charleslemaire0/TeenAstroHardware/MotorKit/NemaCovers/Nema23/ModelA/README.txt

Nema 23 & Nema 24 Motor Cover by IdefixRC on Thingiverse: https://www.thingiverse.com/thing:2481149
