charleslemaire0/TeenAstroHardware/Focuser/DrawingAluCase.png

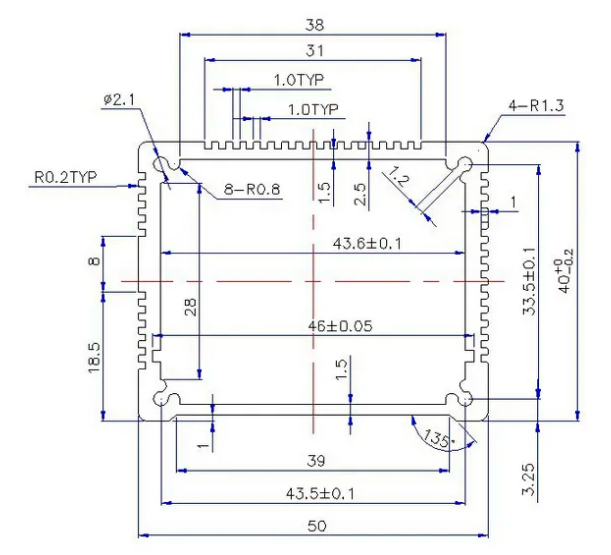
Focuser/DrawingAluCase.png
