charleslemaire0/TeenAstroHardware/Focuser/FocuserFrontPanel3D.png

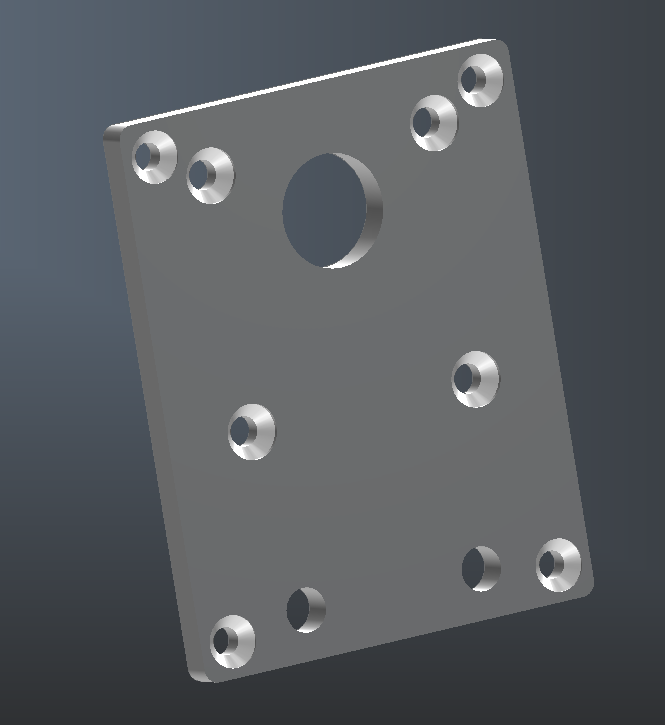
Focuser/FocuserFrontPanel3D.png
