charleslemaire0/TeenAstroHardware/Focuser/ZWO-Electronic-Automatic-Focuser-EAF-Standard-5V-.jpg

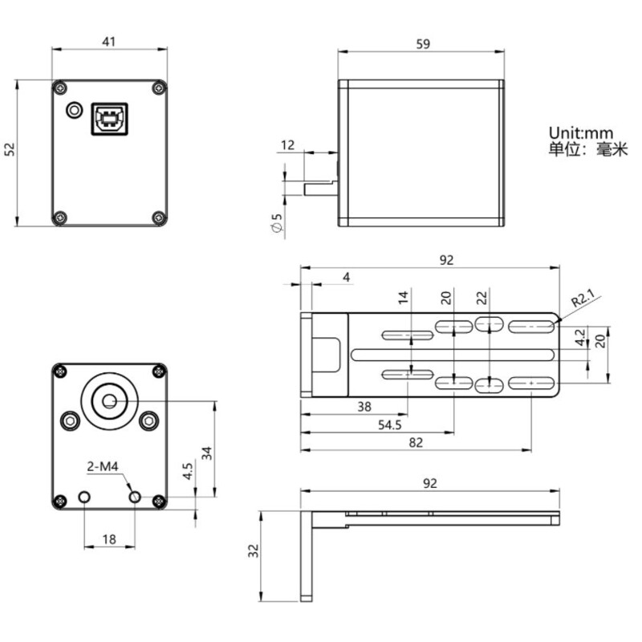
Focuser/ZWO-Electronic-Automatic-Focuser-EAF-Standard-5V-.jpg
