charleslemaire0/TeenAstroHardware/MainUnit/EQ6_Kit/V25/EQ6 - V2024_01/Doc/2_eclate.JPG

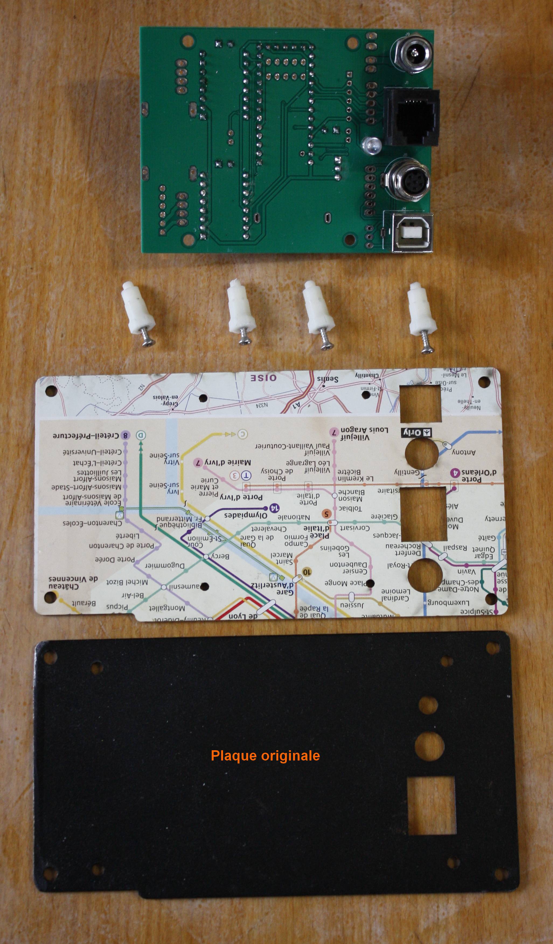
MainUnit/EQ6_Kit/V25/EQ6 - V2024_01/Doc/2_eclate.JPG
