charleslemaire0/TeenAstroHardware/MainUnit/EQ6_Kit/V25/EQ6 - V2024_01/Doc/Ci EQ6 dessus-dessous.jpg

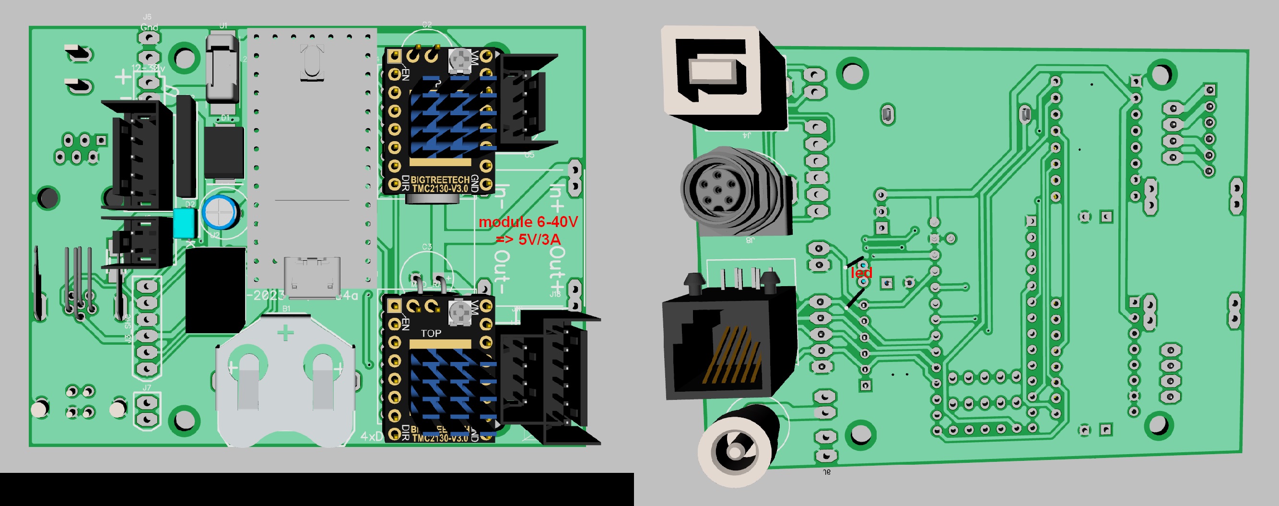
MainUnit/EQ6_Kit/V25/EQ6 - V2024_01/Doc/Ci EQ6 dessus-dessous.jpg
