charleslemaire0/TeenAstroHardware/MainUnit/EQ6_Kit/V25/EQ6 - V2024_01/Doc/TA EQ6 sur platine.jpg

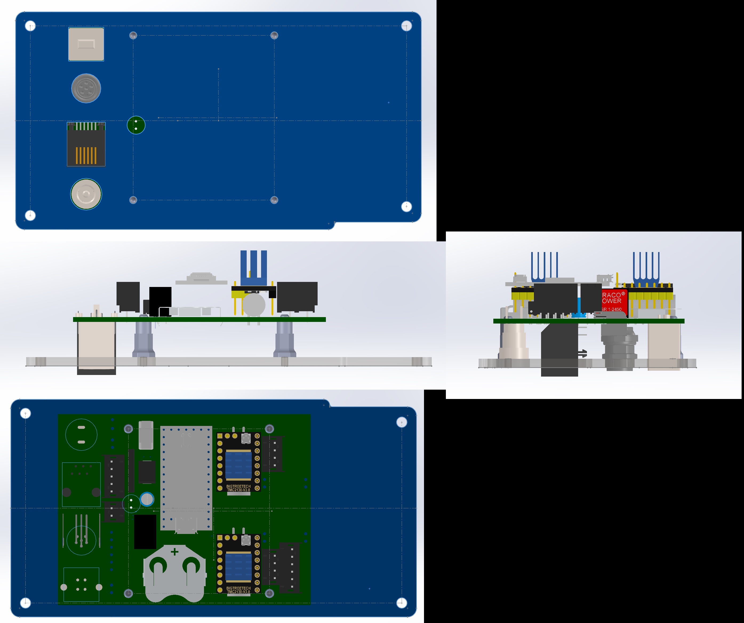
MainUnit/EQ6_Kit/V25/EQ6 - V2024_01/Doc/TA EQ6 sur platine.jpg
