charleslemaire0/TeenAstroHardware/MainUnit/Mini/V25/Eagle/TeenAstro_Mini_v253_M12_a3.png

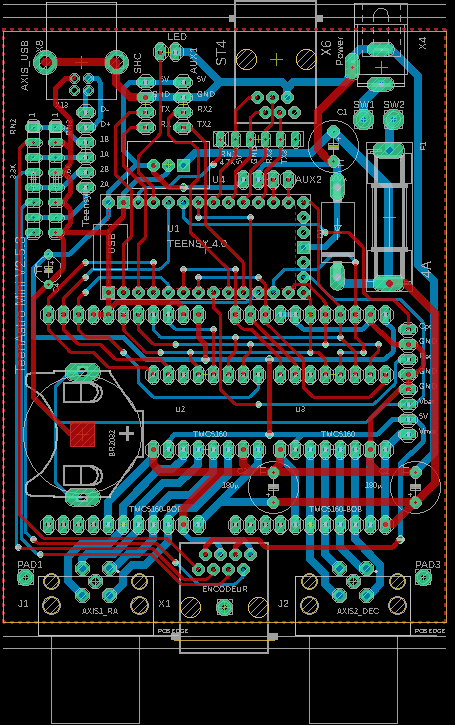
MainUnit/Mini/V25/Eagle/TeenAstro_Mini_v253_M12_a3.png
