charleslemaire0/TeenAstroHardware/MainUnit/Mini/V25/Fritzing/Geber/TeenAstroMiniV2.5.3_db9_pcb.jpg

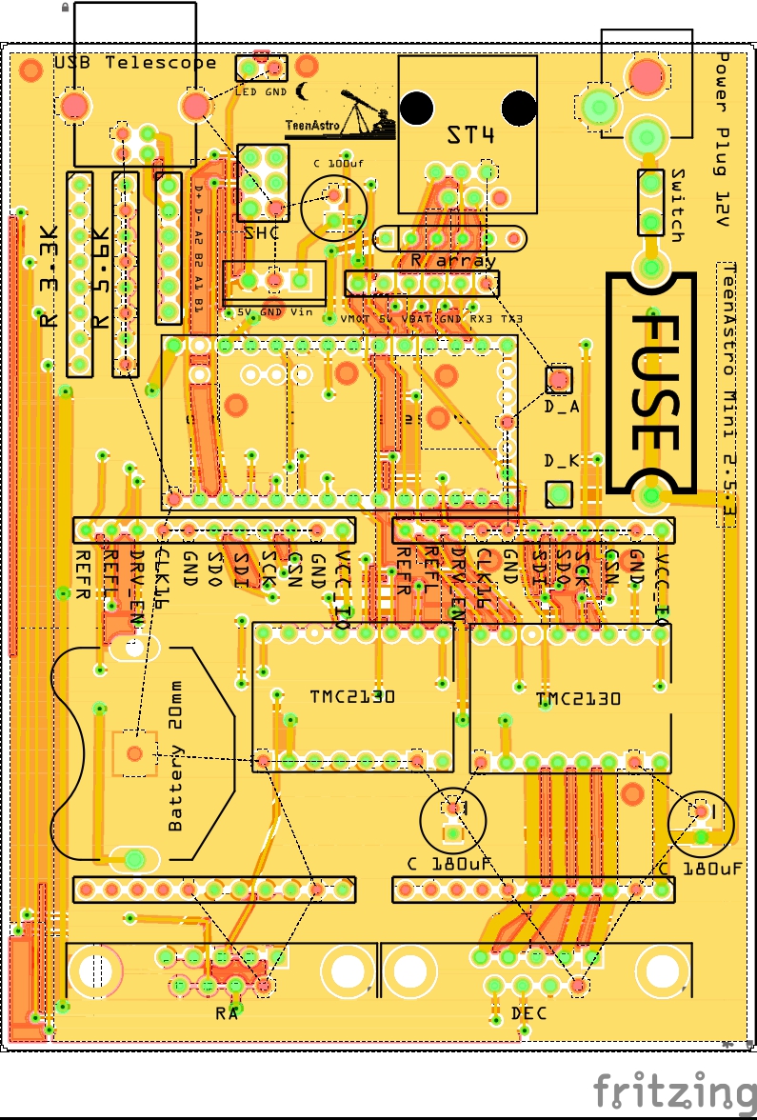
MainUnit/Mini/V25/Fritzing/Geber/TeenAstroMiniV2.5.3_db9_pcb.jpg
