charleslemaire0/TeenAstroHardware/MainUnit/Tiny/V25/Doc/Back.jpeg

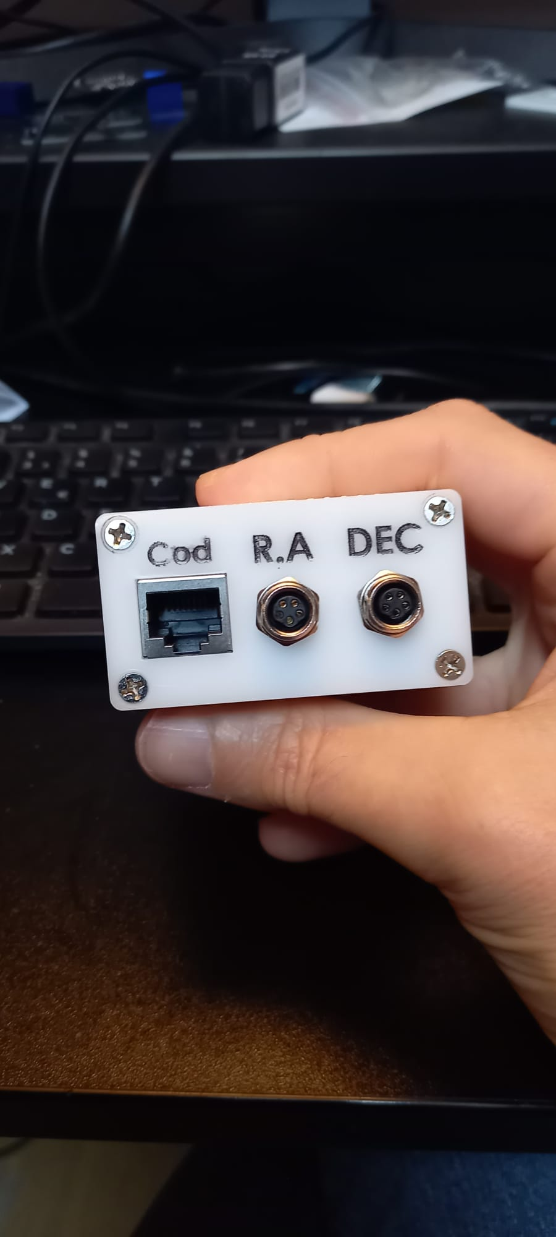
MainUnit/Tiny/V25/Doc/Back.jpeg
