charleslemaire0/TeenAstroHardware/MainUnit/Tiny/V25/Doc/Front.jpeg

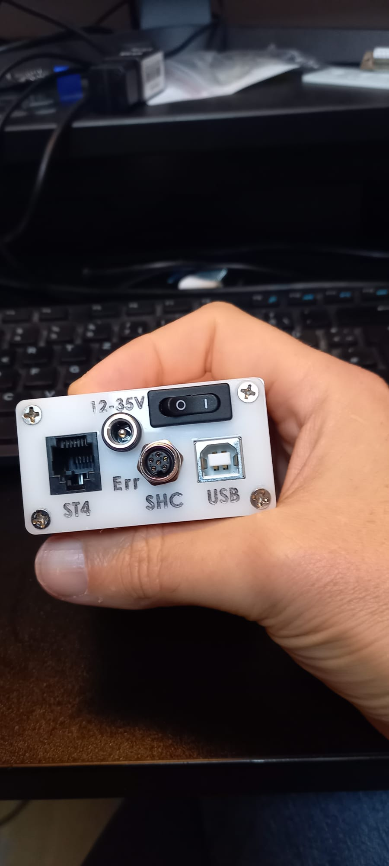
MainUnit/Tiny/V25/Doc/Front.jpeg
