charleslemaire0/TeenAstroHardware/MainUnit/Tiny/V25/Doc/MiniVsTiny.jpeg

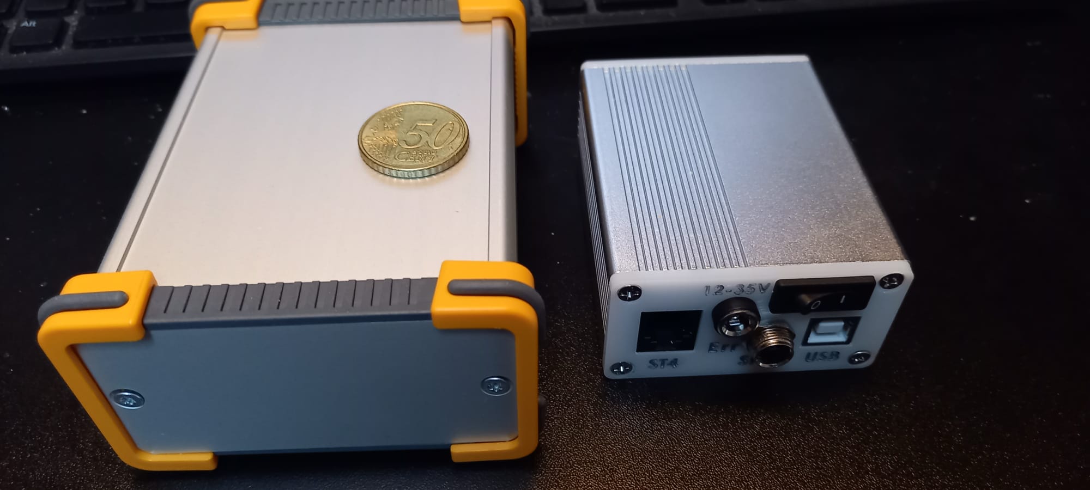
MainUnit/Tiny/V25/Doc/MiniVsTiny.jpeg
