charleslemaire0/TeenAstroHardware/MainUnit/Tiny/V25/Doc/tiny 250 a.JPG

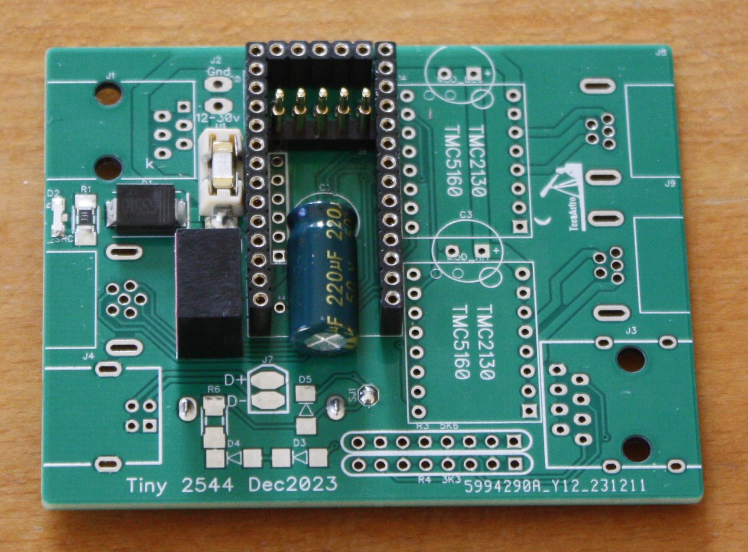
MainUnit/Tiny/V25/Doc/tiny 250 a.JPG
