charleslemaire0/TeenAstroHardware/MainUnit/Tiny/V25/Doc/Tiny 250 b.JPG

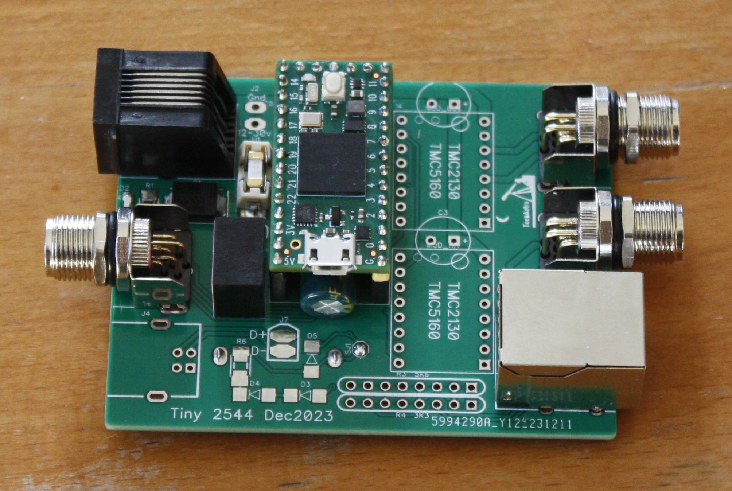
MainUnit/Tiny/V25/Doc/Tiny 250 b.JPG
