charleslemaire0/TeenAstroHardware/MainUnit/Tiny/V25/Doc/Tiny 250.jpg

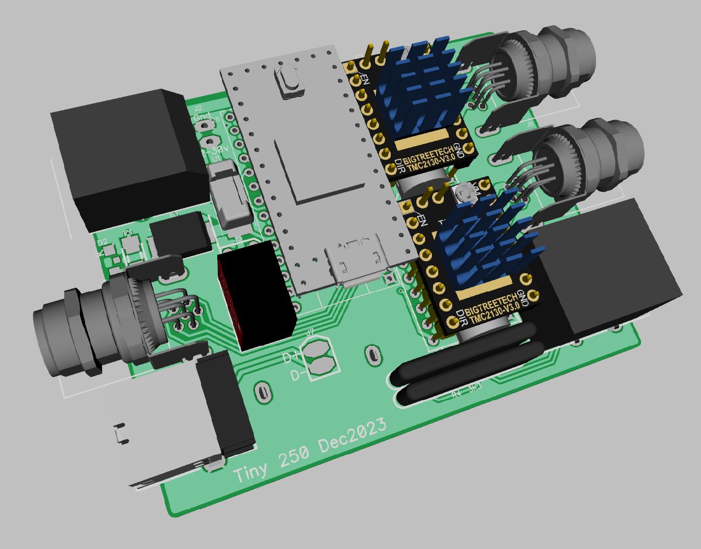
MainUnit/Tiny/V25/Doc/Tiny 250.jpg
