charleslemaire0/TeenAstroHardware/MainUnit/Tiny/V25/Doc/visuel tiny 2.png

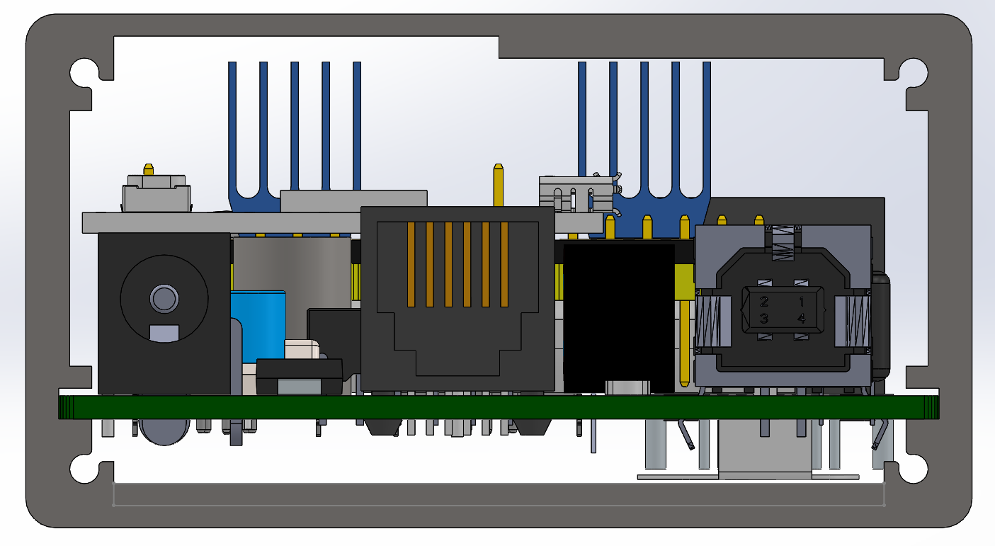
MainUnit/Tiny/V25/Doc/visuel tiny 2.png
