charleslemaire0/TeenAstroHardware/MainUnit/Tiny/V25/Source/DipTrace/Tiny 250.png

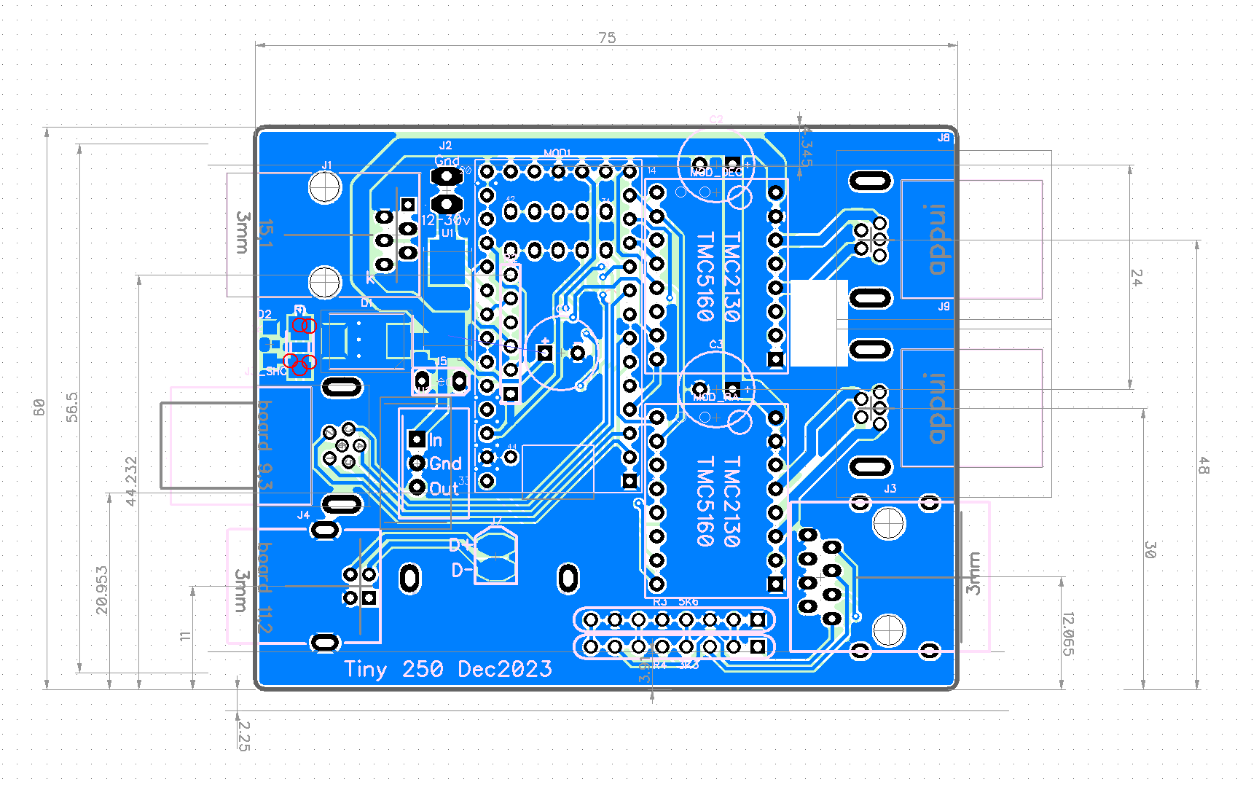
MainUnit/Tiny/V25/Source/DipTrace/Tiny 250.png
