charleslemaire0/TeenAstroHardware/MotorKit/NemaCovers/Nema17/Model A/Nema17Cover_A.png

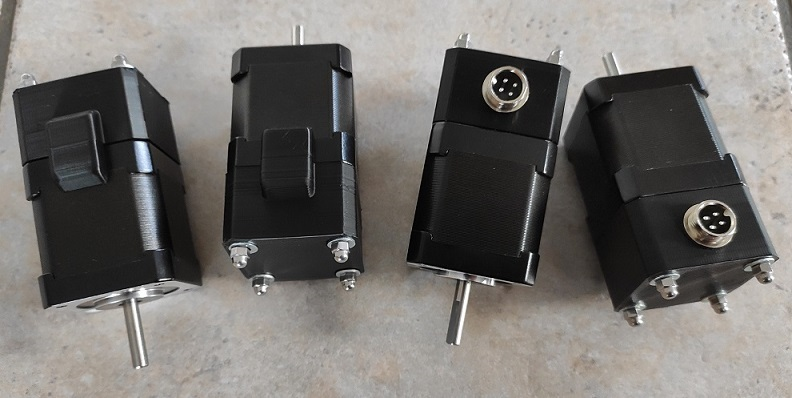
MotorKit/NemaCovers/Nema17/Model A/Nema17Cover_A.png
