charleslemaire0/TeenAstroHardware/MotorKit/NemaCovers/Nema23/ModelA/images/7e54231725088f2a09f0f0e1cd419129.jpg

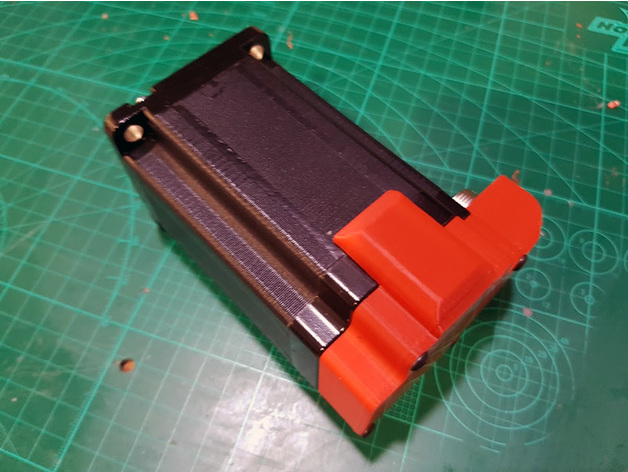
MotorKit/NemaCovers/Nema23/ModelA/images/7e54231725088f2a09f0f0e1cd419129.jpg
