charleslemaire0/TeenAstroHardware/MotorKit/NemaCovers/Nema23/ModelA/images/d00e7cbcc4604962befcf810bc58210a.jpg

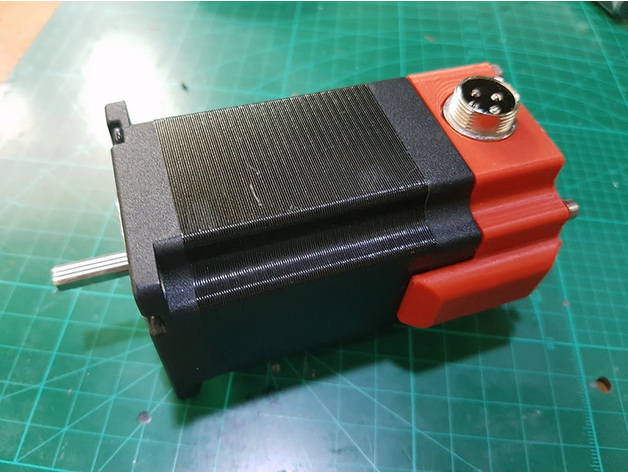
MotorKit/NemaCovers/Nema23/ModelA/images/d00e7cbcc4604962befcf810bc58210a.jpg
