charleslemaire0/TeenAstroHardware/MotorKit/NemaCovers/Nema23/ModelA/images/dcd5c36b3a7b25e8f30bb5cd8e7d59ce.jpg

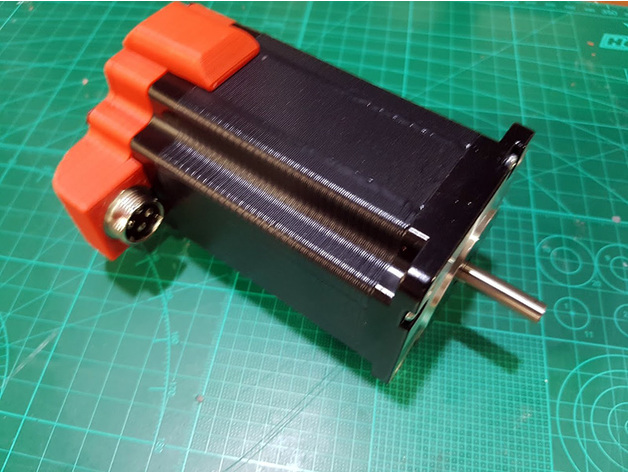
MotorKit/NemaCovers/Nema23/ModelA/images/dcd5c36b3a7b25e8f30bb5cd8e7d59ce.jpg
