charleslemaire0/TeenAstroHardware/MotorKit/NemaCovers/Nema23/ModelA/images/ebb65c65be9420c12031e5c384ebb469.jpg

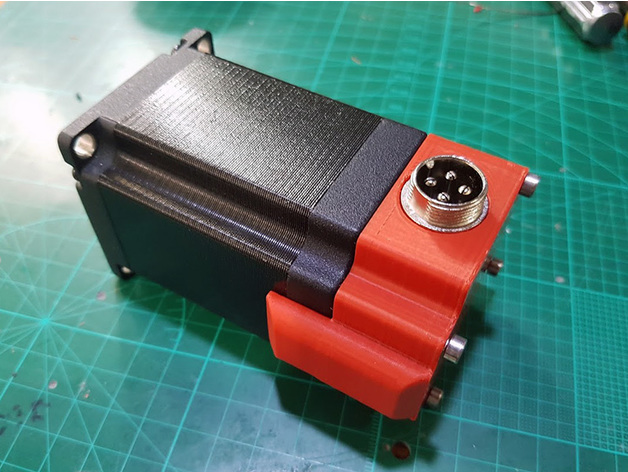
MotorKit/NemaCovers/Nema23/ModelA/images/ebb65c65be9420c12031e5c384ebb469.jpg
