charleslemaire0/TeenAstroHardware/MotorKit/NemaCovers/Nema23/ModelA/images/Motor_Cover_Nema23_straight.jpg

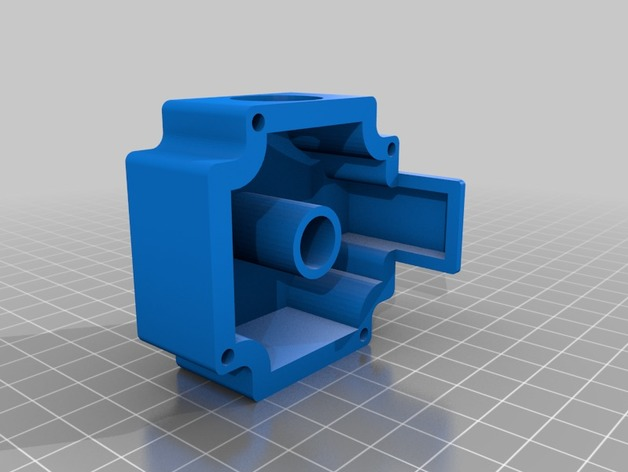
MotorKit/NemaCovers/Nema23/ModelA/images/Motor_Cover_Nema23_straight.jpg
