charleslemaire0/TeenAstroHardware/SHC/V1/PCB/Schematic_SHC.png

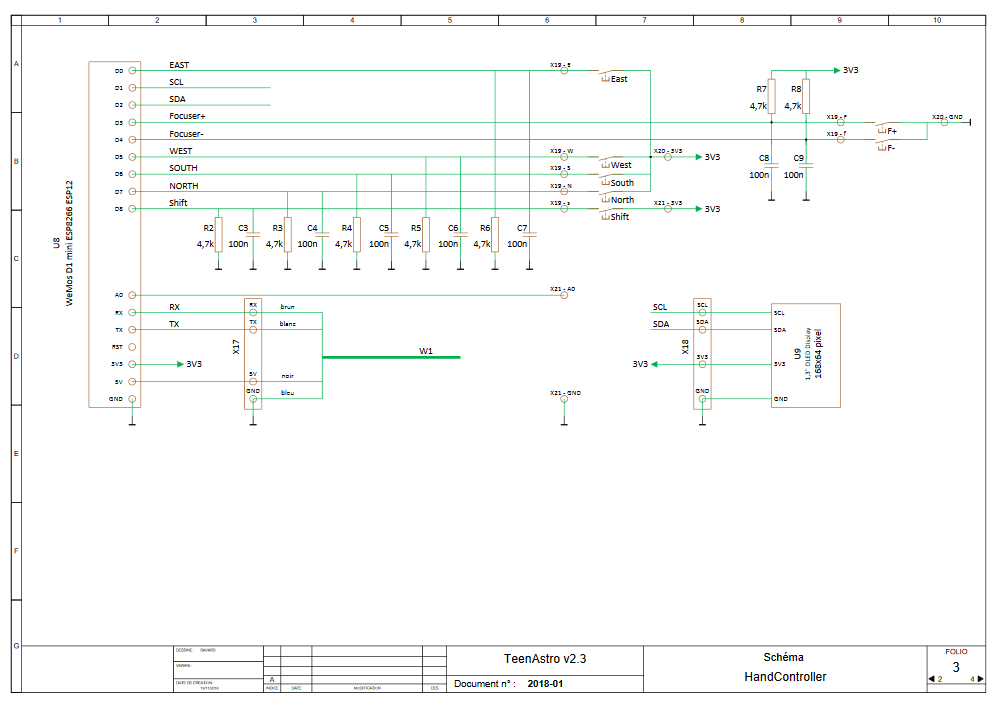
SHC/V1/PCB/Schematic_SHC.png
