charleslemaire0/TeenAstroHardware/SHC/V1/PCB/TeenAstroHand.jpg

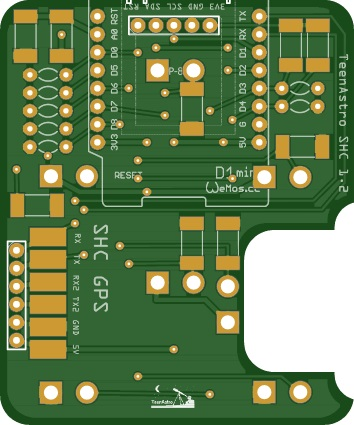
SHC/V1/PCB/TeenAstroHand.jpg
