charleslemaire0/TeenAstroHardware/MainUnit/Tiny/V25/Doc/Tiny BOM.ods

Ref | Tiny V2.5.0(teensy 4.0)
 | Chez Reichelt
 | CR 1632 Pile bouton au lithium, 3 V, 125 mAh, 16 x 3,2 mm (https://www.reichelt.de/de/fr/pile-bouton-au-lithium-3-v-125-mah-16-x-3-2-mm-cr-1632-p26546.html) |  | 1 |  |  | https://www.reichelt.de/de/fr/pile-bouton-au-lithium-3-v-125-mah-16-x-3-2-mm-cr-1632-p26546.html
D2 | LED SIDE3020 RT LED, CMS 3020, latérale, 112 mcd, rouge | 0.10 | 1 | 1 | 0.10 | https://www.reichelt.de/de/fr/led-cms-3020-lat-rale-112-mcd-rouge-led-side3020-rt-p156243.html
U1 | LITT 0154005.DR support avec fusible 5A fast | 1.15 | 1 |  | 1.15 | https://www.reichelt.de/de/fr/index.html?ACTION=446&LA=446&nbc=1&q=litt%200154005.dr
J1 | MEBP 6-6S Fiche intégrée modulaire RJ12 6/6, noire (https://www.reichelt.de/de/fr/fiche-int-gr-e-modulaire-6-6-noire-mebp-6-6s-p11370.html?&nbc=1) | 0.35 | 1 | 1 | 0.35 | https://www.reichelt.de/de/fr/fiche-int-gr-e-modulaire-6-6-noire-mebp-6-6s-p11370.html?&nbc=1
 | MPE 087-1-050 Barrette mâle 2,54 mm, 1× 50 – h12,6mm -6,8mm (https://www.reichelt.de/de/fr/barrette-m-le-2-54-mm-1-x-50-droite-mpe-087-1-050-p119891.html?&nbc=1) | 0.96 | 2 | 0 | 1.92 | https://www.reichelt.de/de/fr/barrette-m-le-2-54-mm-1-x-50-droite-mpe-087-1-050-p119891.html?&nbc=1
 | MPE 115-1-050 Barrette femelle de précisionH7mmX 50, dr oit 1×× (https://www.reichelt.de/de/fr/barrette-femelle-de-pr-cision-2-54-mm-1-x-50-droite-mpe-115-1-050-p187284.html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) | 4.00 | 2 | 0 | 8.00 | https://www.reichelt.de/de/fr/barrette-femelle-de-pr-cision-2-54-mm-1-x-50-droite-mpe-115-1-050-p187284.html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
C2, C3 | RAD FC 180/50 Condo électroAl 180 uF/50V 147mohm Ø8,2x21,5 (https://www.reichelt.de/de/fr/condensateurs-lectrolytiques-aluminium-180-uf-rad-fc-180-50-p84632.html?nbc=1) | 0.56 | 2 | 1 | 1.12 | https://www.reichelt.de/de/fr/condensateurs-lectrolytiques-aluminium-180-uf-rad-fc-180-50-p84632.html?nbc=1
C1 | RAD LXZ 50/100 Elko radial, 100µF, 50V, 105°C, Low ESR 120-248mes mOhm, 8,1 x 12,7- 3,5 (https://www.reichelt.de/de/fr/elko-radial-100-f-50-v-105-c-low-esr-8-x-12-mm-rm-3-5-rad-lxz-50-100-p166421.html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) | 0.22 | 1 | 1 | 0.22 | https://www.reichelt.de/de/fr/elko-radial-100-f-50-v-105-c-low-esr-8-x-12-mm-rm-3-5-rad-lxz-50-100-p166421.html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
D1 | S3D TSC 200V 3A-100A SMC | 0.25 | 1 | 1 | 0.25 | https://www.reichelt.de/de/fr/diode-de-redressement-200-v-3-a-smc-s3d-tsc-p216610.html?trstct=pos_1&nbc=1
R2 | SIL 6-5 4,7K Réseau de résistances SIL 4.7 kO ± 2 % (https://www.reichelt.de/de/fr/r-seau-de-r-sistances-sil-4-7-ko-2--sil-6-5-4-7k-p17821.html?&nbc=1) | 0.07 | 1 | 1 | 0.07 | https://www.reichelt.de/de/fr/r-seau-de-r-sistances-sil-4-7-ko-2--sil-6-5-4-7k-p17821.html?&nbc=1
R4 | SIL 8-4 3,3K Réseau de résistances SIL 3.3 kO ± 2 % (https://www.reichelt.de/de/fr/r-seau-de-r-sistances-sil-3-3-ko-2--sil-8-4-3-3k-p17925.html?&nbc=1) | 0.10 | 1 | 1 | 0.10 | https://www.reichelt.de/de/fr/r-seau-de-r-sistances-sil-3-3-ko-2--sil-8-4-3-3k-p17925.html?&nbc=1
R3 | SIL 8-4 5,6K Réseau de résistances SIL 5.6 kO ± 2 % (https://www.reichelt.de/de/fr/r-seau-de-r-sistances-sil-5-6-ko-2--sil-8-4-5-6k-p17940.html?&nbc=1) | 0.10 | 1 | 1 | 0.10 | https://www.reichelt.de/de/fr/r-seau-de-r-sistances-sil-5-6-ko-2--sil-8-4-5-6k-p17940.html?&nbc=1
MOD1 | TEENSY 4.0 Teensy 4.0, USB, sans en-tête (https://www.reichelt.de/de/fr/teensy-4-0-usb-sans-en-t-te-teensy-4-0-p269006.html?&nbc=1) | 29.75 | 1 | 1 | 29.75 | https://www.reichelt.de/de/fr/teensy-4-0-usb-sans-en-t-te-teensy-4-0-p269006.html?&nbc=1
U2 | Traco TSR 2-2450 Convertisseur c.c./c.c., 2 A, 5 V c.c. (https://www.reichelt.de/de/fr/convertisseur-c-c-c-c-2-a-5-v-c-c--tsr-2-2450-p193097.html?&nbc=1) | 13.13 | 1 | 0 | 13.13 | https://www.reichelt.de/de/fr/convertisseur-c-c-c-c-2-a-5-v-c-c--tsr-2-2450-p193097.html?&nbc=1
J4 | USB BW Prise femelle pour appareil USB type b 4P (https://www.reichelt.de/de/fr/prise-femelle-pour-appareil-usb-type-b-4p-usb-bw-p22186.html?&nbc=1) | 0.35 | 1 | 1 | 0.35 | https://www.reichelt.de/de/fr/prise-femelle-pour-appareil-usb-type-b-4p-usb-bw-p22186.html?&nbc=1
R1 | VIT ZC207 280R - MELF Resistor, 0207, 280 Ohm, 1 W, 1% (https://www.reichelt.de/de/fr/r-sistance-melf-0207-280-ohms-1-w-1--vit-zc207-280r-p277857.html) | 0.13 | 1 |  | 0.13 | https://www.reichelt.de/de/fr/r-sistance-melf-0207-280-ohms-1-w-1--vit-zc207-280r-p277857.html
 | WIPPE 1901.1103 Interrupteurs étroit à bascule 1P 6 A AC1 250 VAC (https://www.reichelt.de/de/fr/interrupteurs-bascule-1p-6-a-ac1-250-vac-wippe-1901-1103-p108251.html?nbc=1) | 1.66 | 1 | 1 | 1.66 | https://www.reichelt.de/de/fr/prise-femelle-pour-appareil-usb-type-b-4p-usb-bw-p22186.html?&nbc=1
 | Chez Aliexpress
 | boitier alu Tiny 75*62*35 /4 | 6.64 | 1 |  | 6.64 | /item/1867710921
 | Cable M8-6pin M to M 2m | 21.1 | 1 | 0 | 21.10 | https://fr.aliexpress.com/item/1005005256945807.html
J8, J9 | M8-5pin pcb mount -Angled Female, 5Pin B Type | 8.255 | 2 |  | 16.51 | item/1005003311923102.html
J3 | M8-6pin pcb mount -Angled Female, 6Pin | 12.61 | 1 |  | 12.61 | item/1005003311923102.html
 | Pogo 11,5mm 5 pin pour liaison encodeur | 1.655 | 1 |  | 1.66 | https://fr.aliexpress.com/item/1005005380466642.html
J2 | Prise c.c. - Panel mount - DC-022B, 10PCS, 5.5X2.5MM | 1.13 | 1 |  | 1.13 | https://fr.aliexpress.com/item/1005004637388048.html
J3 | RJ45 8P8C /5 | 0.56 | 1 |  | 0.56 | Item/1005004718158563
B1 | Support de pile bouton, 10 pièces, CR1632 | 3.07 | 1 | 1 | 3.07 | https://fr.aliexpress.com/item/4000505055015.html
MOD_DEC, MOD_RA | TMC2130 | 5.87 | 2 | choix | 11.74 | https://fr.aliexpress.com/item/1005001540781583.html
 | TMC5160 SPI 4 mosfet proche de la version reilchelt OK | 11.375 | 2 | choix | 22.75 | https://fr.aliexpress.com/item/1005004609091020.html
 | TMC5160 SPI 8 mosfet | 15.18 | 2 | choix | 30.36 | https://fr.aliexpress.com/item/1005005219358395.html
 | Alternative source
U1 | Fusible 1808-4A /10 | 0.12 | 2 |  | 0.23 | https://fr.aliexpress.com/item/33048094198
U1 | Support Fusible 1808 /10 | 0.15 | 1 |  | 0.15 | https://fr.aliexpress.com/item/33048094198
U2 | Traco TSR 1-2450 par5 | 2.388 | 1 |  | 2.39 | https://fr.aliexpress.com/item/1005004376426371.html
