charleslemaire0/TeenAstroHardware/MainUnit/EQ6_Kit/V25/EQ6 - V2024_01/Doc/BOM EQ6.ods

EQ6 V2.5.0 (teensy 4.0)
 |  | Reichelt |  | 61.39
B1 | BR 2032 Pile bouton au lithium, 3 V, 180 mAh, 20,0 x 3,2 mm (https://www.reichelt.de/de/fr/pile-bouton-au-lithium-3-v-180-mah-20-0-x-3-2-mm-br-2032-p5827.html?nbc=1) | 1.21 | 1 | 1.21 | https://www.reichelt.de/de/fr/led-avec-r-sistance-en-s-rie-rouge-3-mm-5-volts-led-3mm-5v-rt-p54090.html?nbc=1
B1 | KZH 20P Clip de pile bouton, pour circuit imprimé (https://www.reichelt.de/de/fr/clip-de-pile-bouton-pour-circuit-imprim--kzh-20p-p56575.html?&nbc=1) | 0.41 | 1 | 0.41 | https://www.reichelt.de/de/fr/led-avec-r-sistance-en-s-rie-rouge-3-mm-5-volts-led-3mm-5v-rt-p54090.html?nbc=1
C1 | RAD LXZ 50/100 Elko radial, 100µF, 50V, 105°C, Low ESR 120-248mes mOhm, 8,1 x 12,7- 3,5 (https://www.reichelt.de/de/fr/elko-radial-100-f-50-v-105-c-low-esr-8-x-12-mm-rm-3-5-rad-lxz-50-100-p166421.html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) | 0.22 | 1 | 0.22 | https://www.reichelt.de/de/fr/elko-radial-100-f-50-v-105-c-low-esr-8-x-12-mm-rm-3-5-rad-lxz-50-100-p166421.html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
C2,C3 | RAD FC 180/50 Condo électroAl 180 uF/50V 147mohm Ø8,2x21,5 (https://www.reichelt.de/de/fr/condensateurs-lectrolytiques-aluminium-180-uf-rad-fc-180-50-p84632.html?nbc=1) | 0.56 | 2 | 1.12 | https://www.reichelt.de/de/fr/condensateurs-lectrolytiques-aluminium-180-uf-rad-fc-180-50-p84632.html?nbc=1
D1 | S3D TSC 200V 3A-100A SMC | 0.25 | 1 | 0.25 | https://www.reichelt.de/de/fr/diode-de-redressement-200-v-3-a-smc-s3d-tsc-p216610.html?trstct=pos_1&nbc=1
D2 | LED 3MM 5V RT LED avec résistance en série rouge 3 mm, 5 volts (https://www.reichelt.de/de/fr/led-avec-r-sistance-en-s-rie-rouge-3-mm-5-volts-led-3mm-5v-rt-p54090.html?nbc=1) | 0.60 | 1 | 0.60 | https://www.reichelt.de/de/fr/led-avec-r-sistance-en-s-rie-rouge-3-mm-5-volts-led-3mm-5v-rt-p54090.html?nbc=1
D2 | EBF A-3 Culot d"installation pour LED 3 mm, réflecteur extérieur, chrome (https://www.reichelt.de/de/fr/culot-d-installation-3-mm-r-flecteur-ext-rieur-chrome-ebf-a-3-p7286.html?nbc=1) | 0.95 | 1 | 0.95 | https://www.reichelt.de/de/fr/culot-d-installation-3-mm-r-flecteur-ext-rieur-chrome-ebf-a-3-p7286.html?nbc=1
MOD1 | TEENSY 4.0 Teensy 4.0, USB, sans en-tête (https://www.reichelt.de/de/fr/teensy-4-0-usb-sans-en-t-te-teensy-4-0-p269006.html?&nbc=1) | 29.75 | 1 | 29.75 | https://www.reichelt.de/de/fr/led-avec-r-sistance-en-s-rie-rouge-3-mm-5-volts-led-3mm-5v-rt-p54090.html?nbc=1
R1 | VIT ZC207 280R - MELF Resistor, 0207, 280 Ohm, 1 W, 1% (https://www.reichelt.de/de/fr/r-sistance-melf-0207-280-ohms-1-w-1--vit-zc207-280r-p277857.html) | 0.13 | 1 | 0.13 | https://www.reichelt.de/de/fr/r-sistance-melf-0207-280-ohms-1-w-1--vit-zc207-280r-p277857.html
R2 | SIL 6-5 4,7K Réseau de résistances SIL 4.7 kO ± 2 % (https://www.reichelt.de/de/fr/r-seau-de-r-sistances-sil-4-7-ko-2--sil-6-5-4-7k-p17821.html?&nbc=1) | 0.07 | 1 | 0.07 | https://www.reichelt.de/de/fr/r-seau-de-r-sistances-sil-4-7-ko-2--sil-6-5-4-7k-p17821.html?&nbc=1
R3 | VIT ZC207 100K Résistance MELF, 0207, 100 kohms, 1 W, 1 % (https://www.reichelt.de/de/fr/r-sistance-melf-0207-100-kohms-1-w-1--vit-zc207-100k-p277891.html) | 0.13 | 1 | 0.13 | https://www.reichelt.de/de/fr/r-sistance-melf-0207-100-kohms-1-w-1--vit-zc207-100k-p277891.html
S1 | WIPPE 1901.1103 Interrupteurs étroit à bascule 1P 6 A AC1 250 VAC (https://www.reichelt.de/de/fr/interrupteurs-bascule-1p-6-a-ac1-250-vac-wippe-1901-1103-p108251.html?nbc=1) | 1.66 | 1 | 1.66 | https://www.reichelt.de/de/fr/prise-femelle-pour-appareil-usb-type-b-4p-usb-bw-p22186.html?&nbc=1
U1 | LITT 0154005.DR support avec fusible 5A fast | 1.15 | 1 | 1.15 | https://www.reichelt.de/de/fr/index.html?ACTION=446&LA=446&nbc=1&q=litt%200154005.dr
U2 | Traco TSR 2-2450 Convertisseur c.c./c.c., 2 A, 5 V c.c. (https://www.reichelt.de/de/fr/convertisseur-c-c-c-c-2-a-5-v-c-c--tsr-2-2450-p193097.html?&nbc=1) | 13.13 | 1 | 13.13 | https://www.reichelt.de/de/fr/convertisseur-c-c-c-c-2-a-5-v-c-c--tsr-2-2450-p193097.html?&nbc=1
 | MPE 115-1-050 Barrette femelle de précisionH7mmX 50, dr oit 1×× (https://www.reichelt.de/de/fr/barrette-femelle-de-pr-cision-2-54-mm-1-x-50-droite-mpe-115-1-050-p187284.html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) | 4.00 | 2 | 8.00 | https://www.reichelt.de/de/fr/barrette-femelle-de-pr-cision-2-54-mm-1-x-50-droite-mpe-115-1-050-p187284.html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
 | MPE 115-1-014 Barrette femelle de précision 2,54 mm, 1 X 14, droite (https://www.reichelt.de/de/fr/barrette-femelle-de-pr-cision-2-54-mm-1-x-14-droite-mpe-115-1-014-p187278.html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) | 1.07 | 2 | 2.14 | https://www.reichelt.de/de/fr/barrette-femelle-de-pr-cision-2-54-mm-1-x-14-droite-mpe-115-1-014-p187278.html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
 | MPE 115-1-005 Barrette femelle de précision 2,54 mm, 1 X 05, droite (https://www.reichelt.de/de/fr/barrette-femelle-de-pr-cision-2-54-mm-1-x-05-droite-mpe-115-1-005-p119953.html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) | 0.47 | 1 | 0.47 | https://www.reichelt.de/de/fr/barrette-femelle-de-pr-cision-2-54-mm-1-x-05-droite-mpe-115-1-005-p119953.html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
 |  | Aliexpress |  | 26.21
J1 | Connecteur femelle RJ11 Vertical 52-6P6C /10Pcs | 0.22 | 1 | 0.22 | https://fr.aliexpress.com/item/1005004828715842.html
J4 | USB-B Vertical PCB /10pcs | 0.26 | 1 | 0.26 | https://fr.aliexpress.com/item/1005002711012209.html
J8 | M8-6pin pcb mount Female PCB Earth, 6Pin | 10.24 | 1 | 10.24 | https://fr.aliexpress.com/item/1005003311923102.html
J9 | Prise c.c. - Panel mount - DC-022B, 10PCS, 5.5X2.5MM /10pcs | 0.138 | 1 | 0.14 | https://fr.aliexpress.com/item/1005004637388048.html
MOD_DEC, MOD_RA | TMC2130 (SPI) | 5.87 | 2 | 11.74 | https://fr.aliexpress.com/item/1005001540781583.html
U5 (option) | Buck 6-40V 5Vor 12V /3A (option for RPI alim or heat band) | 2.69 | 1 | 2.69 | https://fr.aliexpress.com/item/1005005505907937.html
 | adaptateur µUSBmale type G /5 | 0.922 | 1 | 0.92 | https://fr.aliexpress.com/item/1005002320414960.html
 | Alternative source
U1 | Fusible 1808-4A /10 | 0.12 | 2 | 0.23 | https://fr.aliexpress.com/item/33048094198
U1 | Support Fusible 1808 /10 | 0.15 | 1 | 0.15 | https://fr.aliexpress.com/item/33048094198
U2 | Traco TSR 1-2450 par5 | 2.388 | 1 | 2.39 | https://fr.aliexpress.com/item/1005004376426371.html
