charleslemaire0/TeenAstroHardware/MainUnit/EQ6_Kit/V25/EQ6 - V2024_01/Source/CAO SW2017/CAO CI/CI EQ6.SLDASM

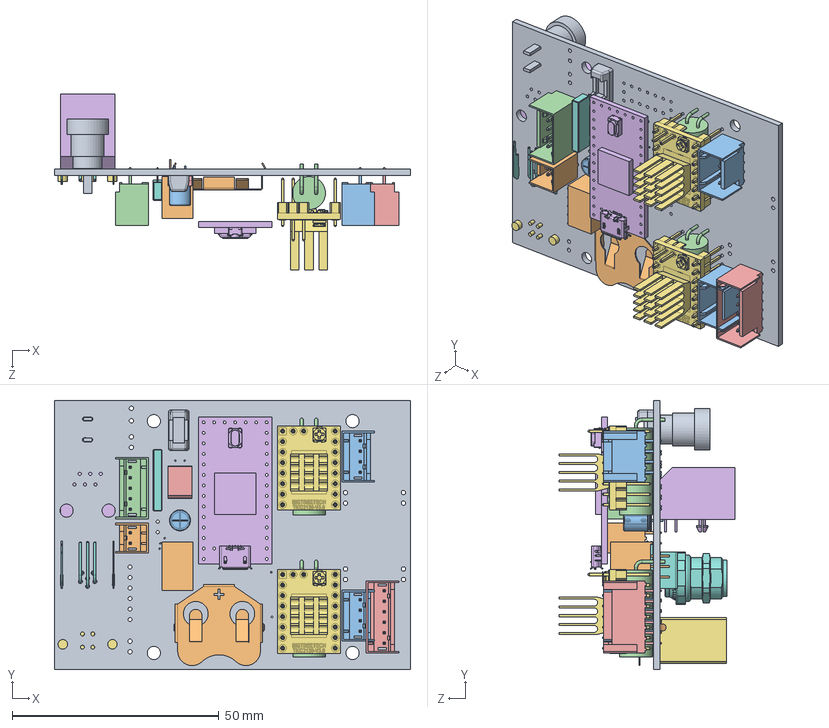
[picture p31: CAD file, 2024-02-11]
MainUnit/EQ6_Kit/V25/EQ6 - V2024_01/Source/CAO SW2017/CAO CI/CI EQ6.SLDASM
86.0 x 65.0 x 42.4 mm
Board_CI_EQ6
CLIP_CR2032_RS_PRO_2378331
cappr-2.54_5.08
D8x20coude x 2
diode_SMD_DO214_S5DC-13-F
SS-90000-003
USB_B_droit
M8_6pin_elbow_PCB
DC_55x25_droit
hdr-1x2t_2.54_sh7x8
hdr-1x4t_2.54_sh12x8 x 2
hdr-1x5t_2.54_sh15x8
hdr-1x6t_2.54_sh17x8
Teensy_4.0_Assembly
TMC2130-V3.0 x 2
sip-6_14.7x2x2.54
suport_fusible_SMD
TSR_1-2450
