charleslemaire0/TeenAstroHardware/MainUnit/Tiny/V25/Source/CAO SW2017/board tiny/tiny.SLDASM

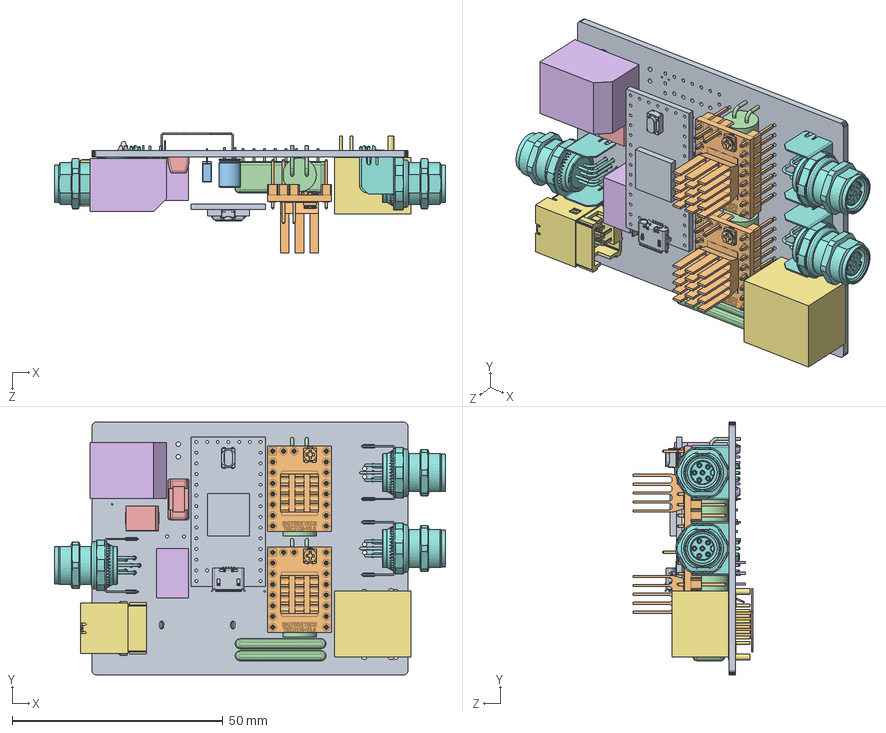
[picture p32: CAD file, 2024-01-28]
MainUnit/Tiny/V25/Source/CAO SW2017/board tiny/tiny.SLDASM
92.8 x 60.0 x 28.4 mm
Board_tiny
clip_CR1620
cappr-2.54_5.08
D8x20coude x 2
diode_SMD_DO214_S5DC-13-F
SS-90000-003
RJE091884111A
M8_6pin_elbow_PCB x 3
Teensy_4.0_Assembly
TMC2130-V3.0 x 2
sip-6_14.7x2x2.54
sip-8_21.6x2.4x2.54 x 2
suport_fusible_SMD
TSR_1-2450
