charleslemaire0/TeenAstroHardware/MainUnit/EQ6_Kit/V25/EQ6 - V2024_01/CAO Panel/111b facade EQ6.DXF

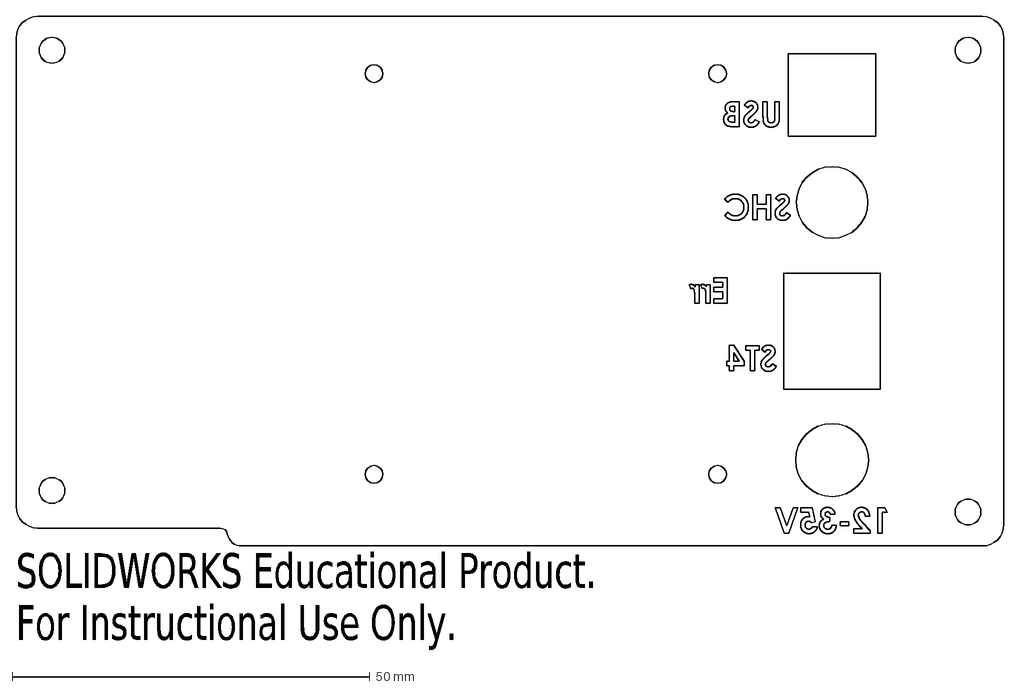
[picture p33: CAD file, 2024-02-11]
MainUnit/EQ6_Kit/V25/EQ6 - V2024_01/CAO Panel/111b facade EQ6.DXF
SOLIDWORKS Educational Product.
For Instructional Use Only.
