charleslemaire0/TeenAstroHardware/MainUnit/Tiny/V25/Source/CAO SW2017/190 boitier tiny.SLDPRT

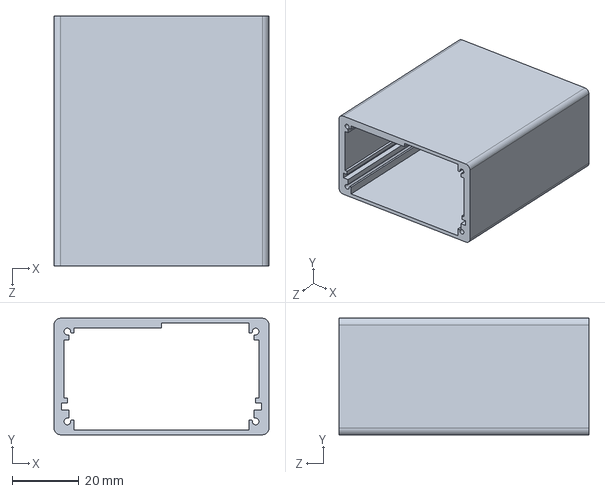
[picture p35: CAD file, 2024-01-28]
MainUnit/Tiny/V25/Source/CAO SW2017/190 boitier tiny.SLDPRT
64.5 x 35.0 x 75.0 mm
