charleslemaire0/TeenAstroHardware/MotorKit/AP400/AP 400 QMD Motor Housing.stl

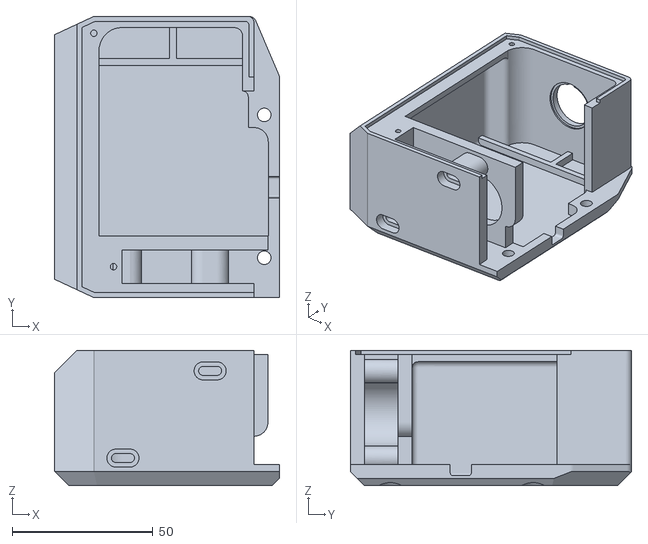
[picture p36: CAD file, 2023-02-04]
MotorKit/AP400/AP 400 QMD Motor Housing.stl
80.0 x 100.0 x 48.0
