charleslemaire0/TeenAstroHardware/MotorKit/Kit_EQ6_EM200/case/Front.stl

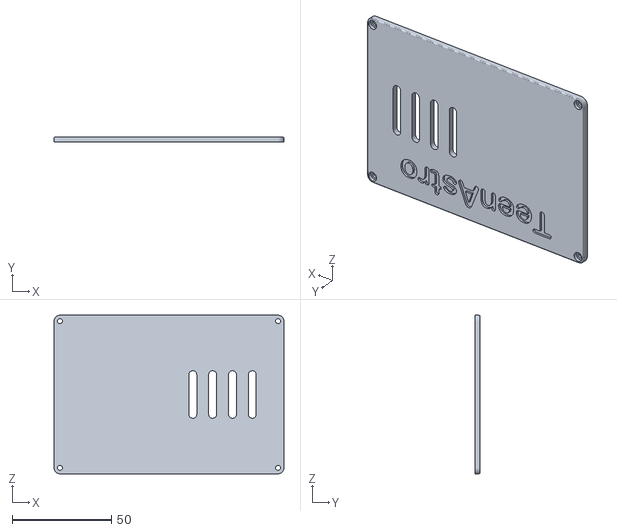
[picture p37: CAD file, 2023-02-04]
MotorKit/Kit_EQ6_EM200/case/Front.stl
116.0 x 2.50 x 80.0
