charleslemaire0/TeenAstroHardware/MotorKit/Kit_EQ6_EM200/Motorplate for EM200/Plate Motor DEC.stp

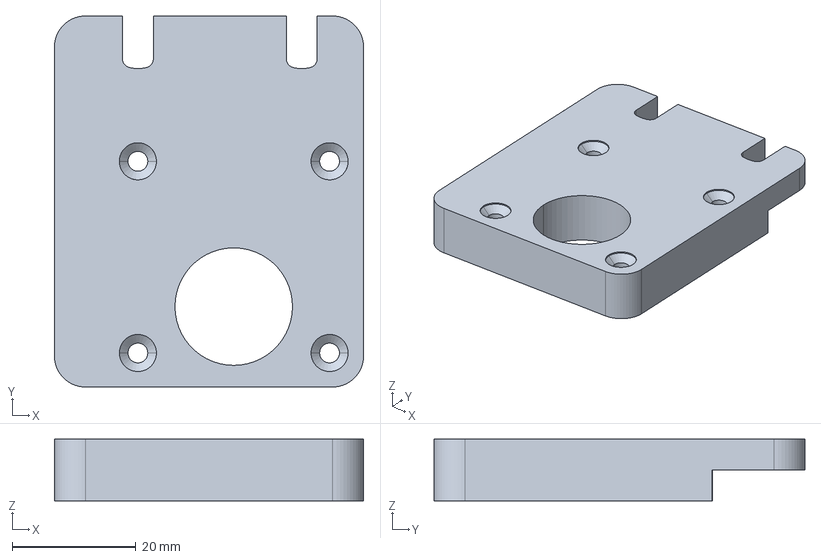
[picture p38: CAD file, 2023-02-04]
MotorKit/Kit_EQ6_EM200/Motorplate for EM200/Plate Motor DEC.stp
50.0 x 60.0 x 10.0 mm
