charleslemaire0/TeenAstroHardware/MotorKit/NemaCovers/Nema17/Model A/NEMA17_Cover_A.stl

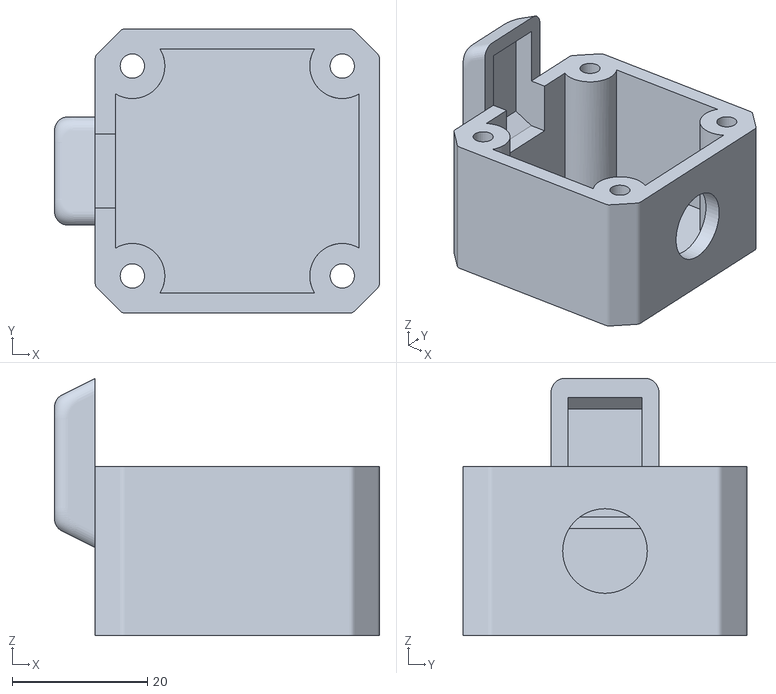
[picture p39: CAD file, 2023-07-23]
MotorKit/NemaCovers/Nema17/Model A/NEMA17_Cover_A.stl
48.0 x 42.0 x 38.0
