charleslemaire0/TeenAstroHardware/MotorKit/NemaCovers/Nema23/ModelA/files/Motor_Cover_Nema24_straight.STL

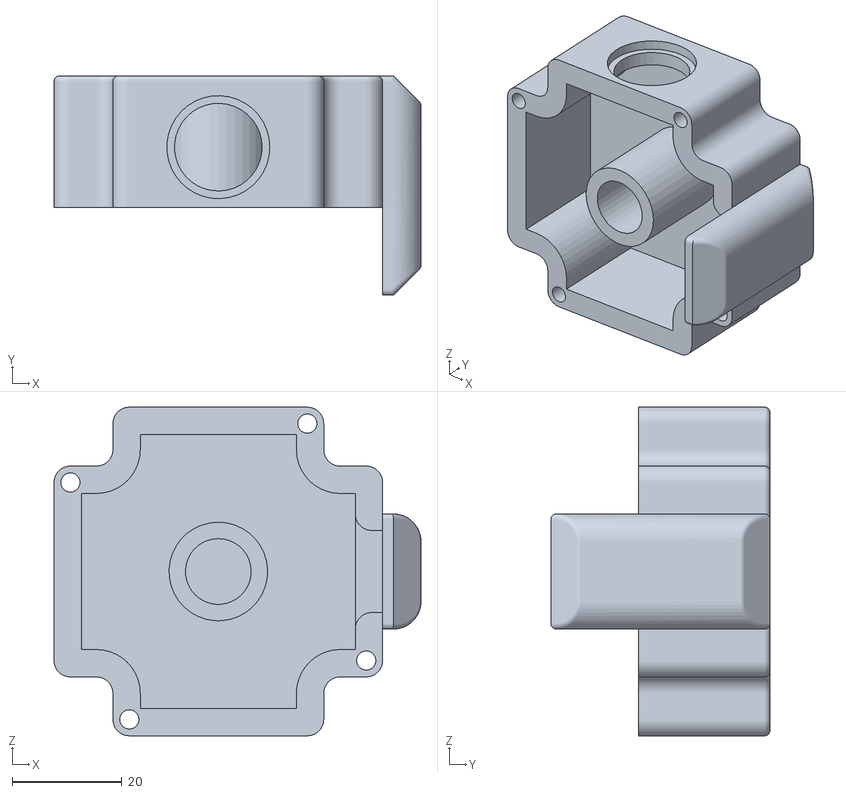
[picture p40: CAD file, 2023-07-23]
MotorKit/NemaCovers/Nema23/ModelA/files/Motor_Cover_Nema24_straight.STL
67.0 x 40.0 x 60.0
