charleslemaire0/TeenAstroHardware/MotorKit/Vixen_GP-D2/v1.2 Vixen GPD2 NEMA 17 40mm SUB-D9 adapter.stl

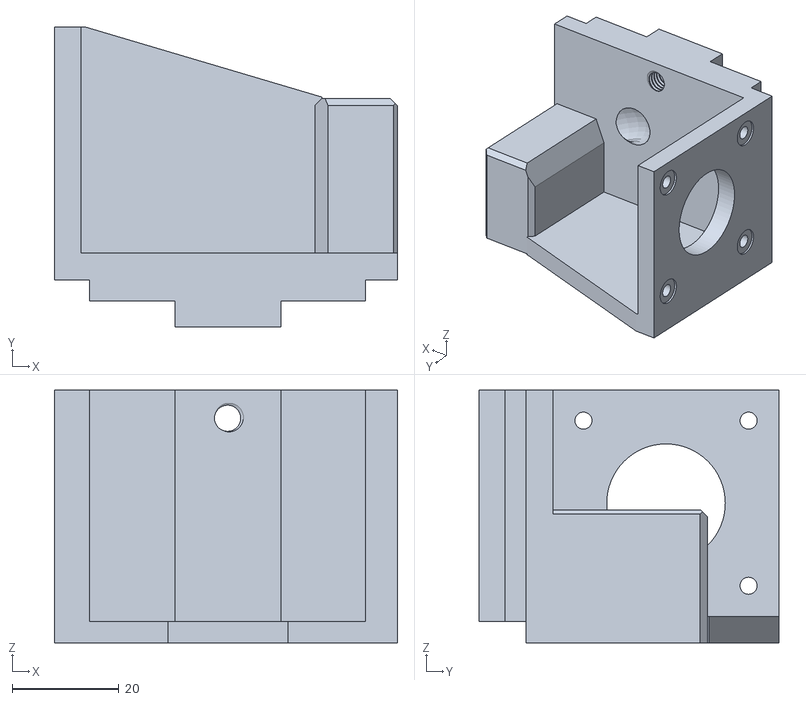
[picture p41: CAD file, 2023-02-04]
MotorKit/Vixen_GP-D2/v1.2 Vixen GPD2 NEMA 17 40mm SUB-D9 adapter.stl
64.4 x 56.4 x 47.5
