charleslemaire0/TeenAstroHardware/MainUnit/EQ6_Kit/V25/EQ6 - V2024_01/CAO Panel/112 entretoise_12mm.STL

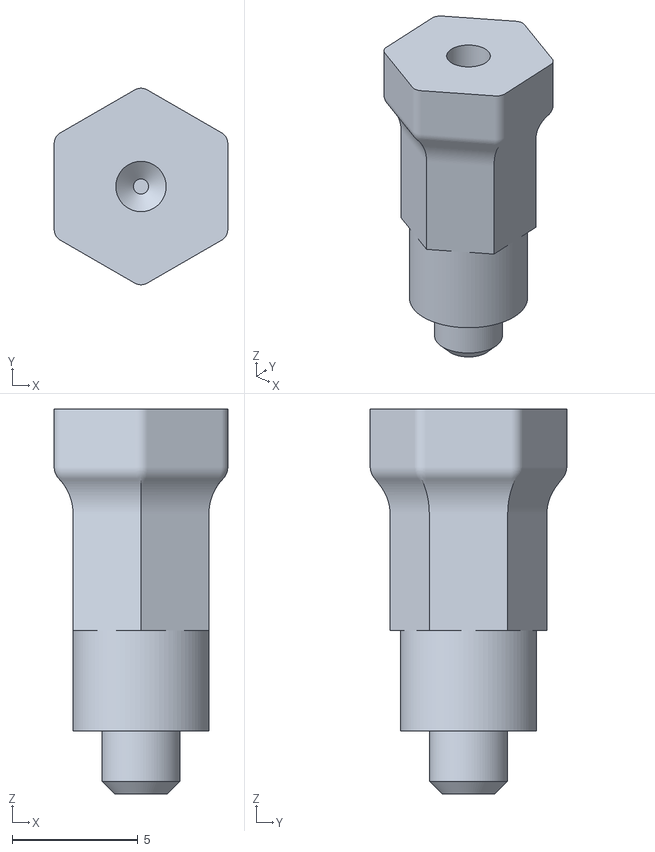
[picture p42: CAD file, 2024-02-11]
MainUnit/EQ6_Kit/V25/EQ6 - V2024_01/CAO Panel/112 entretoise_12mm.STL
6.90 x 7.81 x 15.3
