charleslemaire0/TeenAstroHardware/MainUnit/Tiny/V25/CAO Panel/112 tiny-back.STEP

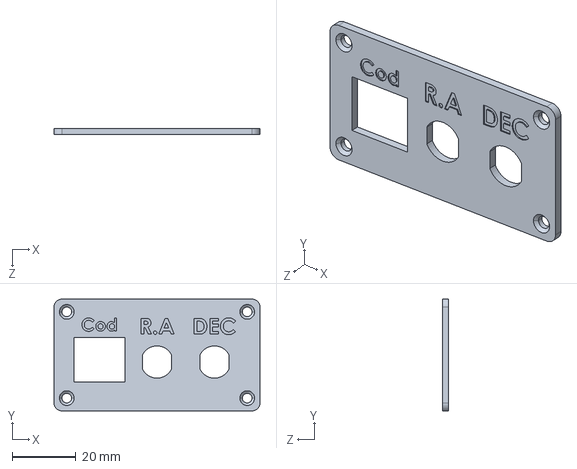
[picture p43: CAD file, 2024-01-28]
MainUnit/Tiny/V25/CAO Panel/112 tiny-back.STEP
64.5 x 35.0 x 2.00 mm
