charleslemaire0/TeenAstroHardware/MotorKit/AP400/AP 400 QMD Motor Housing Lid.stl

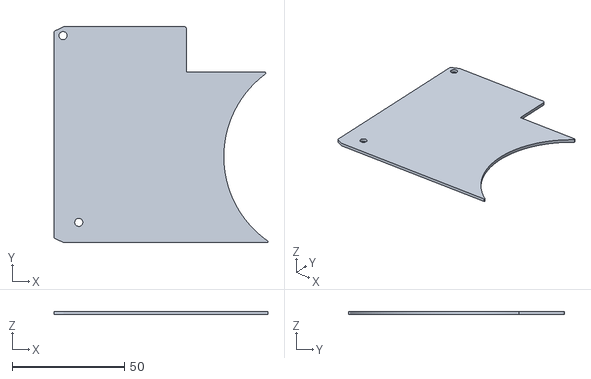
[picture p44: CAD file, 2023-02-04]
MotorKit/AP400/AP 400 QMD Motor Housing Lid.stl
95.1 x 95.9 x 1.50
