charleslemaire0/TeenAstroHardware/MotorKit/Kit_EQ6_EM200/case/Case.stl

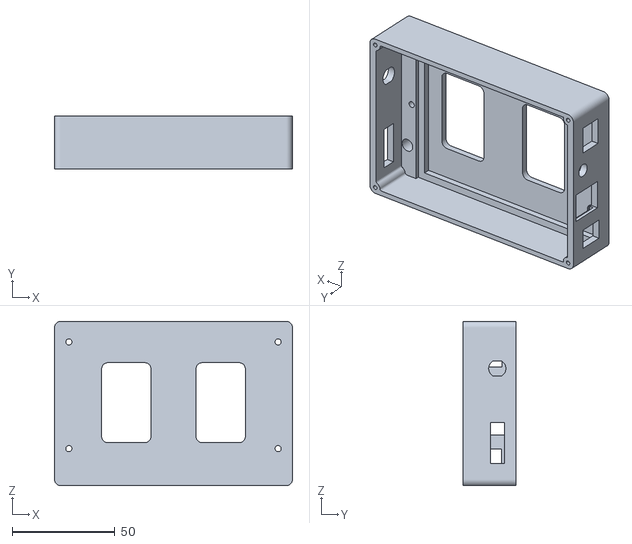
[picture p45: CAD file, 2023-02-04]
MotorKit/Kit_EQ6_EM200/case/Case.stl
116.0 x 26.0 x 80.0
