charleslemaire0/TeenAstroHardware/MotorKit/Kit_EQ6_EM200/Motorplate for EM200/Plate Motor RA.stp

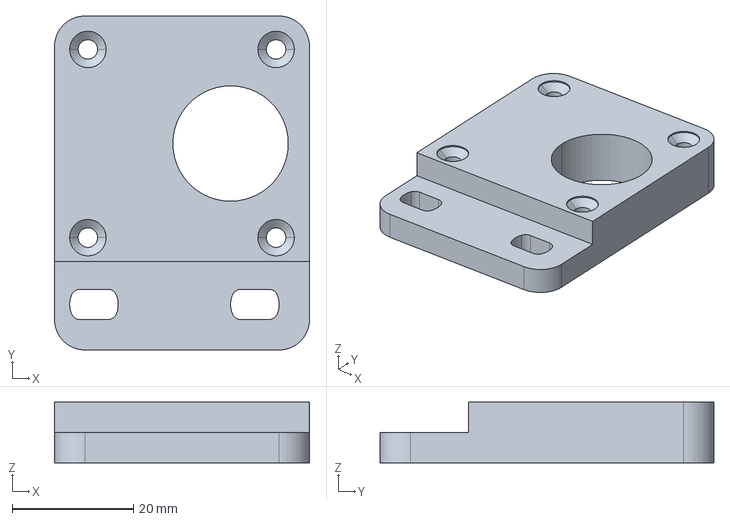
[picture p46: CAD file, 2023-02-04]
MotorKit/Kit_EQ6_EM200/Motorplate for EM200/Plate Motor RA.stp
42.0 x 55.0 x 10.0 mm
