charleslemaire0/TeenAstroHardware/MotorKit/NemaCovers/Nema23/ModelA/files/Motor_Cover_Nema23_angle_large_option2.STL

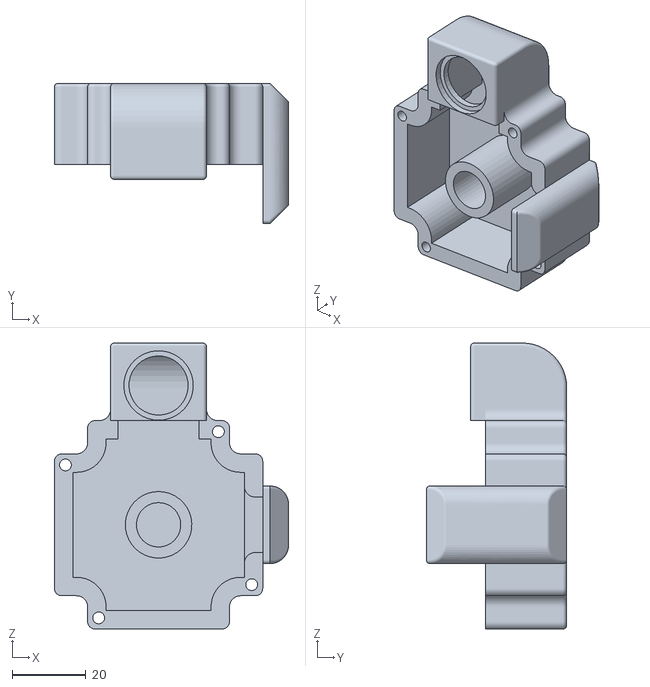
[picture p47: CAD file, 2023-07-23]
MotorKit/NemaCovers/Nema23/ModelA/files/Motor_Cover_Nema23_angle_large_option2.STL
63.4 x 38.0 x 77.4
