charleslemaire0/TeenAstroHardware/MainUnit/EQ6_Kit/V25/EQ6 - V2024_01/Source/CAO SW2017/111b facade EQ6.SLDPRT

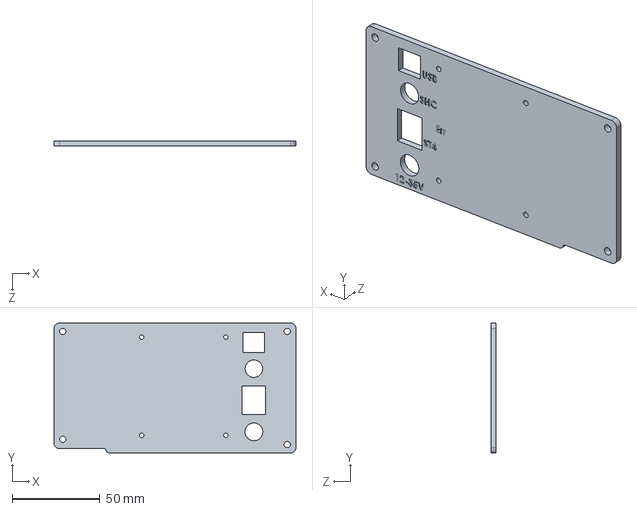
[picture p48: CAD file, 2024-02-11]
MainUnit/EQ6_Kit/V25/EQ6 - V2024_01/Source/CAO SW2017/111b facade EQ6.SLDPRT
138.0 x 74.0 x 3.00 mm
