charleslemaire0/TeenAstroHardware/MotorKit/Kit_EQ6_EM200/case/BottoPlateForEq6.stl

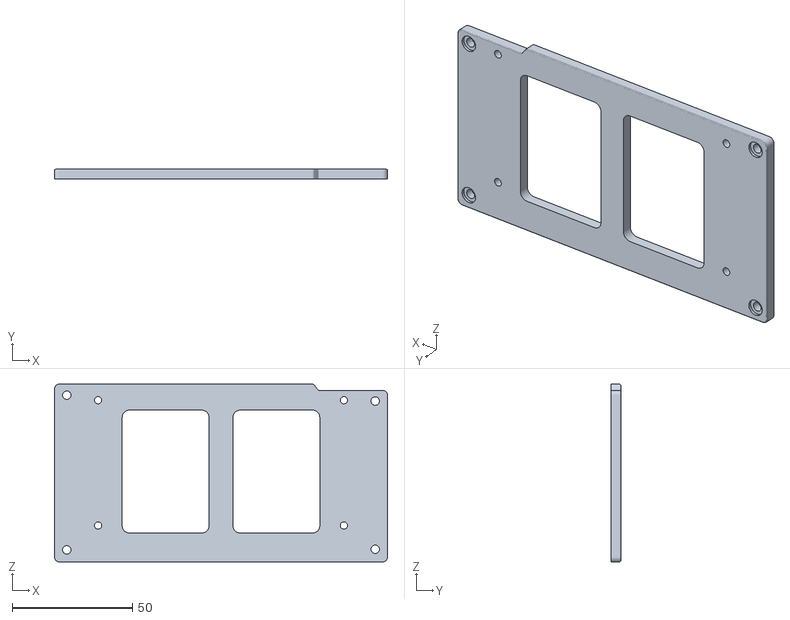
[picture p49: CAD file, 2023-02-04]
MotorKit/Kit_EQ6_EM200/case/BottoPlateForEq6.stl
138.2 x 4.00 x 73.8
