charleslemaire0/TeenAstroHardware/MotorKit/NemaCovers/Nema23/ModelA/files/Motor_Cover_Nema24_angle_large.STL

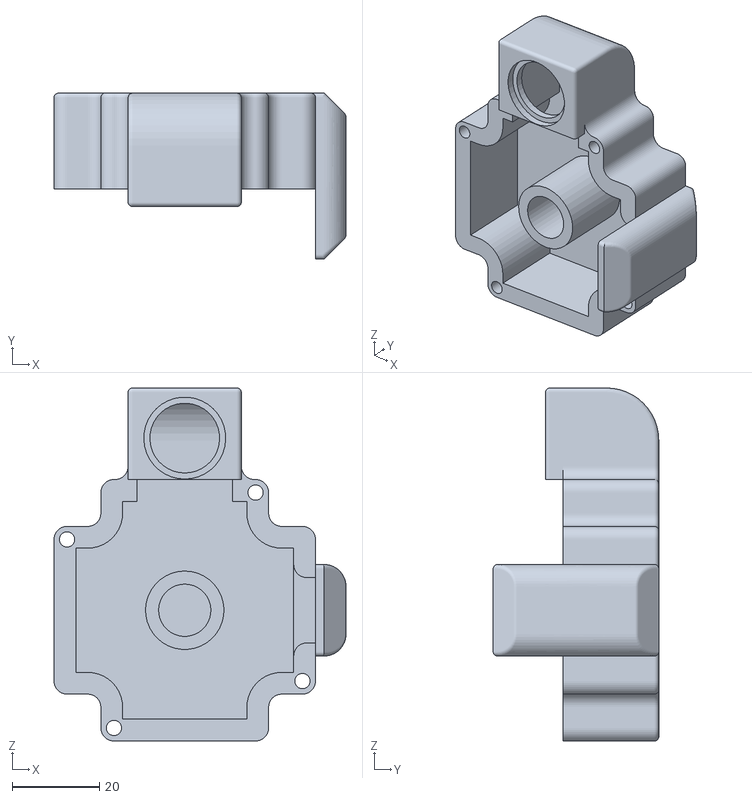
[picture p50: CAD file, 2023-07-23]
MotorKit/NemaCovers/Nema23/ModelA/files/Motor_Cover_Nema24_angle_large.STL
67.0 x 38.0 x 81.0
