charleslemaire0/TeenAstroHardware/MotorKit/NemaCovers/Nema23/ModelA/files/Motor_Cover_Nema23_straight_option2.STL

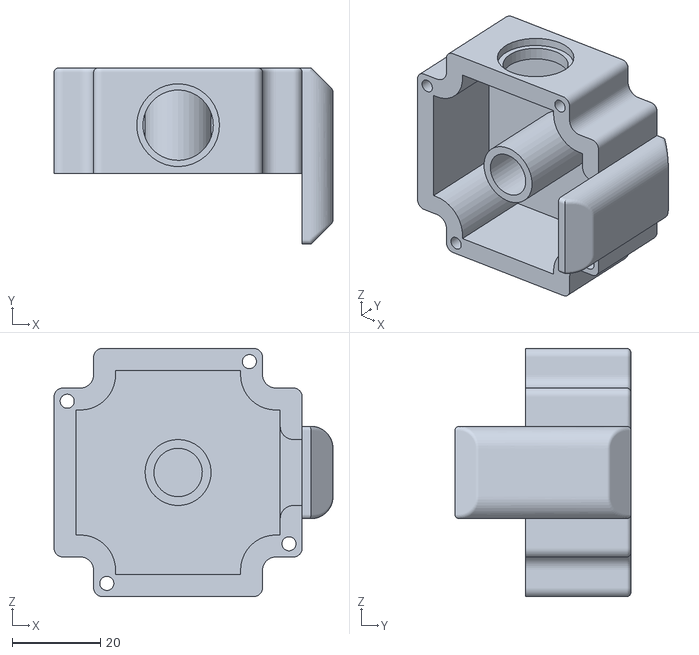
[picture p52: CAD file, 2023-07-23]
MotorKit/NemaCovers/Nema23/ModelA/files/Motor_Cover_Nema23_straight_option2.STL
63.4 x 40.0 x 56.4
