charleslemaire0/TeenAstroHardware/(list of files, cad)

Other CAD files:
MainUnit/Tiny/V25/Source/CAO SW2017/board tiny/Teensy_4.0_Assembly.sldprt
MainUnit/EQ6_Kit/V25/EQ6 - V2024_01/Source/CAO SW2017/CAO CI/hdr-1x5t_2.54_sh15x8.sldprt
MainUnit/EQ6_Kit/V25/EQ6 - V2024_01/Source/CAO SW2017/112 entretoise_12mm.SLDPRT
MainUnit/EQ6_Kit/V25/EQ6 - V2024_01/Source/CAO SW2017/CAO CI/Board_CI_EQ6.sldprt
MainUnit/Tiny/V25/Source/CAO SW2017/112 tiny-back.SLDPRT
MainUnit/Tiny/V25/Source/CAO SW2017/board tiny/cappr-2.54_5.08.sldprt
MainUnit/EQ6_Kit/V25/EQ6 - V2024_01/Source/CAO SW2017/CAO CI/DC_55x25_droit.sldprt
MainUnit/Tiny/V25/Source/CAO SW2017/board tiny/924.sldprt
MainUnit/EQ6_Kit/V25/EQ6 - V2024_01/Source/CAO SW2017/CAO CI/hdr-1x4t_2.54_sh12x8.sldprt
MainUnit/Tiny/V25/Source/CAO SW2017/111 tiny-front.SLDPRT
MainUnit/Tiny/V25/Source/CAO SW2017/board tiny/sip-6_14.7x2x2.54.sldprt
MainUnit/EQ6_Kit/V25/EQ6 - V2024_01/Source/CAO SW2017/CAO CI/hdr-1x2t_2.54_sh7x8.sldprt
MainUnit/Tiny/V25/Source/CAO SW2017/board tiny/suport_fusible_SMD.sldprt
MainUnit/Tiny/V25/Source/CAO SW2017/board tiny/diode_SMD_DO214_S5DC-13-F.sldprt
MotorKit/NemaCovers/Nema23/ModelA/files/Motor_Cover_Nema23_angle.STL
MainUnit/EQ6_Kit/V25/EQ6 - V2024_01/Source/CAO SW2017/CAO CI/USB_B_droit.sldprt
MainUnit/Tiny/V25/Source/CAO SW2017/board tiny/TSR_1-2450.sldprt
MotorKit/NemaCovers/Nema23/ModelA/files/Motor_Cover_Nema23_straight.STL
MainUnit/EQ6_Kit/V25/EQ6 - V2024_01/Source/CAO SW2017/CAO CI/diode_SMD_DO214_S5DC-13-F.sldprt
MotorKit/NemaCovers/Nema23/ModelA/files/Motor_Cover_Nema23_angle_large.STL
MainUnit/EQ6_Kit/V25/EQ6 - V2024_01/Source/CAO SW2017/CAO CI/hdr-1x6t_2.54_sh17x8.sldprt
MainUnit/Tiny/V25/Source/CAO SW2017/board tiny/D8x20coude.sldprt
MainUnit/Tiny/V25/Source/CAO SW2017/board tiny/clip_CR1620.sldprt
MainUnit/Tiny/V25/Source/CAO SW2017/board tiny/TMC2130-V3.0.sldprt
MainUnit/Tiny/V25/Source/CAO SW2017/board tiny/Board_tiny.sldprt
MainUnit/Tiny/V25/Source/CAO SW2017/board tiny/SS-90000-003.sldprt
MainUnit/Tiny/V25/Source/CAO SW2017/board tiny/sip-8_21.6x2.4x2.54.sldprt
MainUnit/EQ6_Kit/V25/EQ6 - V2024_01/Source/CAO SW2017/CAO CI/M8_6pin_elbow_PCB.sldprt
MainUnit/Large/V24/Schaeffer/shape_ABD_1300.dxf
MainUnit/Tiny/V25/CAO Panel/111 tiny-front.DXF
MainUnit/Tiny/V25/CAO Panel/111 tiny-front.STL
MainUnit/Tiny/V25/CAO Panel/112 tiny-back.DXF
MainUnit/Tiny/V25/CAO Panel/112 tiny-back.STL
MainUnit/Tiny/V25/Source/CAO SW2017/board tiny/M8_6pin_elbow_PCB.sldprt
MainUnit/Tiny/V25/Source/CAO SW2017/board tiny/RJE091884111A.sldprt
