charleslemaire0/TeenAstroHardware/MainUnit/Mini/V25/Eagle/TeenAstro_mini_v25x_1.pdf

0 I

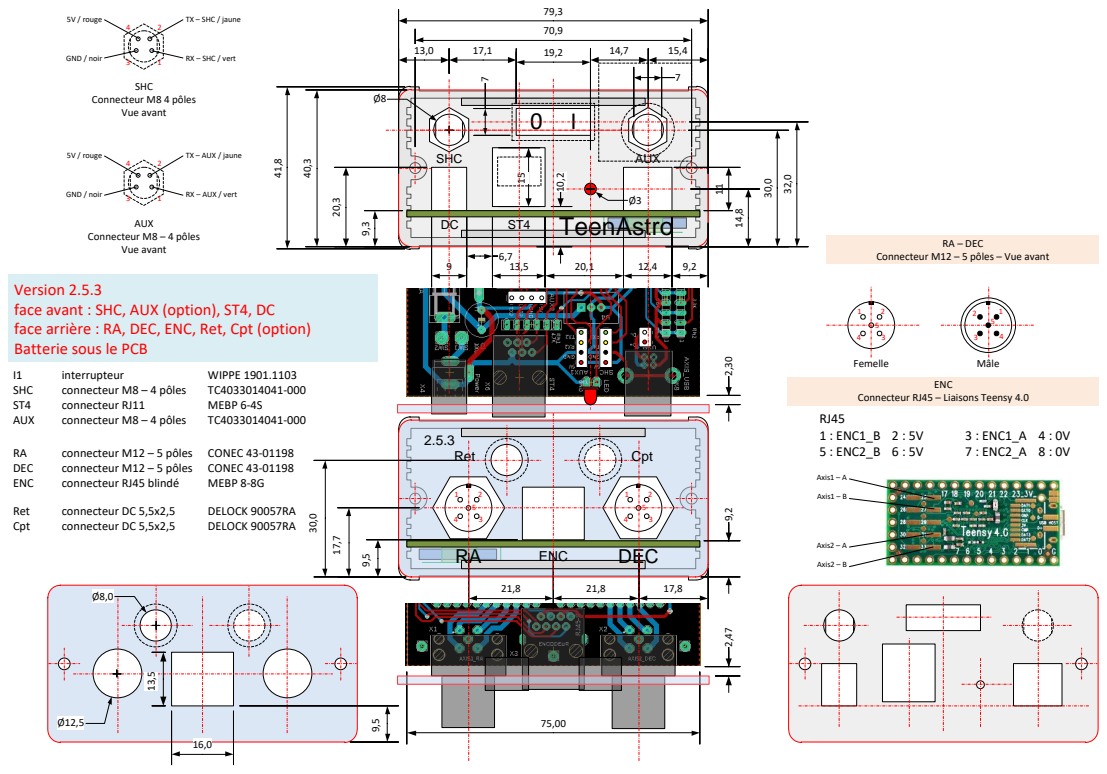
[picture p54: page 1]
TeenAstro; SHC; interrupteur; WIPPE 1901.1103; connecteur M8 – 4 pôles; connecteur RJ11; MEBP 6-4S; AUX; connecteur M12 – 5 pôles; CONEC 43-01198; DEC; ENC; connecteur RJ45 blindé; MEBP 8-8G; Axis1 – A Axis1 – B; Axis2 – A Axis2 – B; GND / noir; Ret; Cpt; connecteur DC 5,5x2,5; DELOCK 90057RA; 1 : ENC1_B 2 : 5V; 3 : ENC1_A 4 : 0V; 5 : ENC2_B 6 : 5V; 7 : ENC2_A 8 : 0V; Femelle; RA – DEC; Mâle

TX – SHC / jaune RX – SHC / vert 5V / rouge

Connecteur M8 4 pôles Vue avant

TX – AUX / jaune RX – AUX / vert 5V / rouge

Connecteur M8 – 4 pôles Vue avant

Connecteur M12 – 5 pôles – Vue avant

Version 2.5.3
face avant : SHC, AUX (option), ST4, DC
face arrière : RA, DEC, ENC, Ret, Cpt (option)
Batterie sous le PCB

Connecteur RJ45 – Liaisons Teensy 4.0
