charleslemaire0/TeenAstroHardware/MainUnit/Tiny/V25/CAO Panel/111 tiny-front.pdf

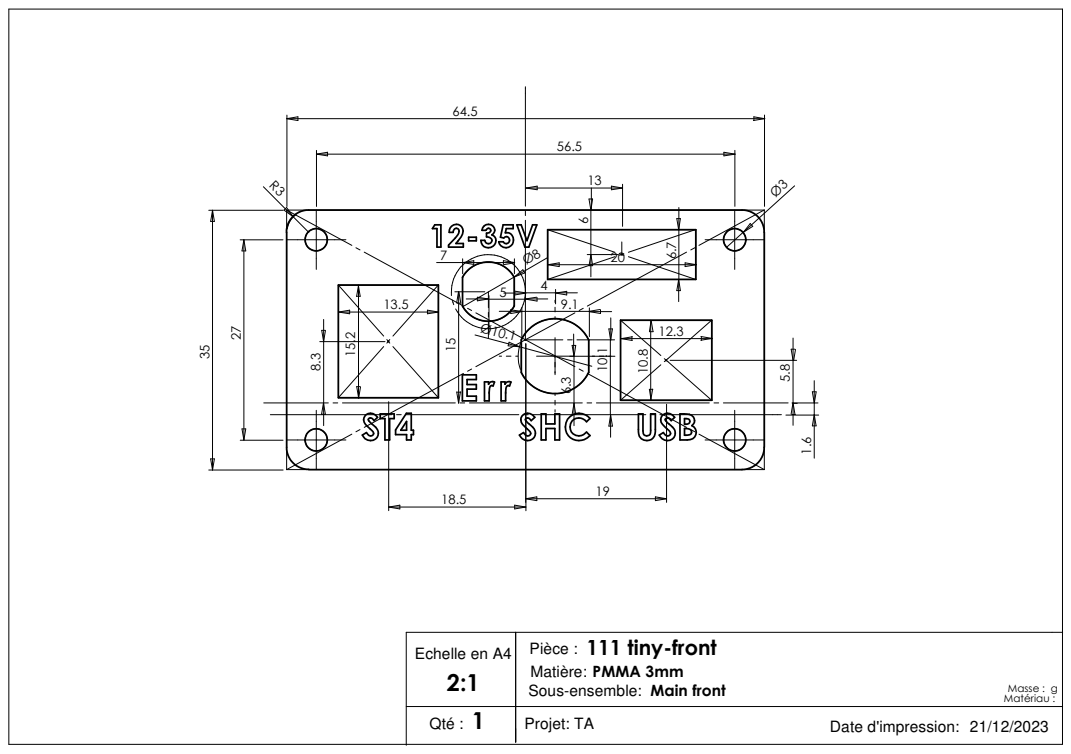
[picture p55: page 1]

Echelle en A4 | 111 tiny-front Pièce : Matière: PMMA 3mm Sous-ensemble: 2:1 Masse : g Main front Matériau :

Qté : 1 | Projet: TA Date d'impression: 21/12/2023
