charleslemaire0/TeenAstroHardware/MainUnit/Tiny/V25/CAO Panel/112 tiny-back.pdf

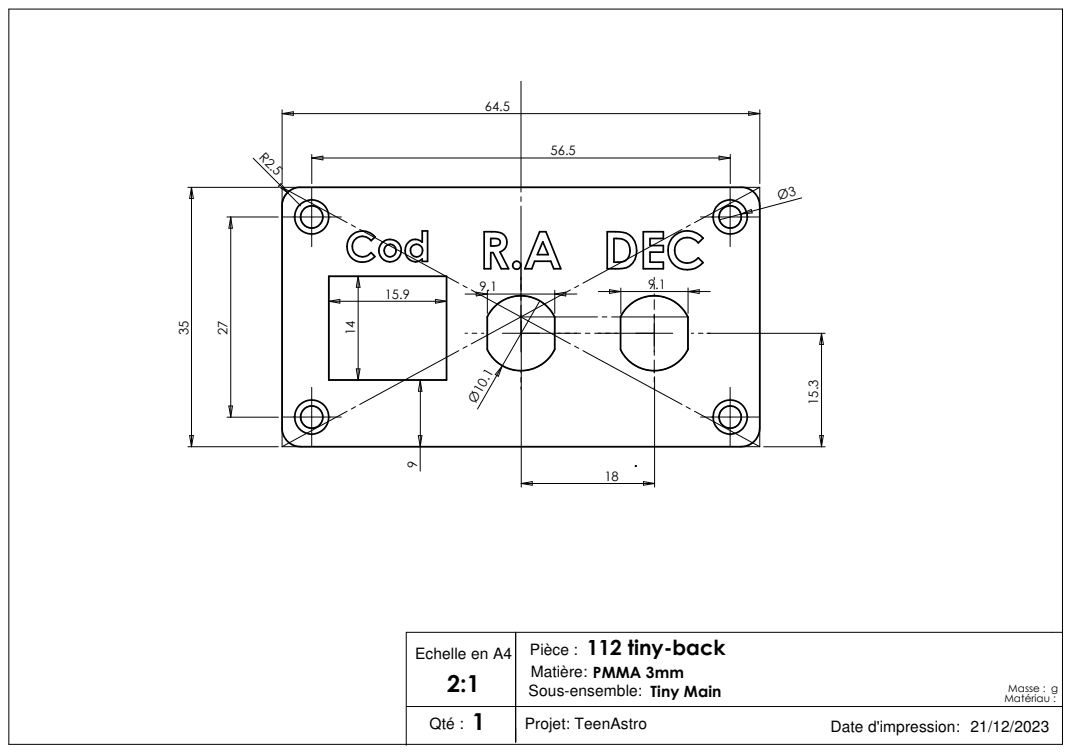
[picture p56: page 1]

Echelle en A4 | 112 tiny-back Pièce : Matière: PMMA 3mm Sous-ensemble: Matériau : 2:1 Masse : g Tiny Main

Qté : 1 | Projet: TeenAstro Date d'impression: 21/12/2023
