charleslemaire0/TeenAstroHardware/MainUnit/EQ6_Kit/V25/EQ6 - V2024_01/Source/CAO SW2017/111b facade EQ6.pdf

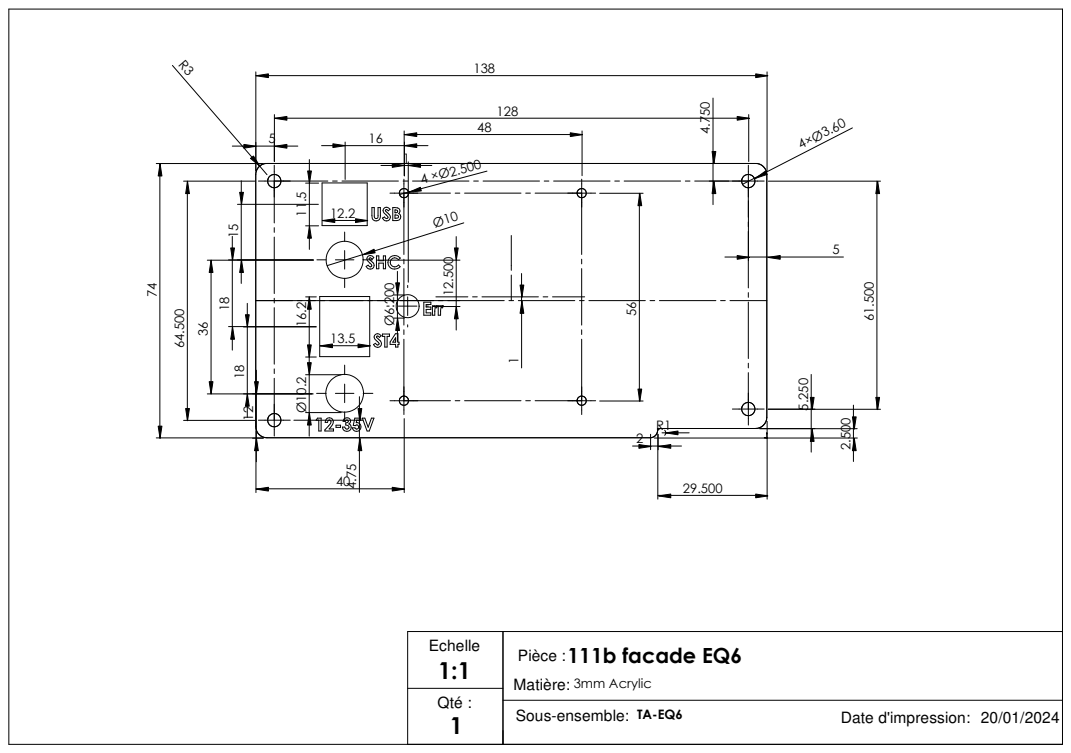
[picture p57: page 1]
3mm Acrylic; Pièce :; Sous-ensemble:; Matière:; Echelle; Qté :; 111b facade EQ6; Date d'impression: 20/01/2024
