charleslemaire0/TeenAstroHardware/MainUnit/Tiny/V25/Source/DipTrace/DipTrace Schematic - Tiny_250.dch.pdf

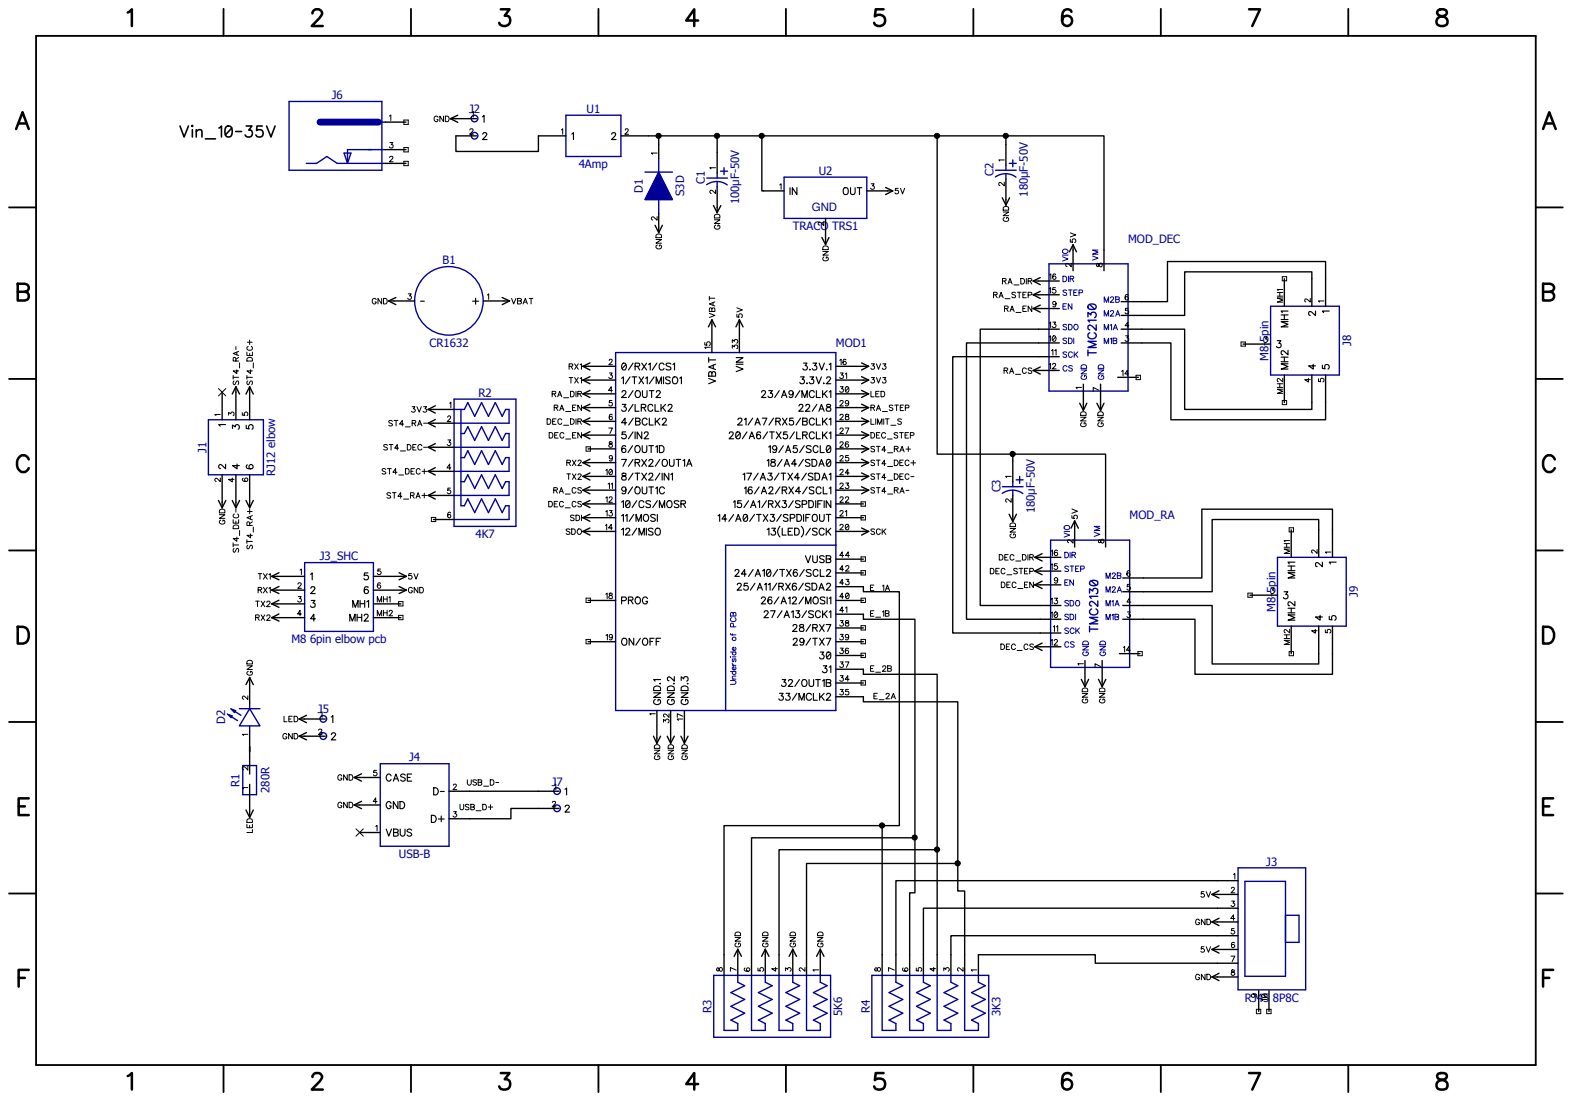
[picture p58: page 1]
