charleslemaire0/TeenAstroHardware/MainUnit/Mini/V25/Teenastro schéma V2.5.2.pdf

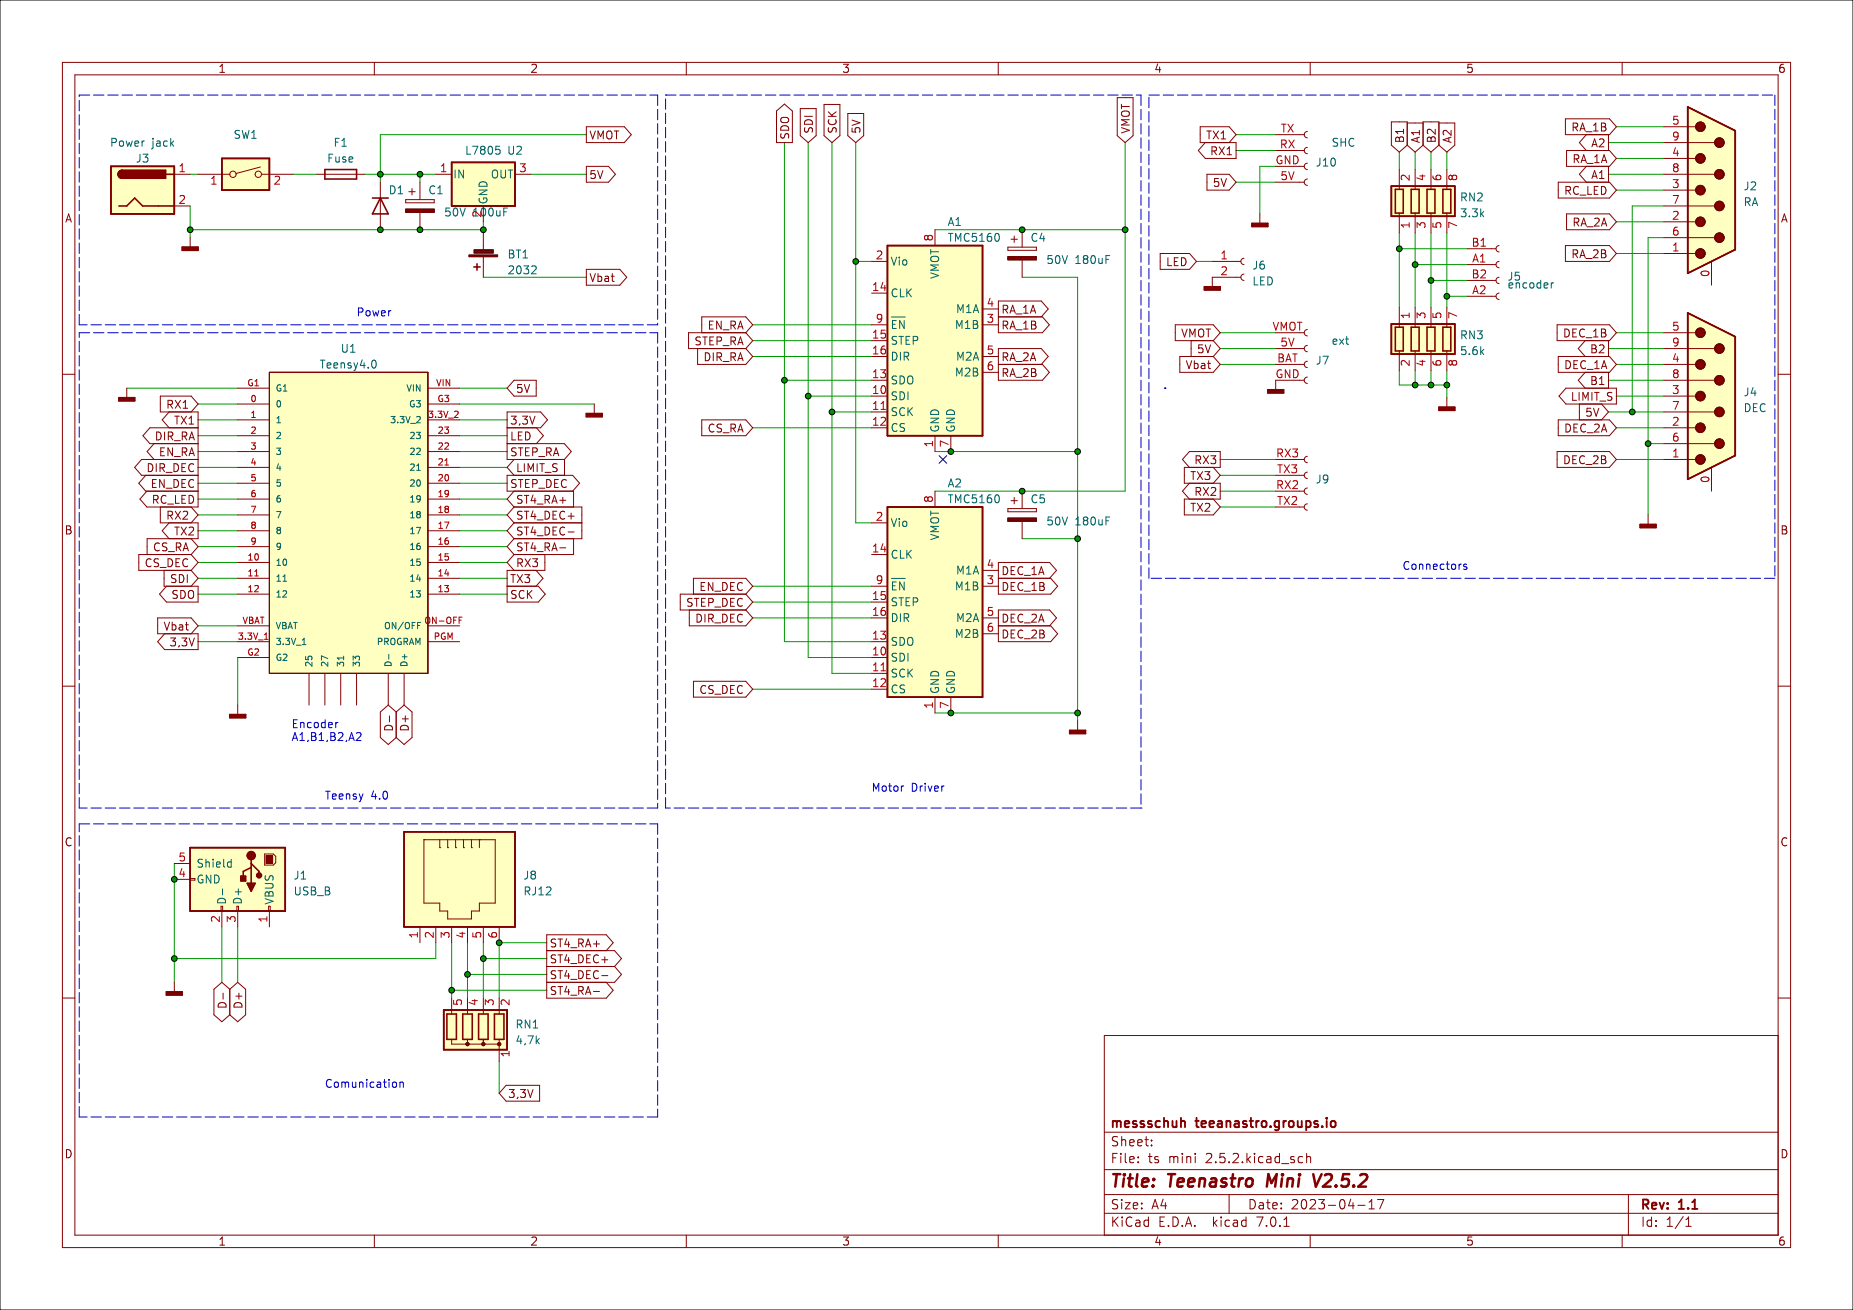
[picture p59: page 1]
