charleslemaire0/TeenAstroHardware/MainUnit/Mini/V25/Eagle/Teenastro schéma v2-5-3 mini_M12_1.pdf

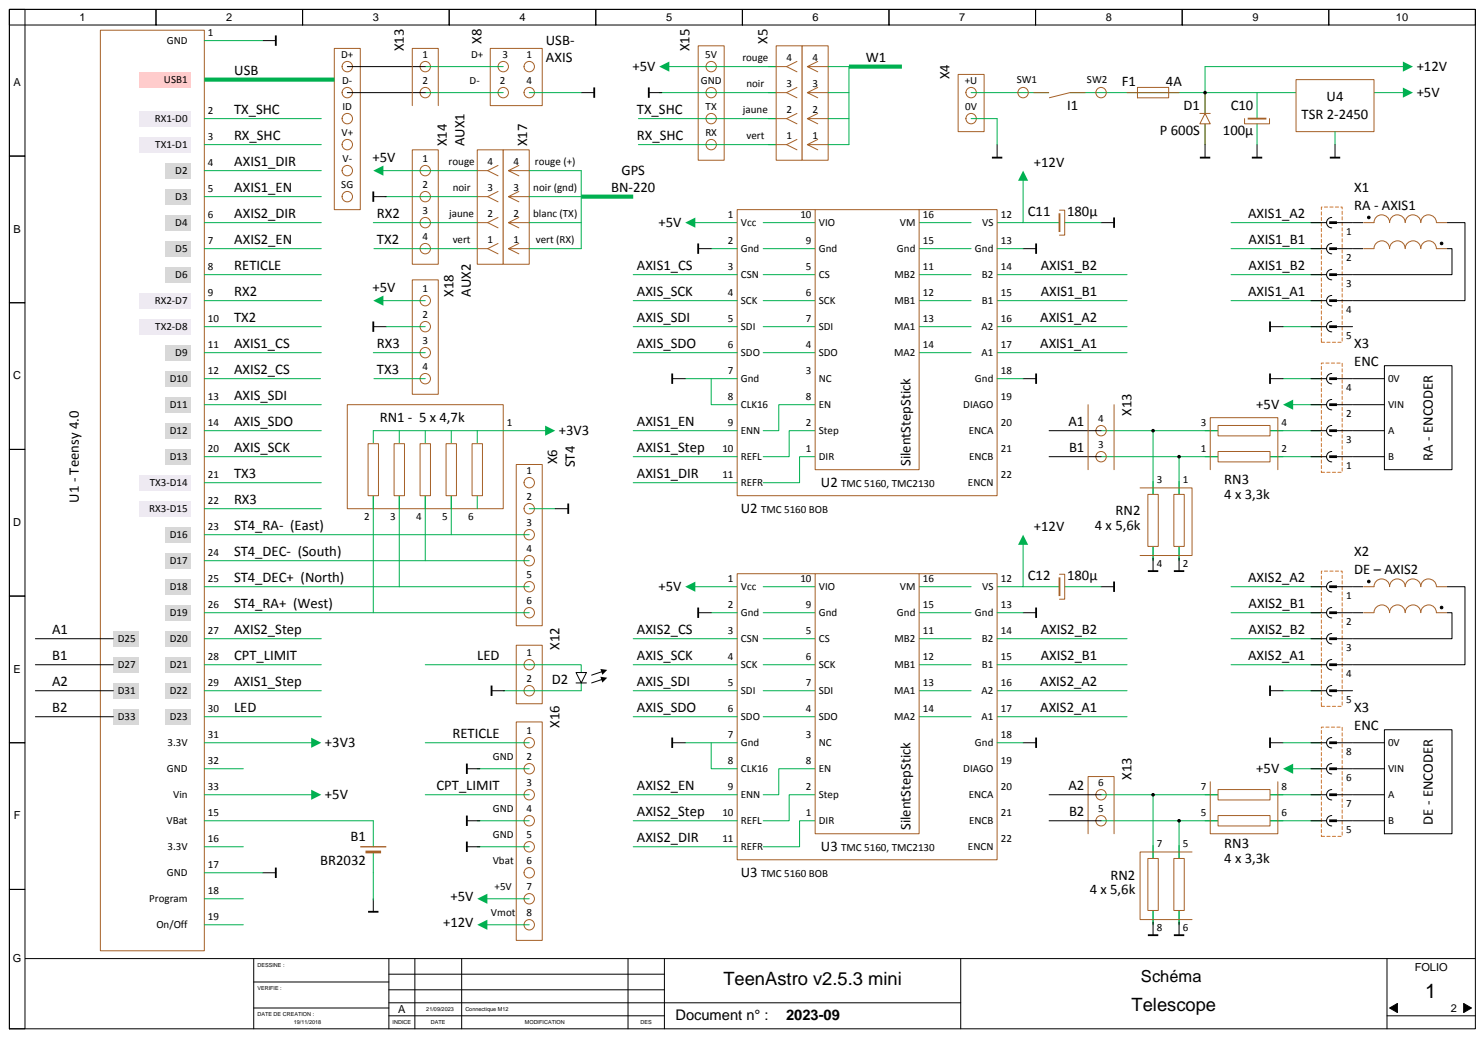
[picture p60: page 1]

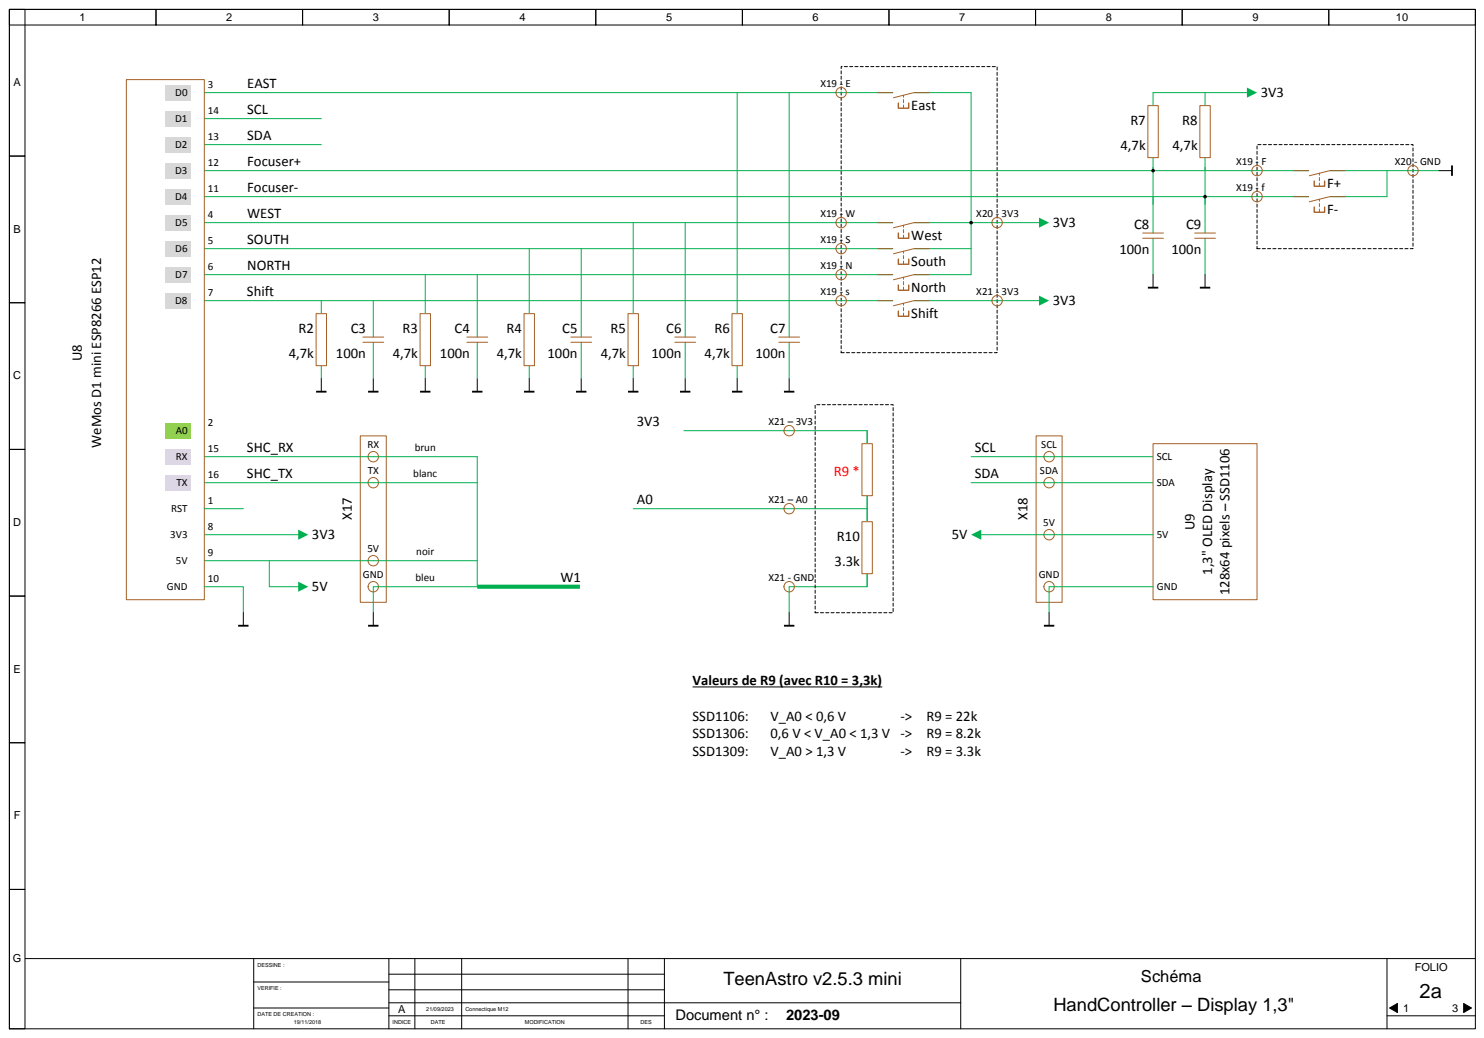
[picture p61: page 2]

SHC_TX U⁸ WeMos D¹ mini ESP8266 ESP12

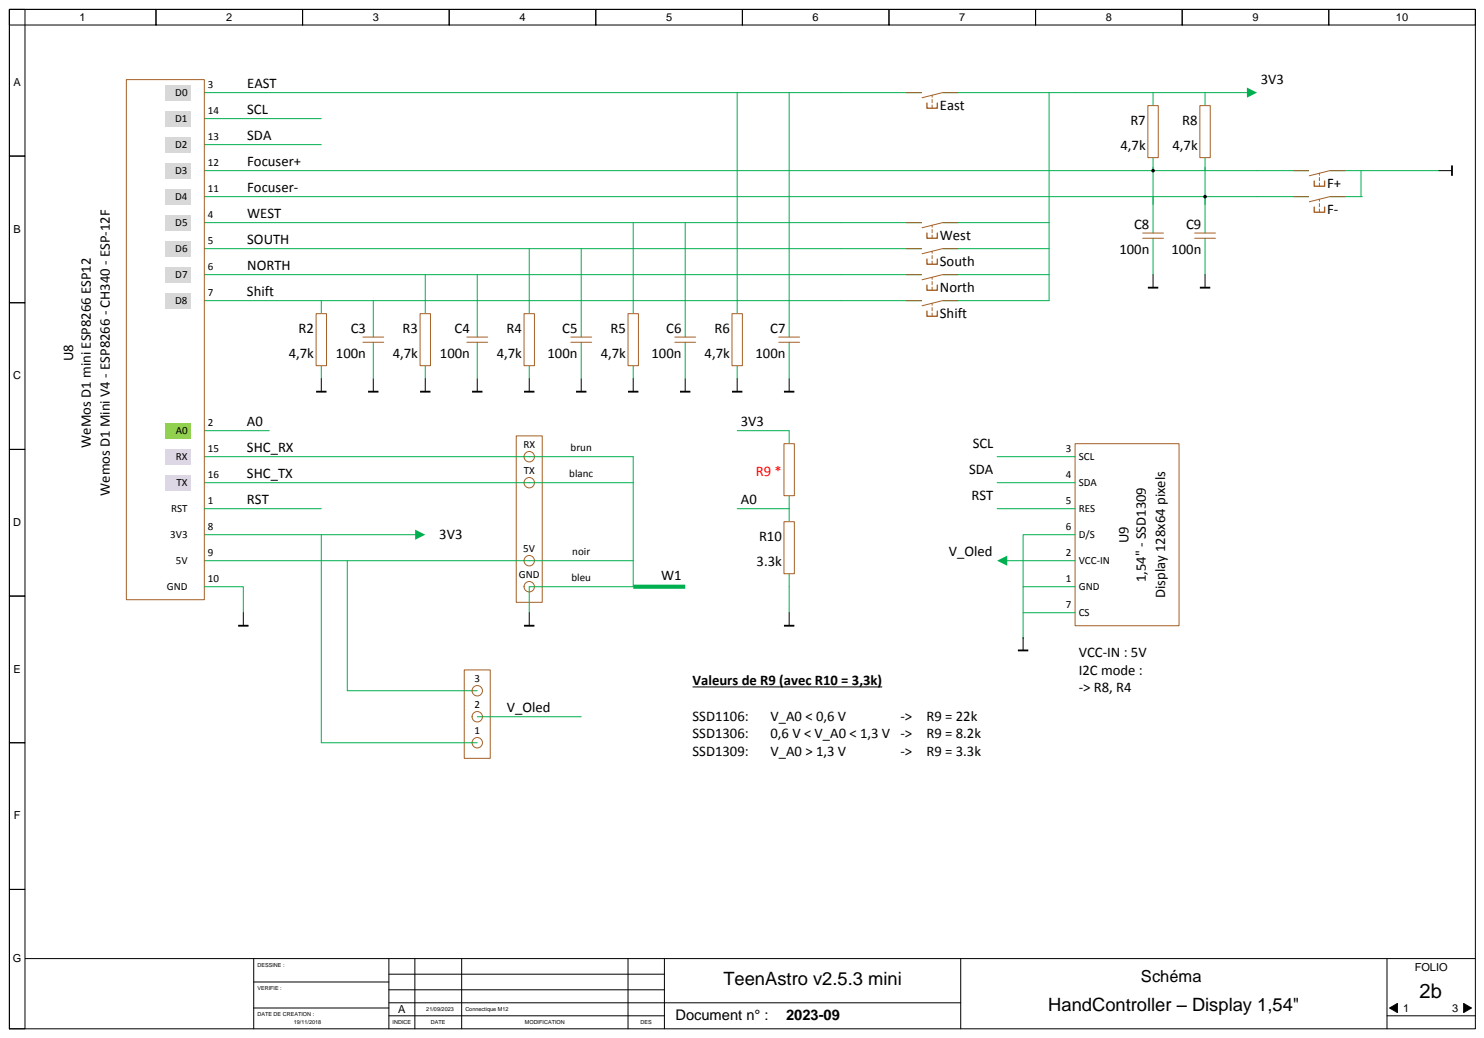
[picture p62: page 3]

SHC_TX U⁸ WeMos D¹ mini ESP8266 ESP12 Wemos D¹ Mini V⁴ ⁻ ESP8266 ⁻ CH³⁴⁰ ⁻ ESP⁻12F

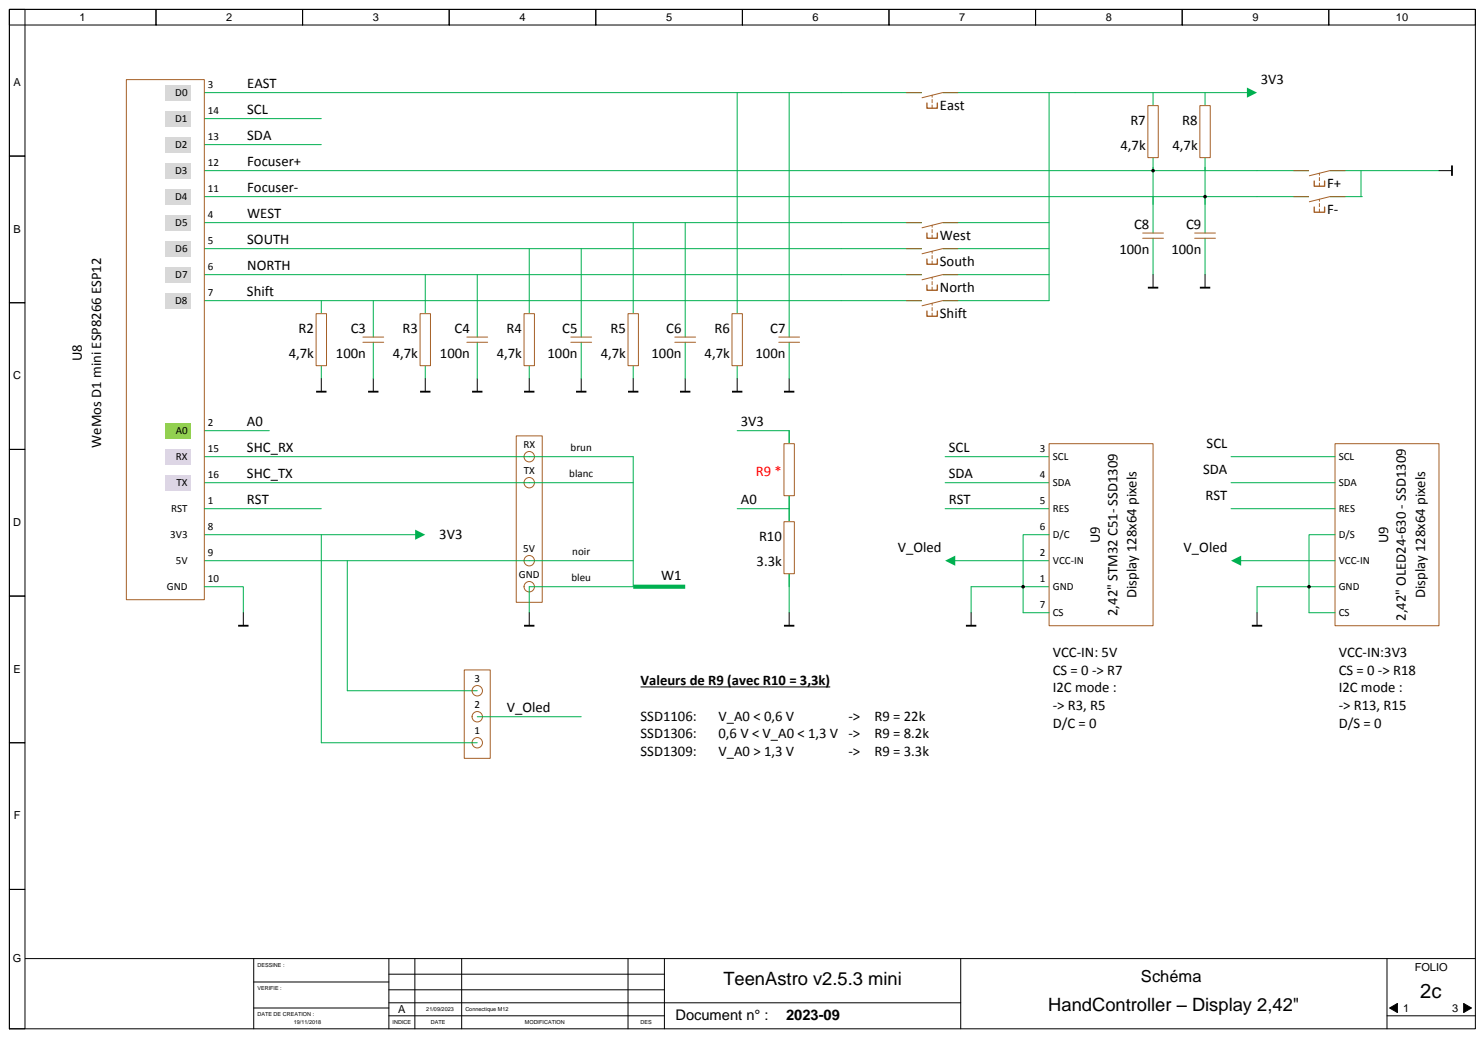
[picture p63: page 4]

SHC_TX U⁸ WeMos D¹ mini ESP8266 ESP12

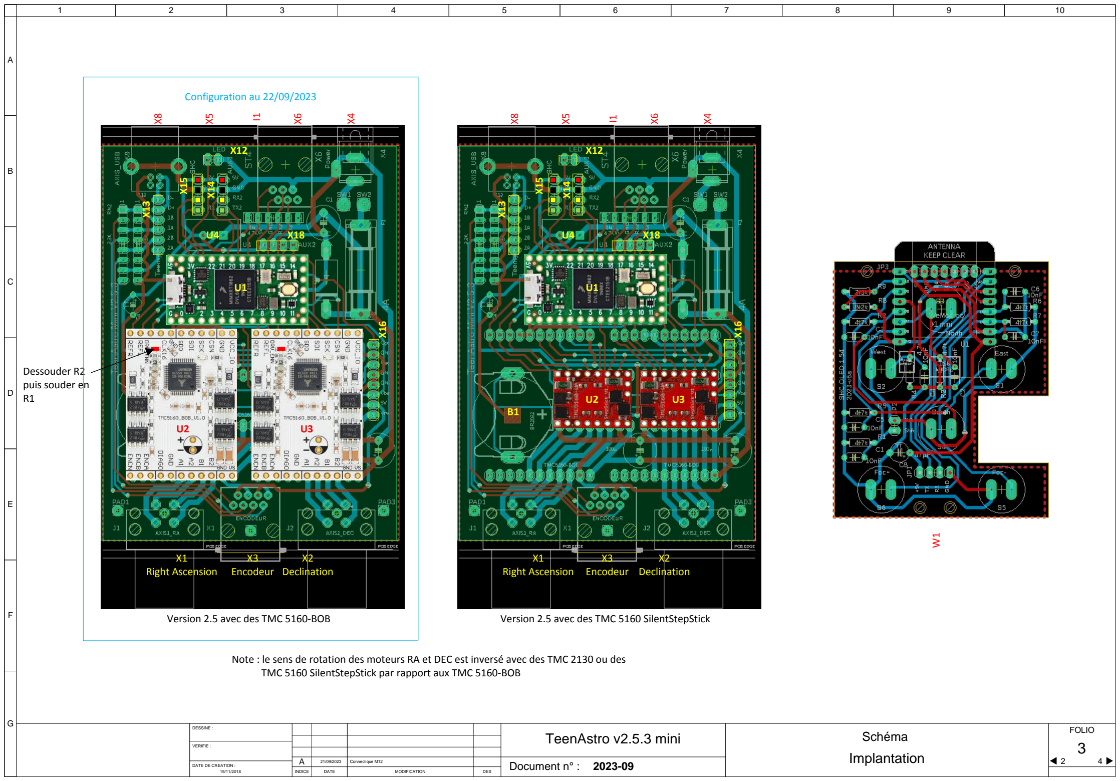
[picture p64: page 5]

FOLIO

DESSINE :

A

B

D

E

C

F

G | 21/09/2023 | Connectique M12 | Implantation
3 2 | 4

X8

X4

X6

X1

Right Ascension | X2 Declination

U4

X5

I1

B1
U2 | U3

X8

X4

X6

X1
Right Ascension

B1

X5
I1
Version 2.5 avec des TMC 5160-BOB | Version 2.5 avec des TMC 5160 SilentStepStick

W1

Dessouder R2
puis souder en R1

Note : le sens de rotation des moteurs RA et DEC est inversé avec des TMC 2130 ou des TMC 5160 SilentStepStick par rapport aux TMC 5160-BOB

U2 | U3
U1 | U1 X13

X15

X12

X14

X16

Configuration au 22/09/2023

X3
Encodeur
X18 | U4 X13

X15

X12

X14

X16

X18

X3
Encodeur X2 Declination

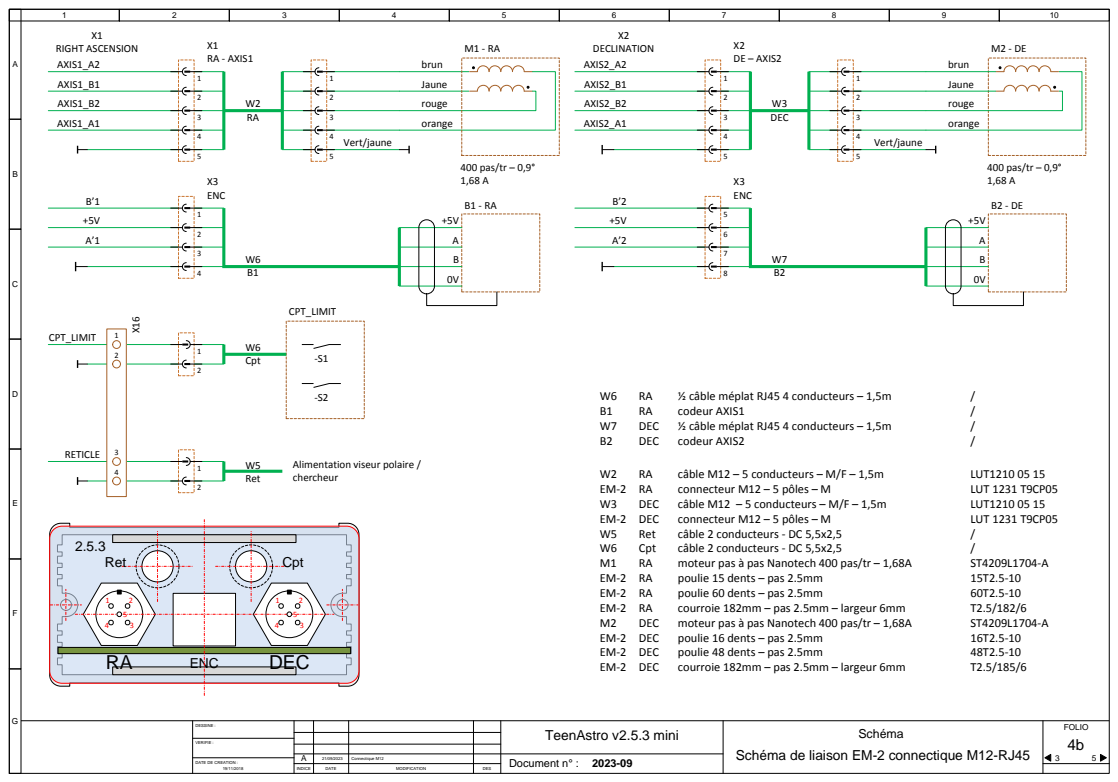
[picture p65: page 6]
FOLIO; DESSINE :; Connectique M12; 4b Schéma de liaison EM-2 connectique M12-RJ45; AXIS1_B2; AXIS1_A1; AXIS1_A2; AXIS1_B1; RETICLE; orange; brun Jaune rouge ¹; DEC AXIS2_A1; AXIS2_A2; AXIS2_B1; AXIS2_B2; Vert/jaune ¹; X1 RIGHT ASCENSION; X2 DECLINATION; 400 pas/tr – 0,9° 1,68 A; 400 pas/tr – 0,9° 1,68 A +5V; CPT_LIMIT; câble M12 – 5 conducteurs – M/F – 1,5m; LUT1210 05 15; connecteur M12 – 5 pôles – M; LUT 1231 T9CP05; DEC; EM-2 DEC; Ret; câble 2 conducteurs - DC 5,5x2,5; Cpt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

Alimentation viseur polaire / chercheur W5
Ret

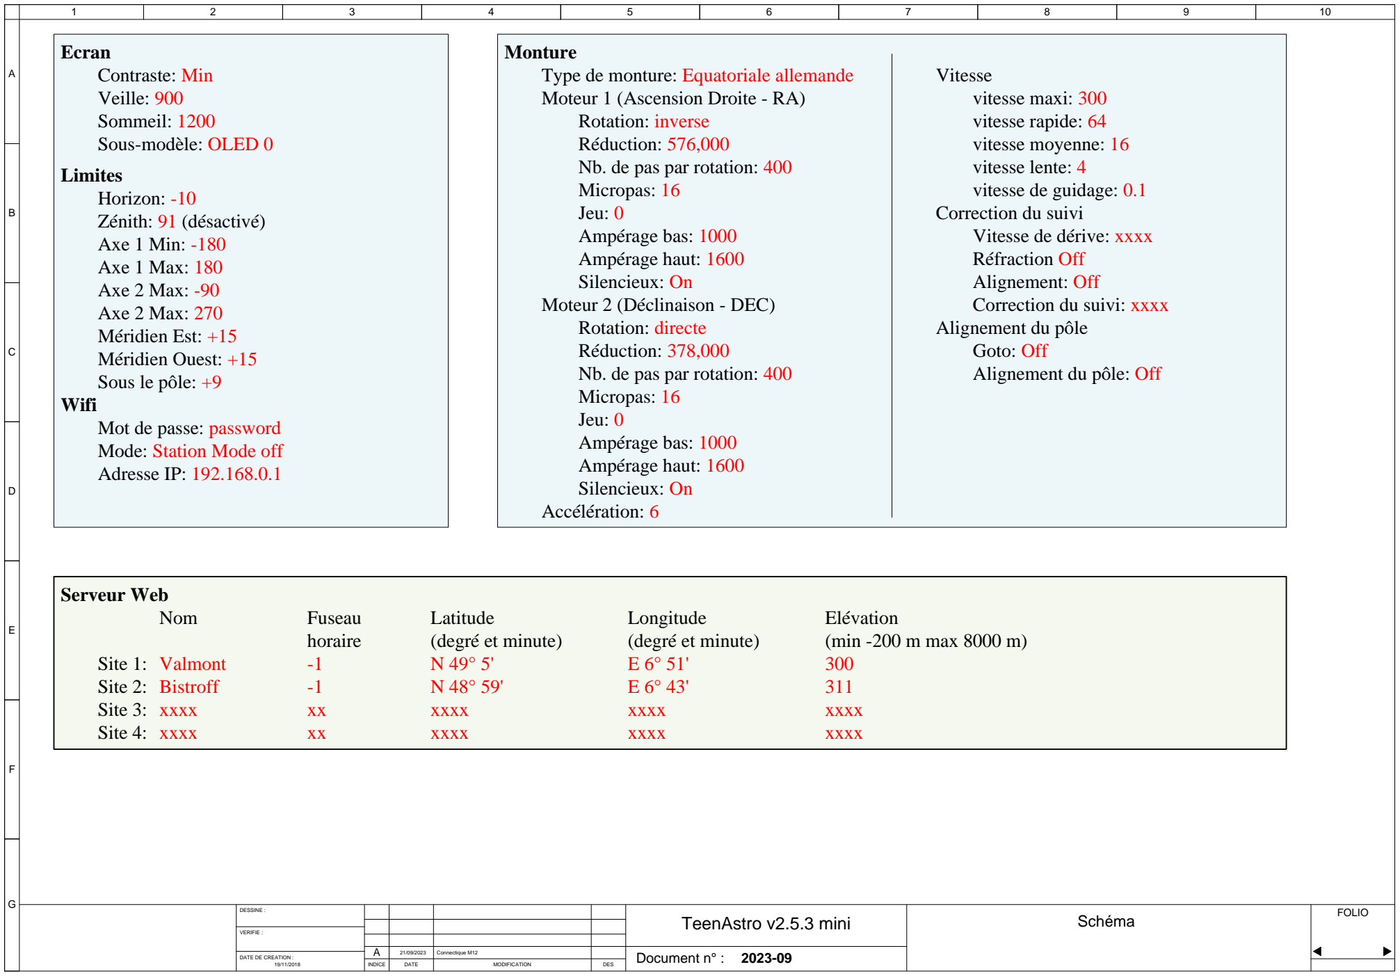
[picture p66: figure]
FOLIO; DESSINE :; Connectique M12; Ecran Contraste: Min Veille: 900 Sommeil: 1200 Sous-modèle: OLED 0; Monture Type de monture: Equatoriale allemande Moteur 1 (Ascension Droite - RA) Rotation: inverse Réduction: 576,000 Nb. de pas par rotation: 400 Micropas: 16 Jeu: 0 Ampérage bas: 1000 Ampérage haut: 1600 Silencieux: On Moteur 2 (Déclinaison - DEC) Rotation: directe Réduction: 378,000 Nb. de pas par rotation: 400 Micropas: 16 Jeu: 0 Ampérage bas: 1000 Ampérage haut: 1600 Silencieux: On Accélération: 6; Limites Horizon: -10 Zénith: 91 (désactivé) Axe 1 Min: -180 Axe 1 Max: 180 Axe 2 Max: -90 Axe 2 Max: 270 Méridien Est: +15 Méridien Ouest: +15 Sous le pôle: +9; Wifi; Mot de passe: password Mode: Station Mode off Adresse IP: 192.168.0.1; Serveur Web; Nom; Fuseau; Latitude; Longitude; Elévation; Site 3: xxxx; xxxx; Site 4: xxxx; Vitesse vitesse maxi: 300 vitesse rapide: 64 vitesse moyenne: 16 vitesse lente: 4 vitesse de guidage: 0.1 Correction du suivi Vitesse de dérive: xxxx Réfraction Off Alignement: Off Correction du suivi: xxxx Alignement du pôle Goto: Off Alignement du pôle: Off

| horaire | (degré et minute) | (degré et minute) | (min -200 m max 8000 m)
Site 1: Valmont | -1 | N 49° 5' | E 6° 51' | 300
Site 2: Bistroff | -1 | N 48° 59' | E 6° 43' | 311
