charleslemaire0/TeenAstroHardware/MainUnit/Large/V24/Teenastro Schematics 2.3.1.pdf

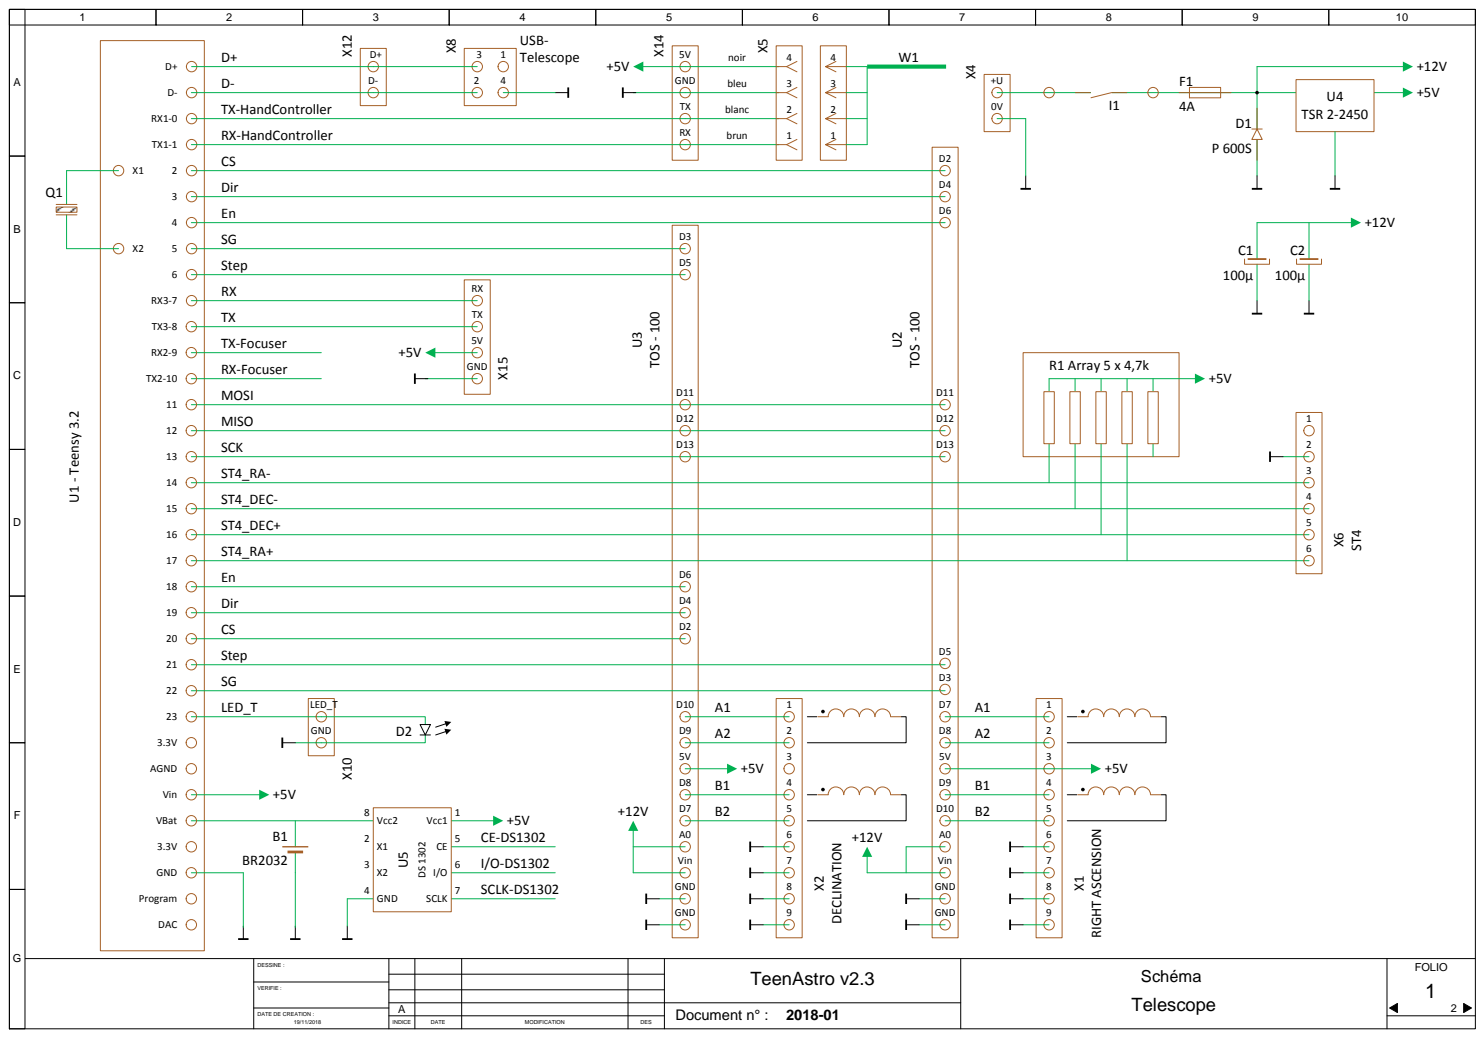
[picture p67: page 1]
ABDECFG; U1 - Teensy 3.2; TOS - 100; DECLINATION; RIGHT ASCENSION

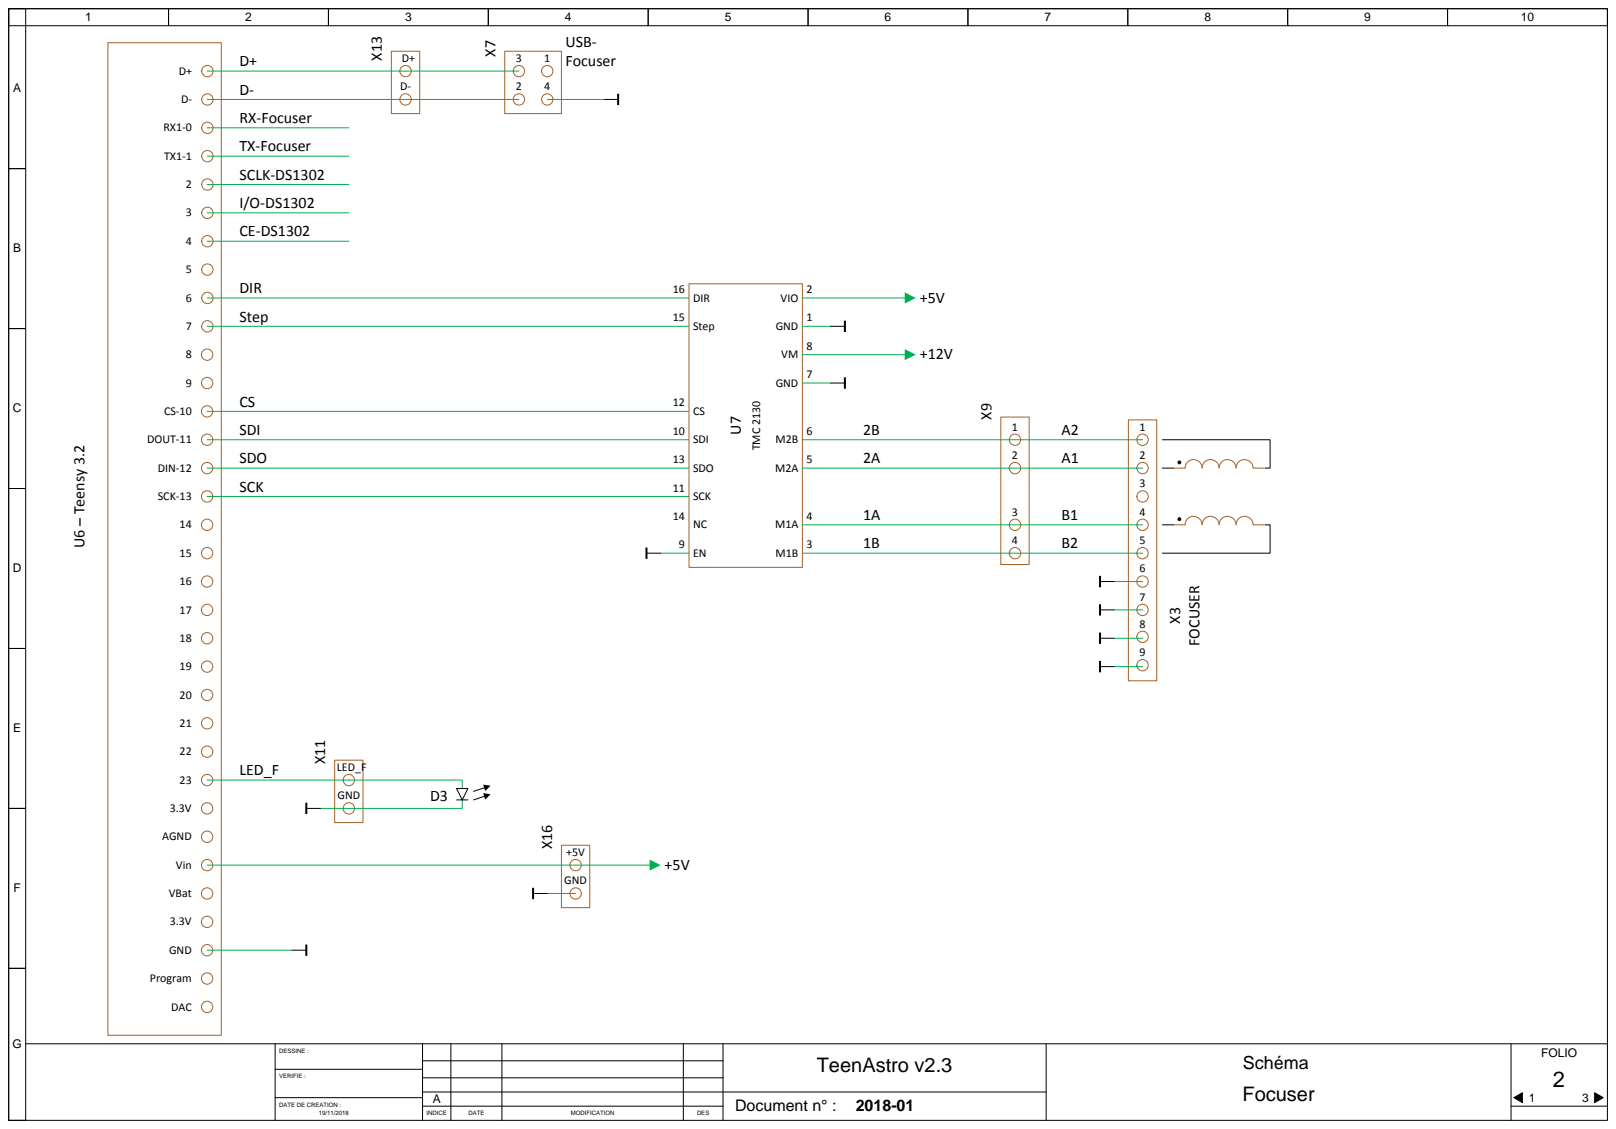
[picture p68: page 2]
ABDECFG; U6 – Teensy 3.2; TMC 2130; FOCUSER

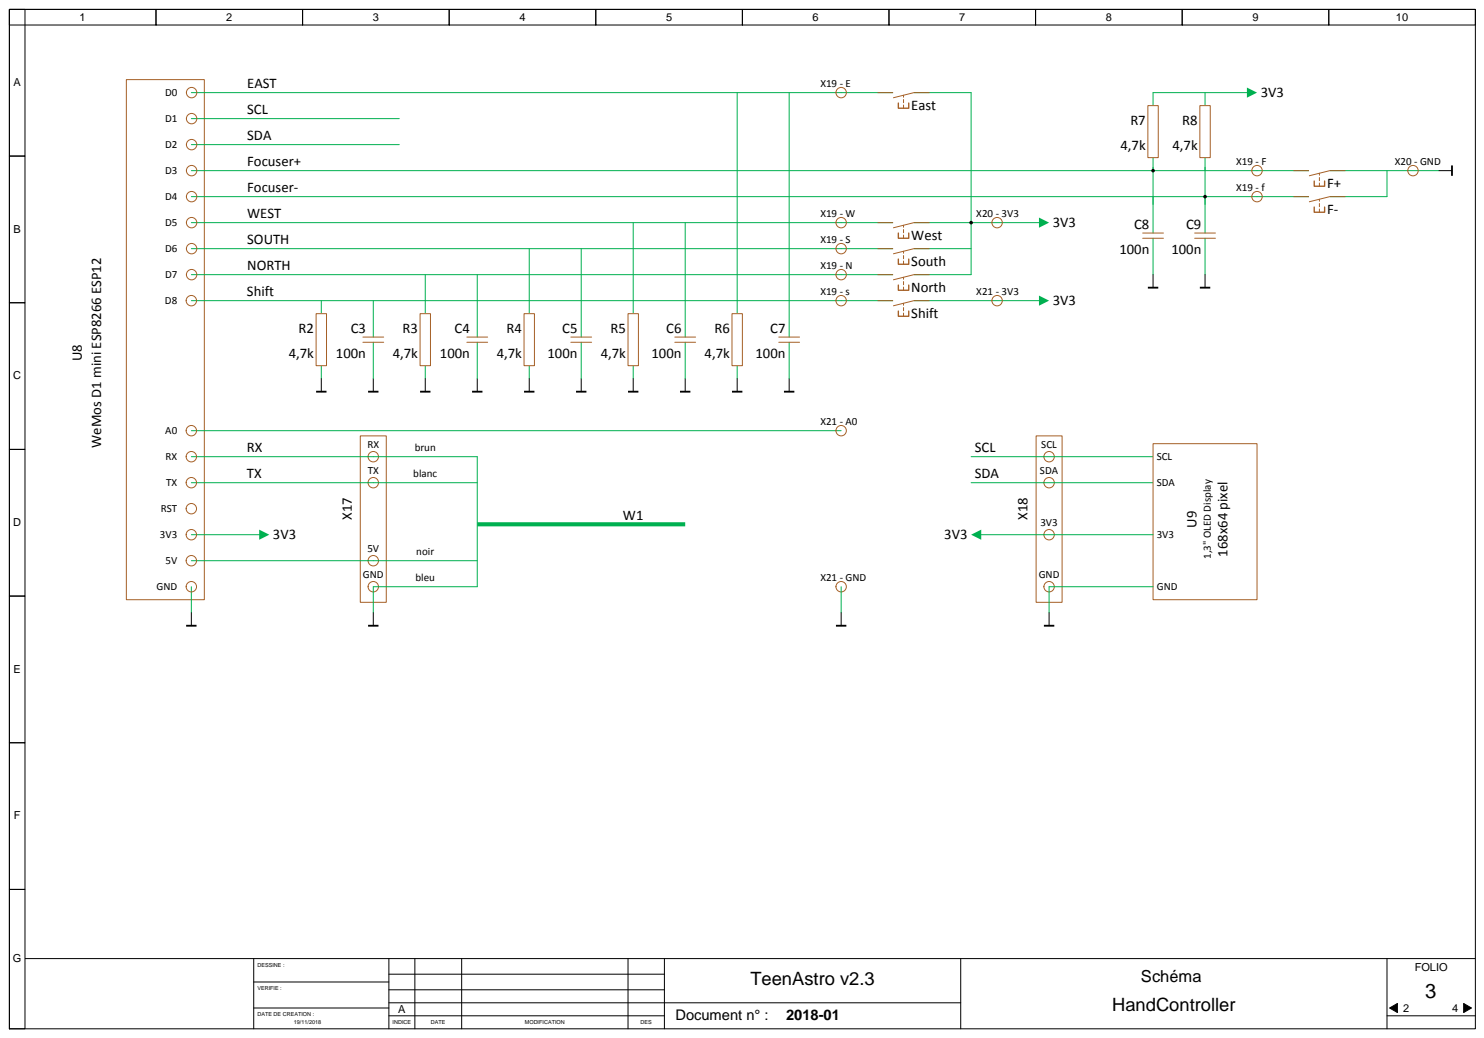
[picture p69: page 3]

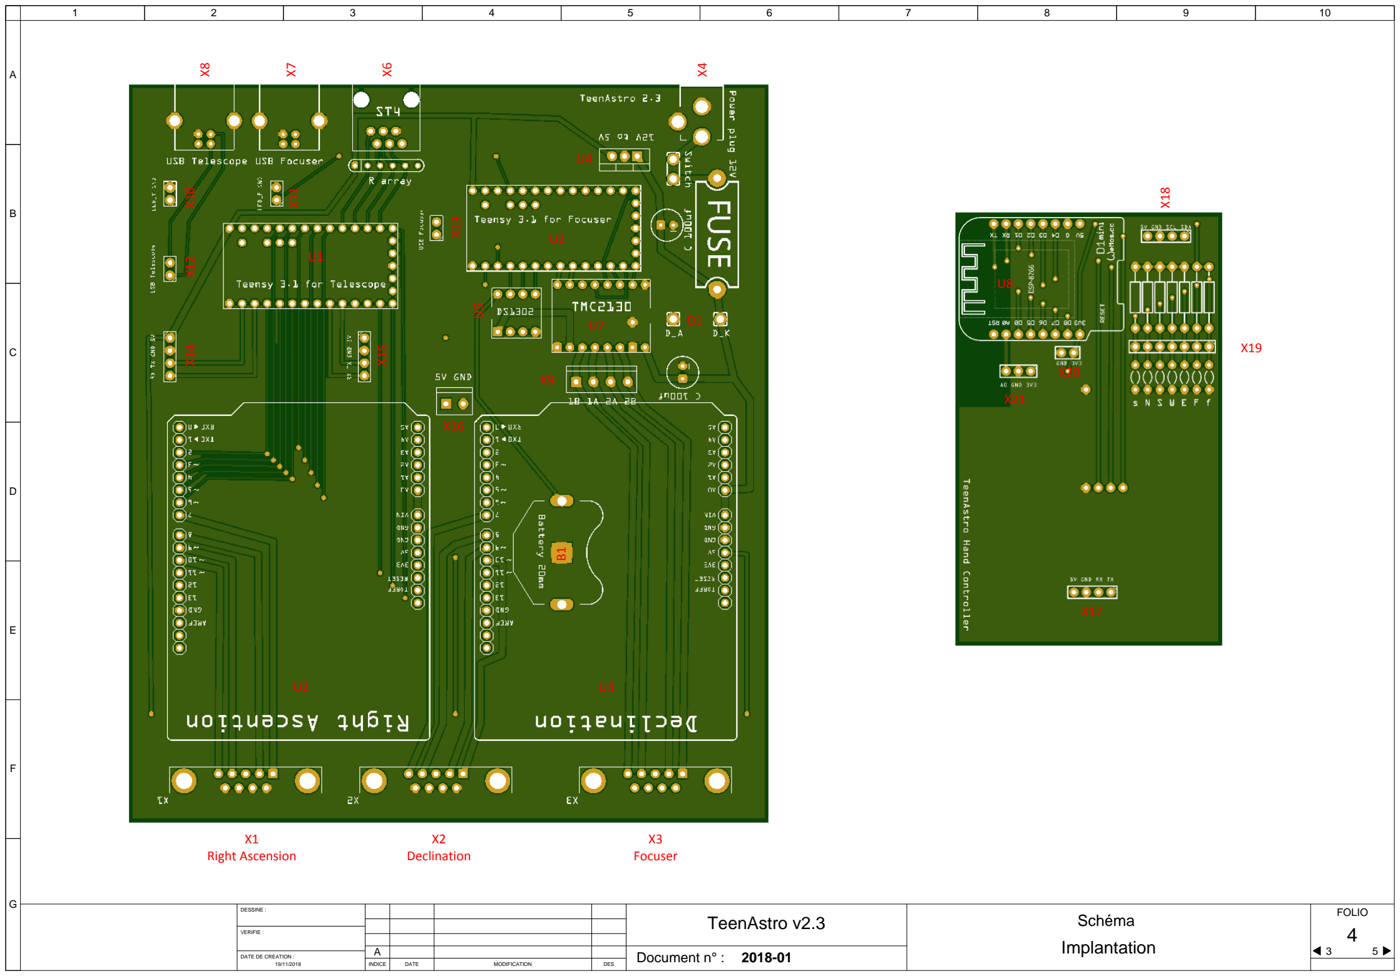
[picture p70: page 4]

FOLIO
TeenAstro v2.3 | Schéma
Document n° : INDICE | DATE | MODIFICATION | DES DATE DE CREATION : VERIFIE :

DESSINE :

19/11/2018

1 | 2 | 3 | 4 | 5 | 6 | 7 | 8 | 9 | 10

2018-01 A

A

B

D

E

C

F

G

### Implantation

4 3 | 5

# X12 X8 X14

X4

X6
X10 X1
Right Ascension | X2
Declination | X3
Focuser

B1

U2 | U3

X15 X13

X7

X9

X11

X16

U1

U2

U7 U⁵
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
