charleslemaire0/TeenAstroHardware/MainUnit/Large/V24/Teenastro schéma v2-3_1.pdf

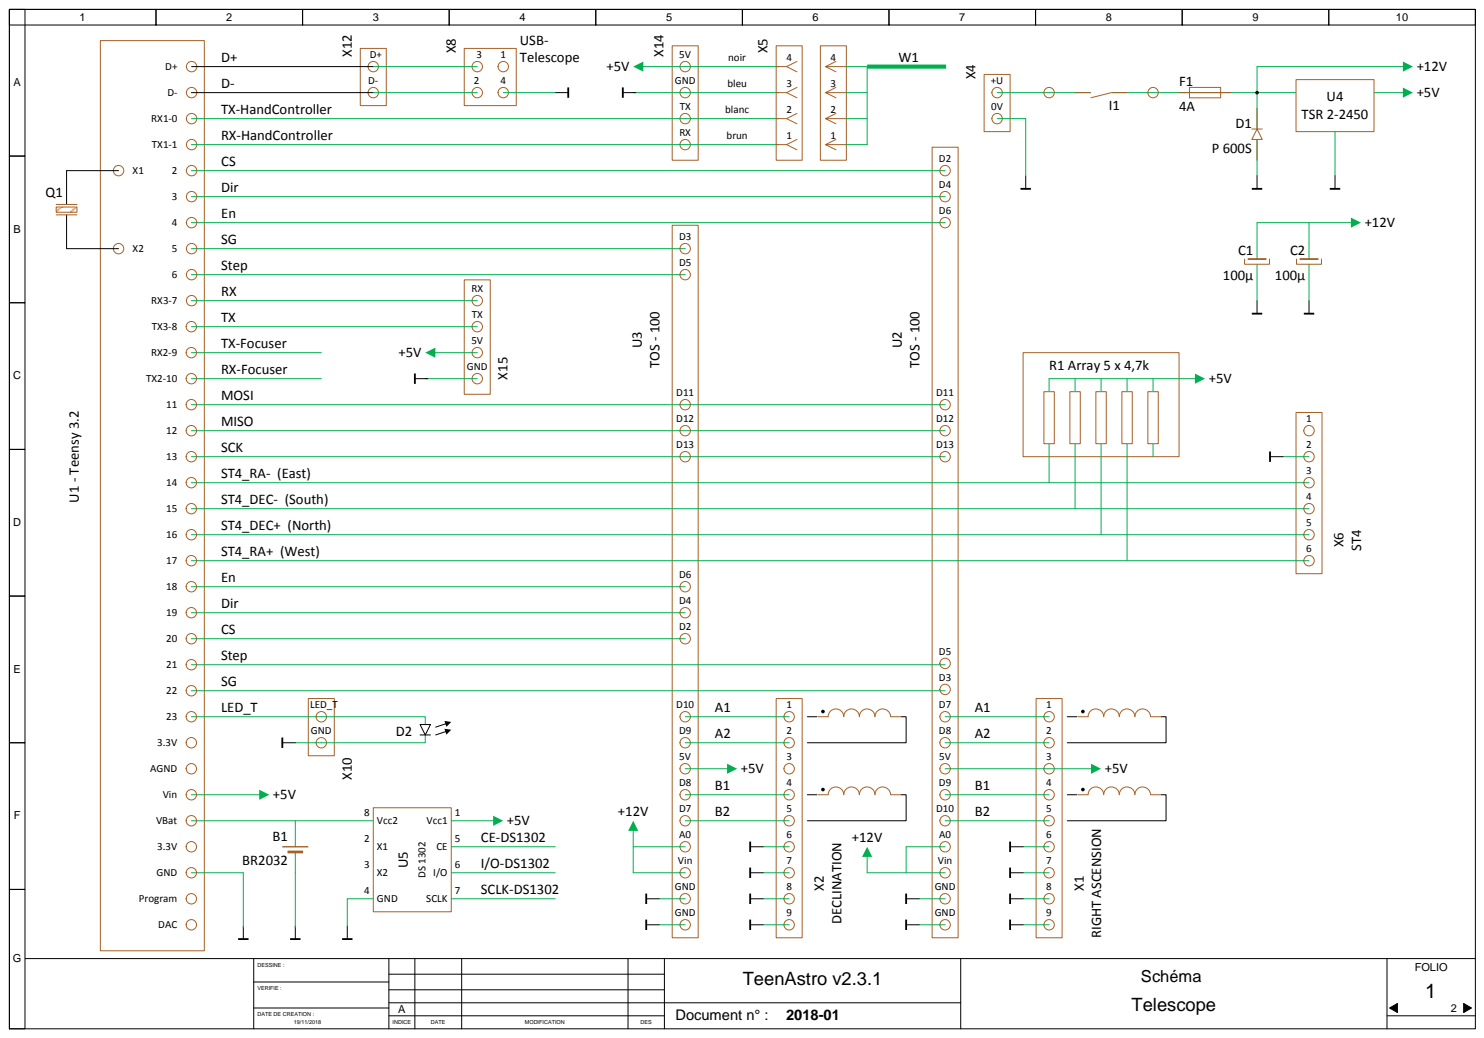
[picture p71: page 1]
ABDECFG; U1 - Teensy 3.2; TOS - 100; DECLINATION; RIGHT ASCENSION

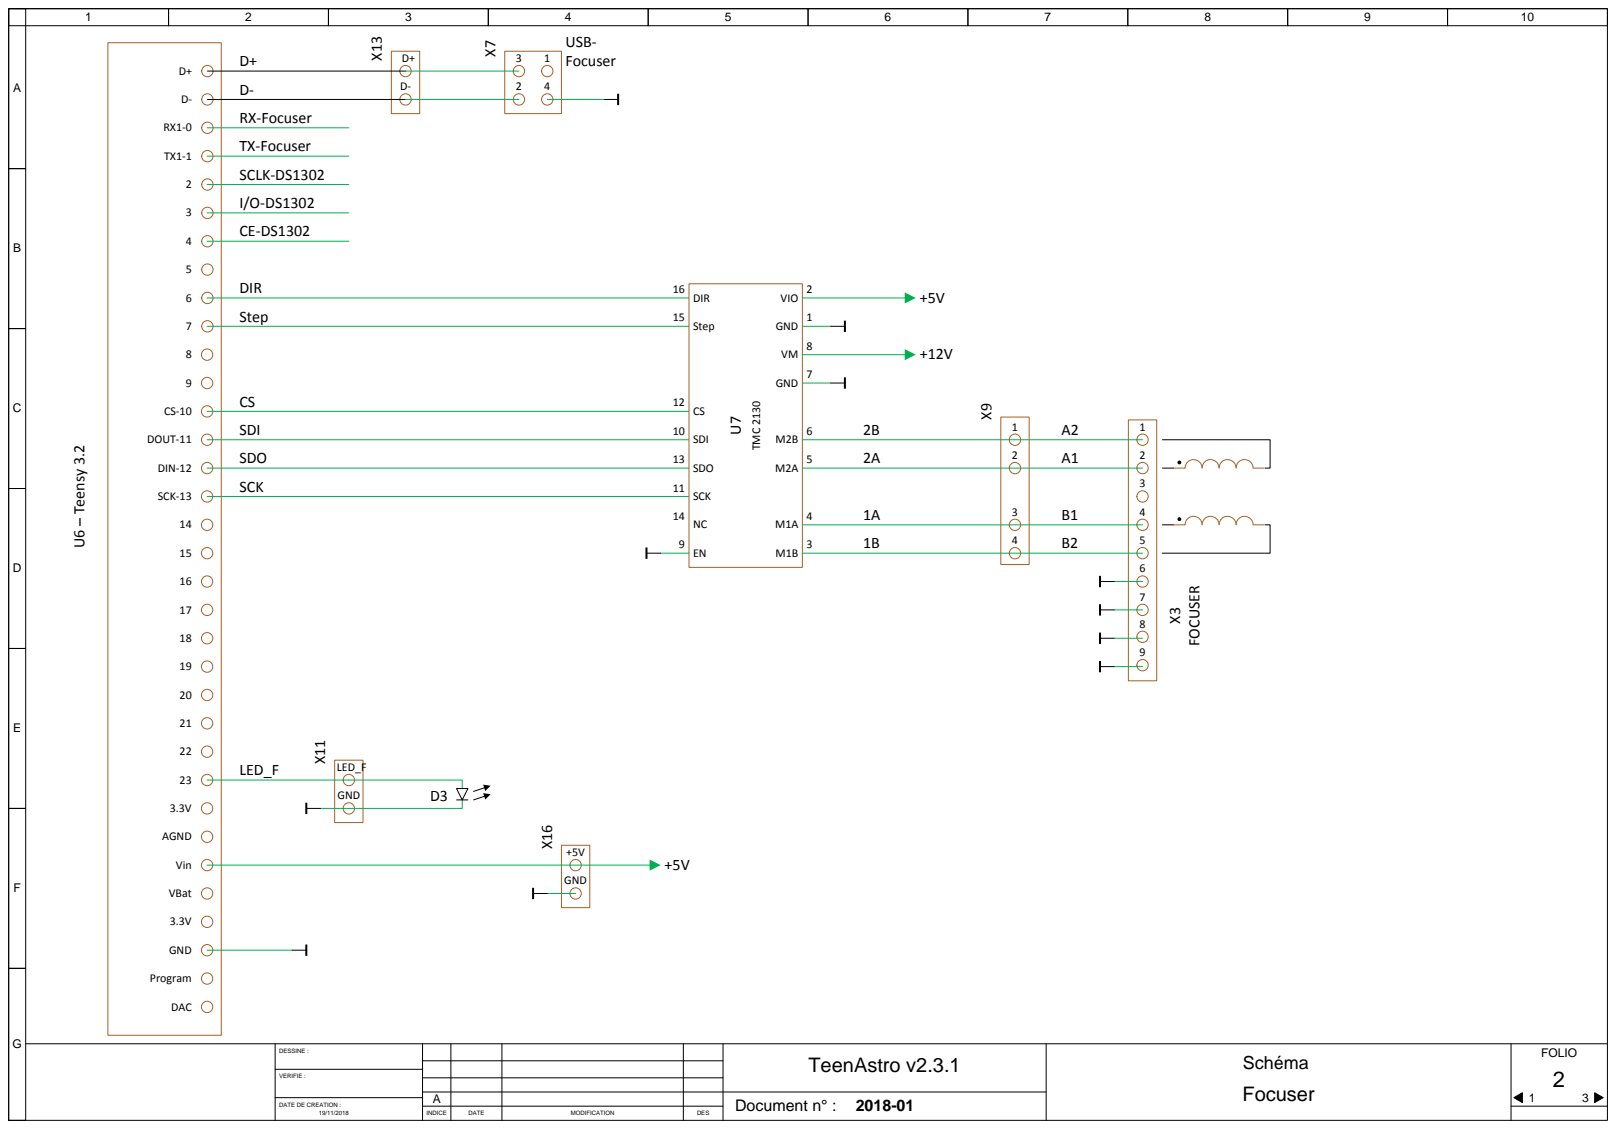
[picture p72: page 2]
ABDECFG; U6 – Teensy 3.2; TMC 2130; FOCUSER

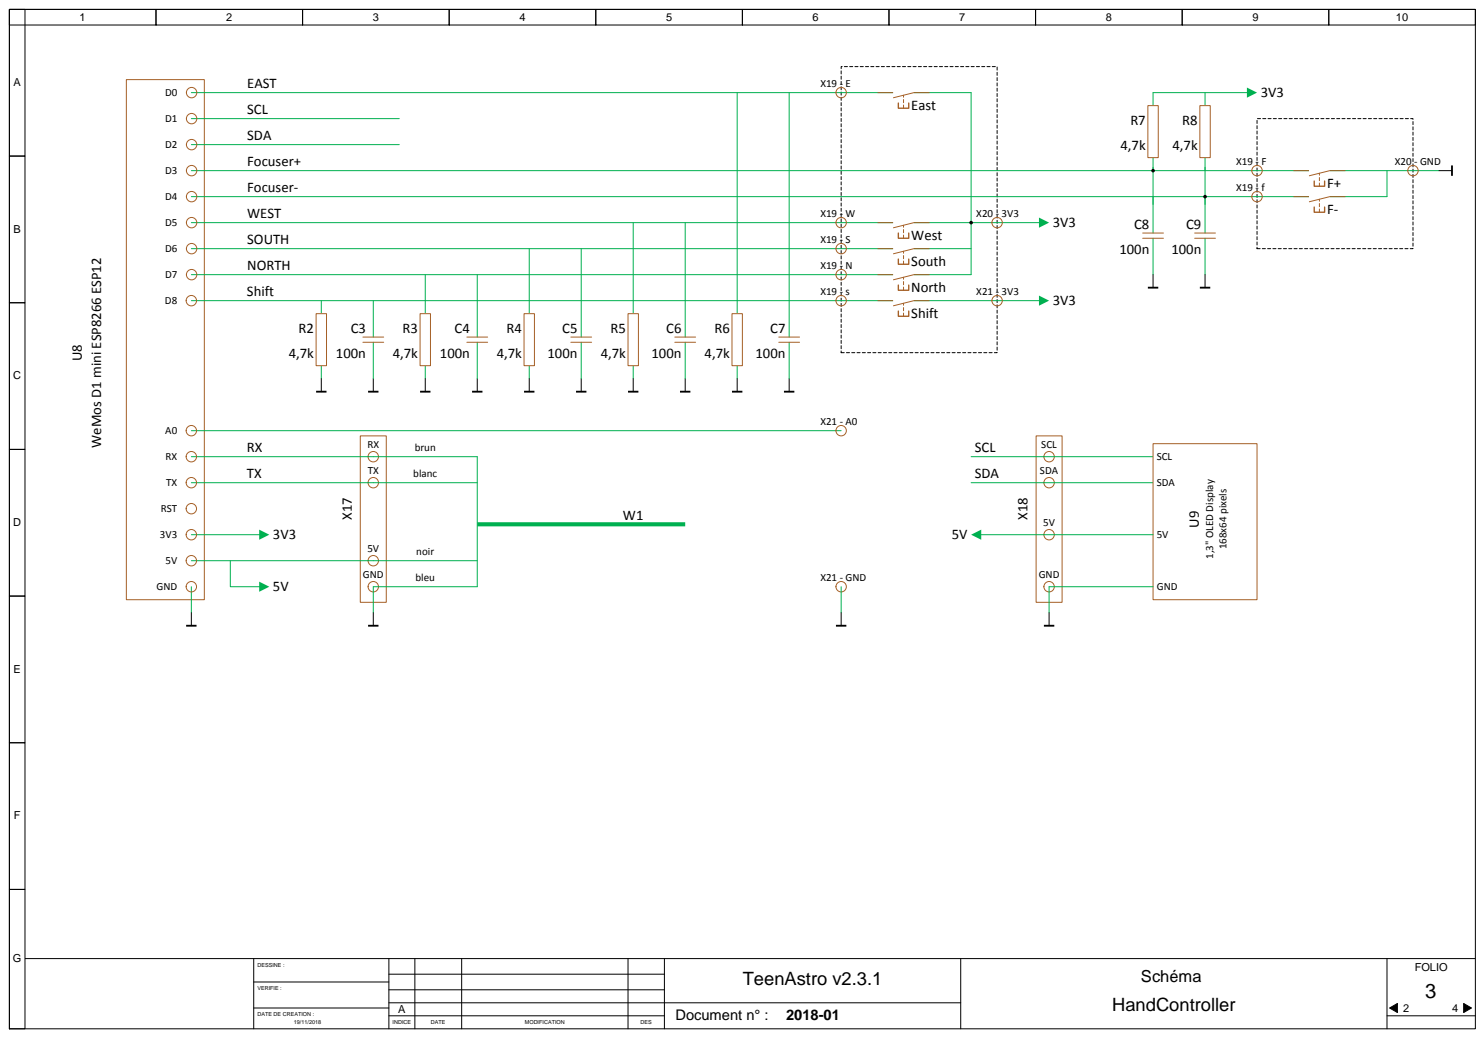
[picture p73: page 3]

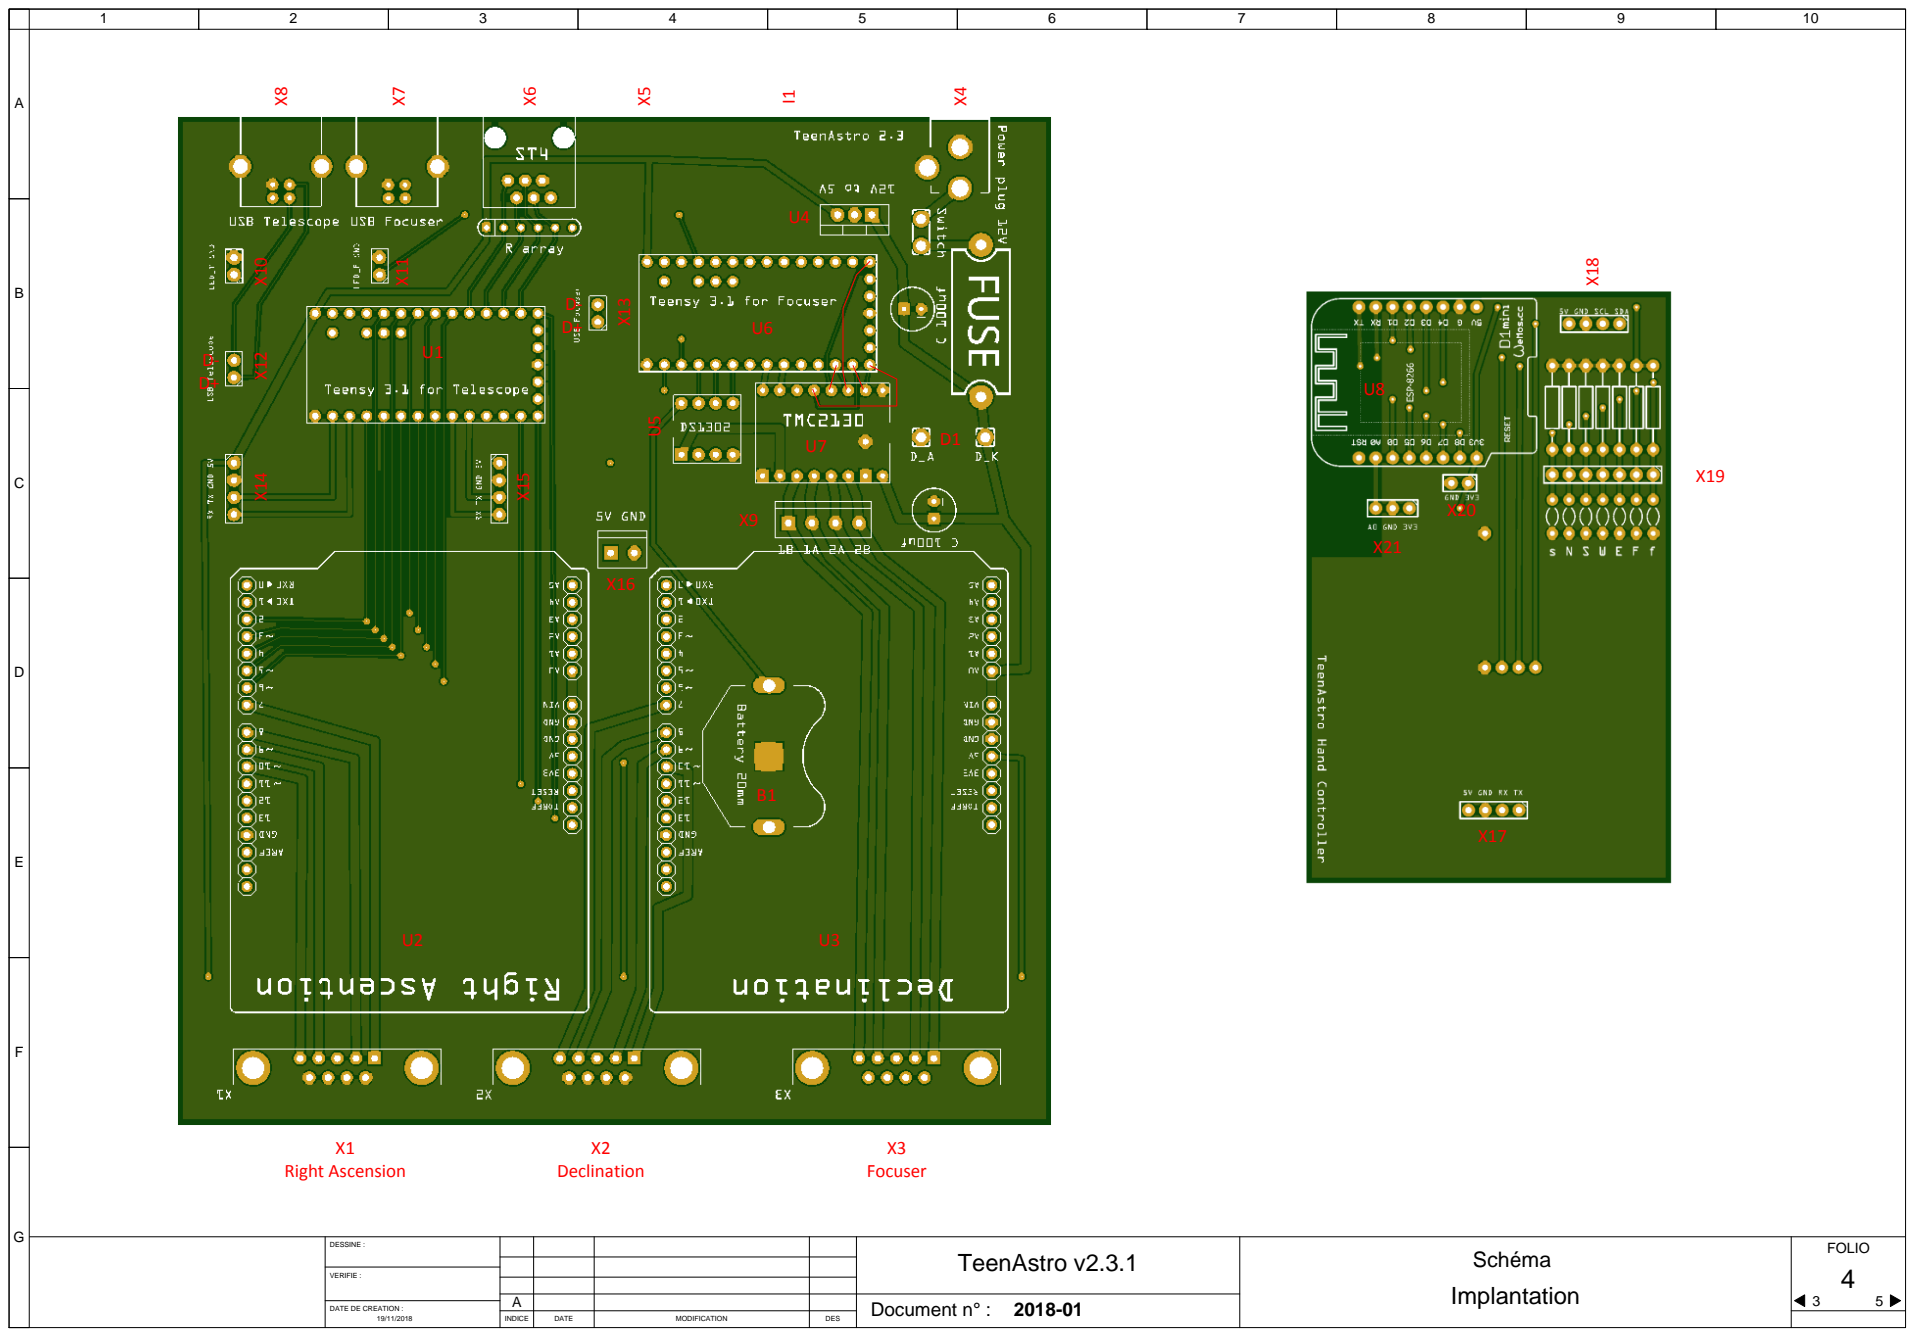
[picture p74: page 4]

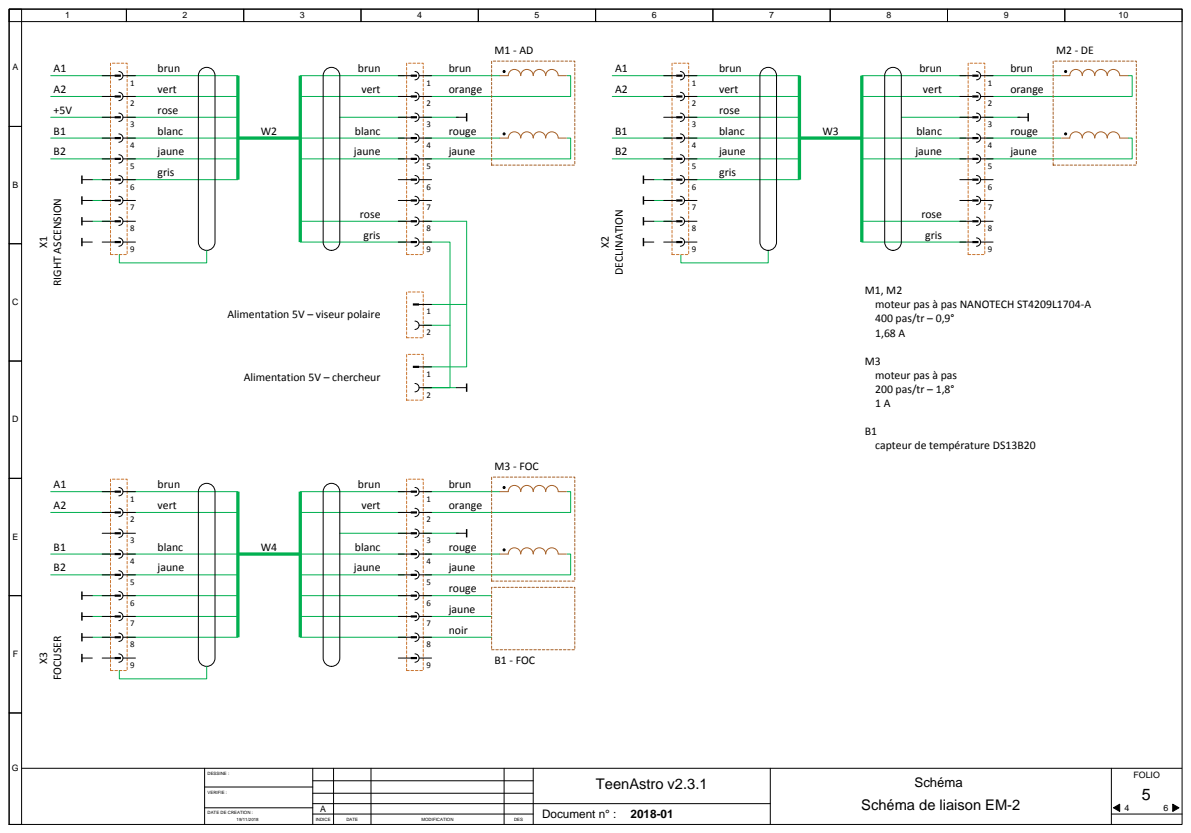
[picture p75: page 5]
FOLIO; DESSINE :; 5 Schéma de liaison EM-2; X1 RIGHT ASCENSION +5V; brun; vert; blanc; jaune; rose; gris; orange; blanc jaune; X2 DECLINATION brun; 400 pas/tr – 0,9° 1,68 A; X3 FOCUSER brun; M3 - FOC; B1 - FOC; rouge; noir

rouge jaune brun
vert

M1, M2 moteur pas à pas NANOTECH ST4209L1704-A

Alimentation 5V – viseur polaire Alimentation 5V – chercheur

moteur pas à pas 200 pas/tr – 1,8° 1 A

capteur de température DS13B20
