charleslemaire0/TeenAstroHardware/MainUnit/Large/V24/Teenastro schéma v2-4-0.pdf

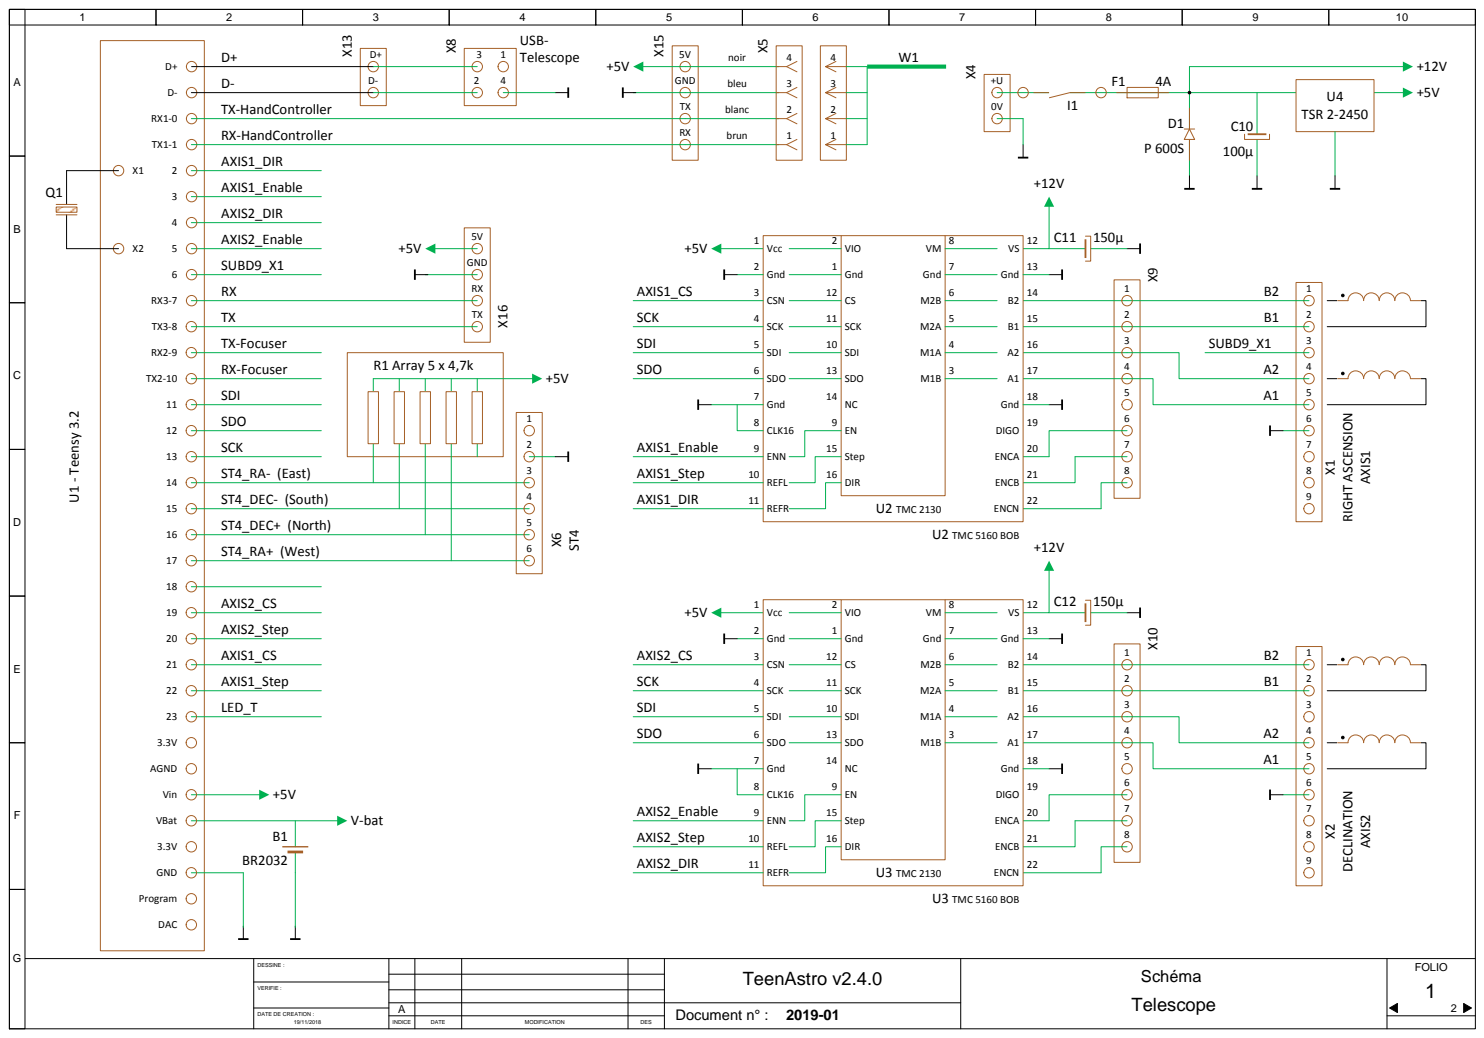
[picture p76: page 1]
ABDECFG; U1 - Teensy 3.2; DECLINATION; AXIS2; RIGHT ASCENSION; AXIS1

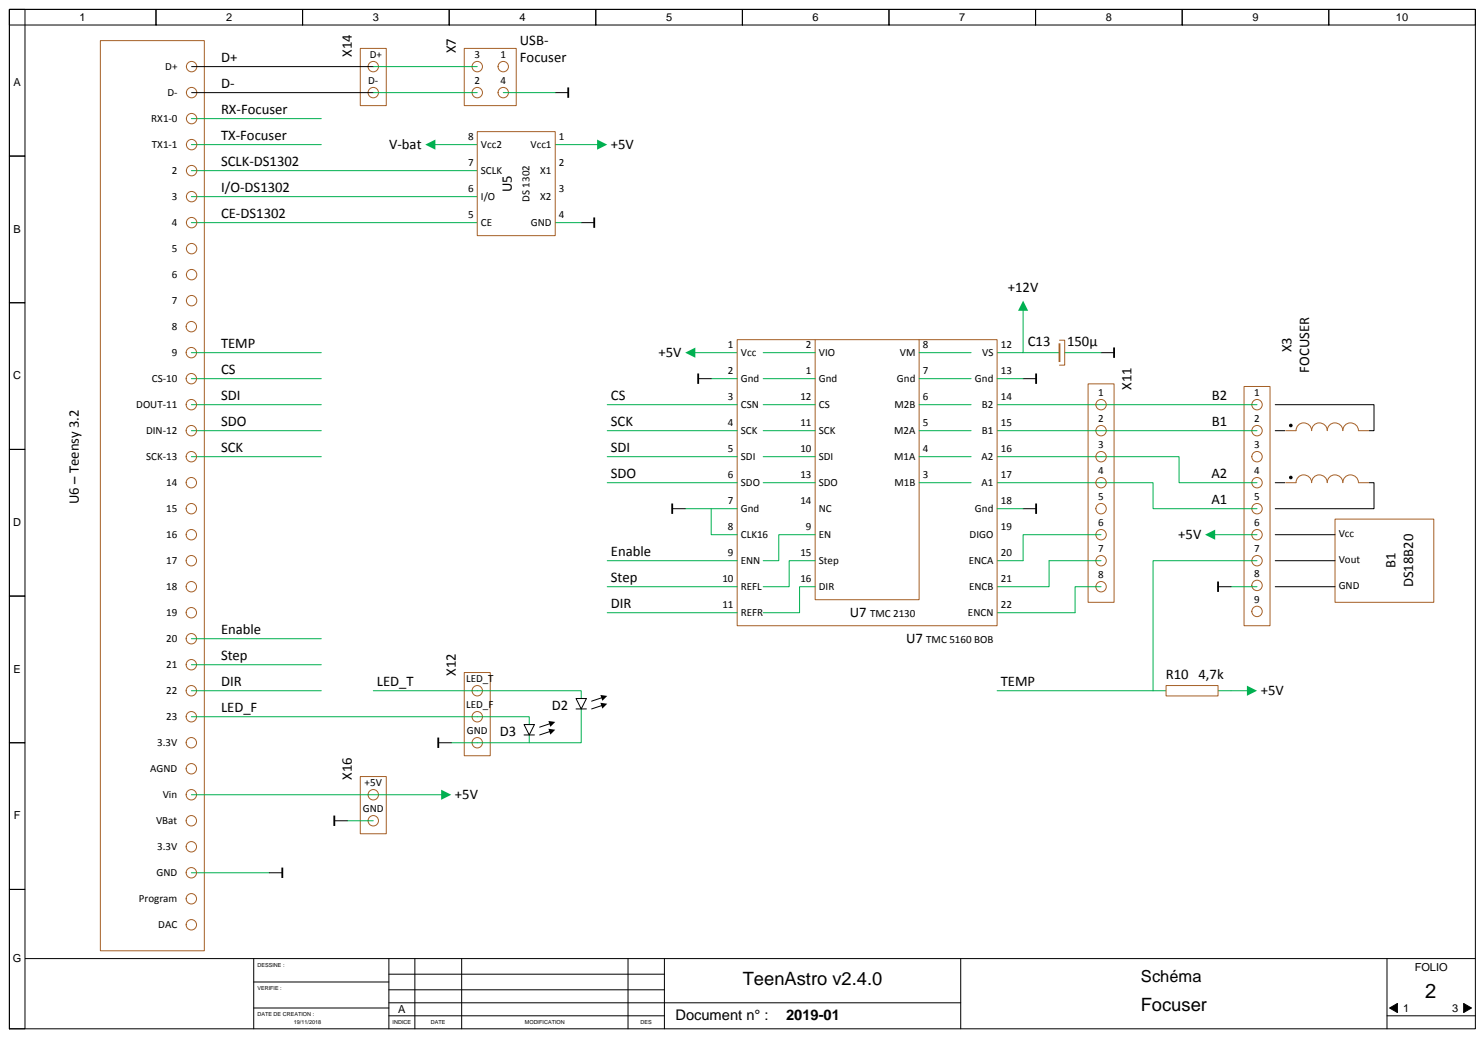
[picture p77: page 2]
ABDECFG; U6 – Teensy 3.2; FOCUSER

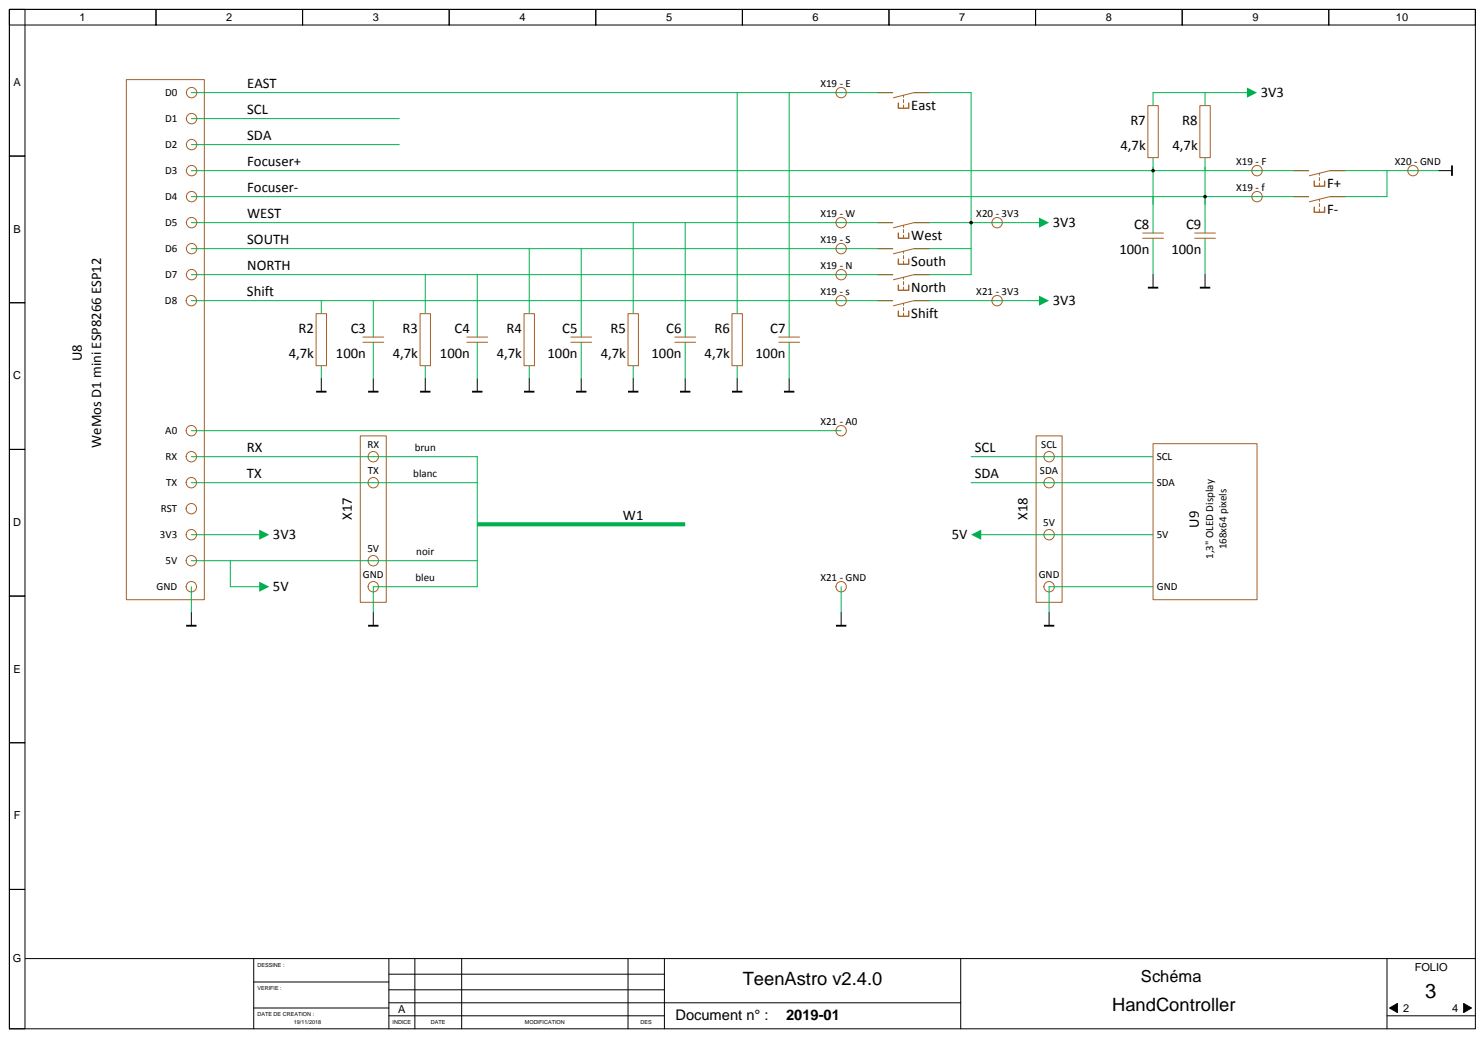
[picture p78: page 3]

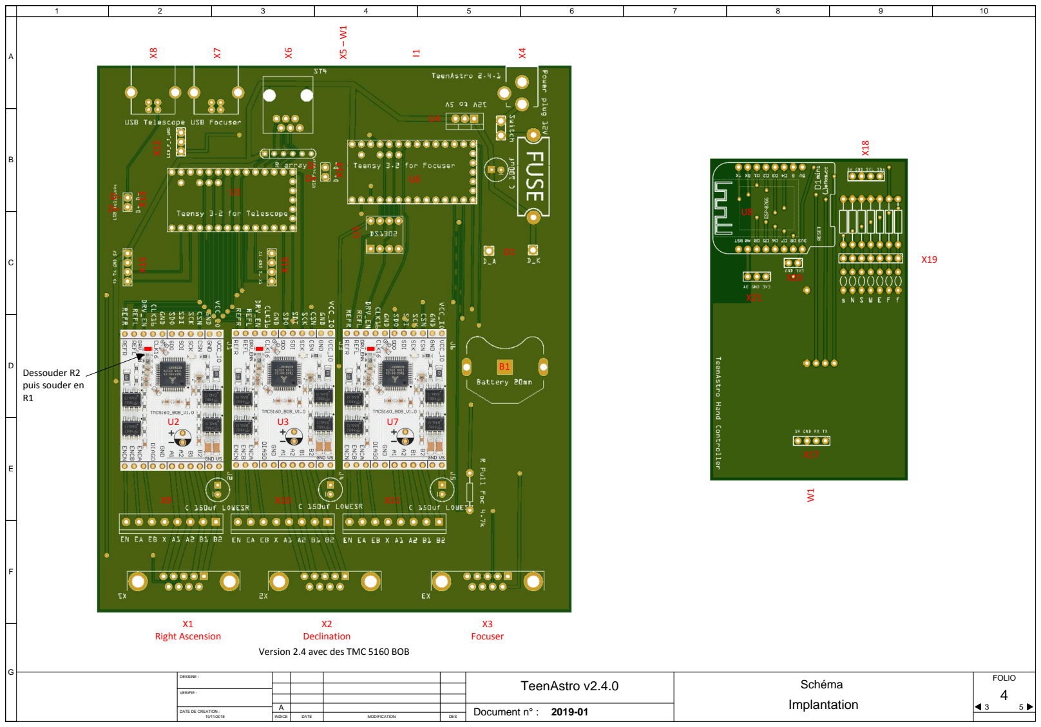
[picture p79: page 4]

Version 2.4 avec des TMC 5160 BOB

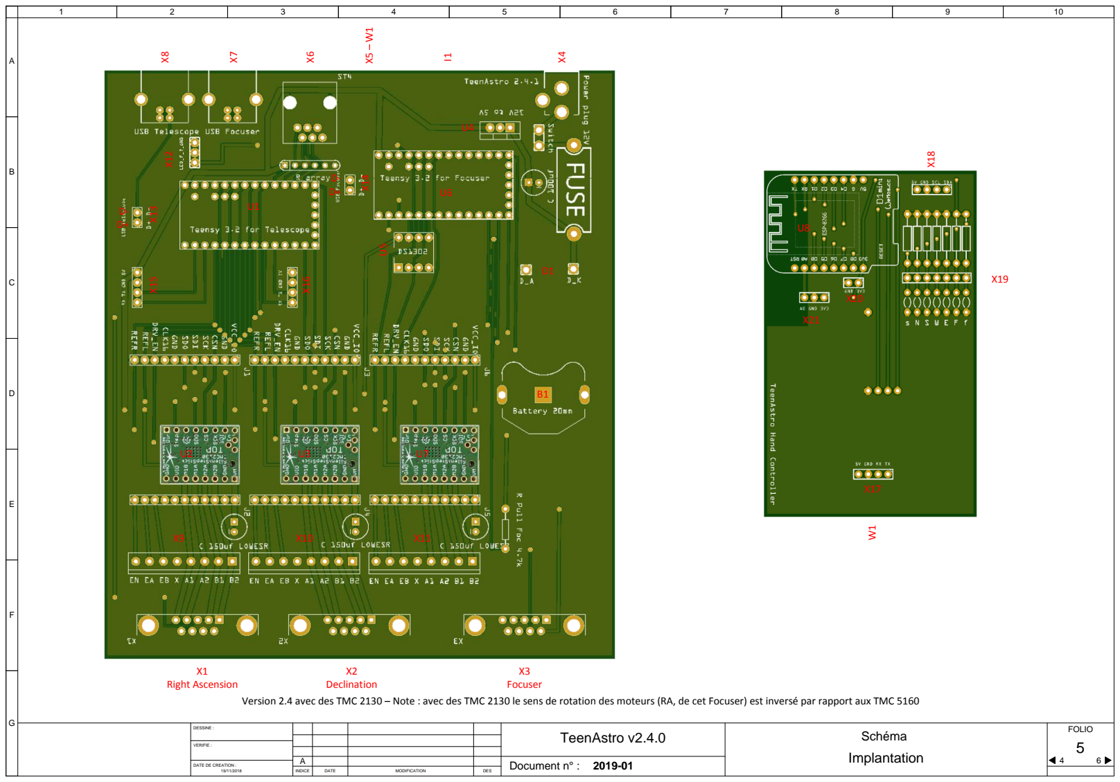
[picture p80: page 5]

Version 2.4 avec des TMC 2130 – Note : avec des TMC 2130 le sens de rotation des moteurs (RA, de cet Focuser) est inversé par rapport aux TMC 5160

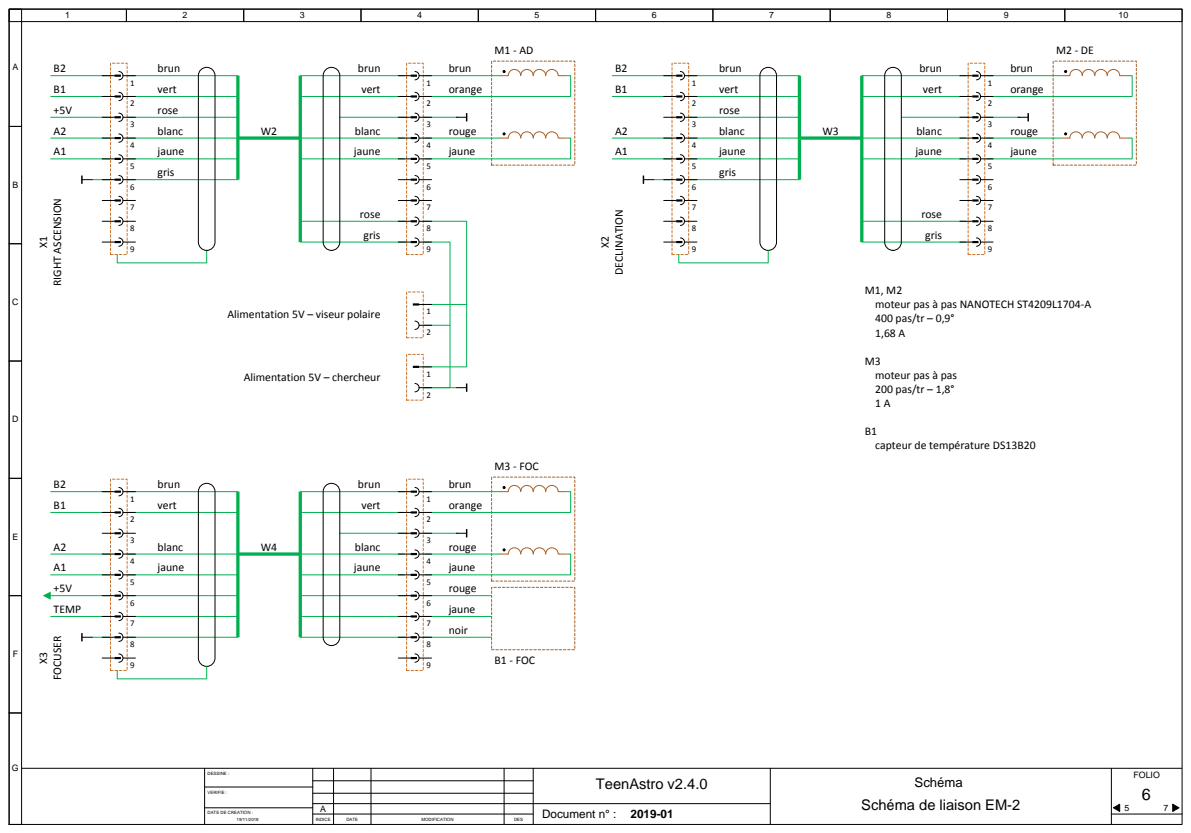
[picture p81: page 6]
FOLIO; DESSINE :; 6 Schéma de liaison EM-2; X1 RIGHT ASCENSION +5V; brun; vert; blanc; jaune; rose; gris; orange; blanc jaune; X2 DECLINATION brun; 400 pas/tr – 0,9° 1,68 A; X3 FOCUSER brun; M3 - FOC; B1 - FOC; rouge; noir A1; TEMP

rouge jaune brun
vert

M1, M2 moteur pas à pas NANOTECH ST4209L1704-A

Alimentation 5V – viseur polaire Alimentation 5V – chercheur

moteur pas à pas 200 pas/tr – 1,8° 1 A

capteur de température DS13B20
