charleslemaire0/TeenAstroHardware/MainUnit/Mini/V24/Teenastro schéma v2-4-1 mini.pdf

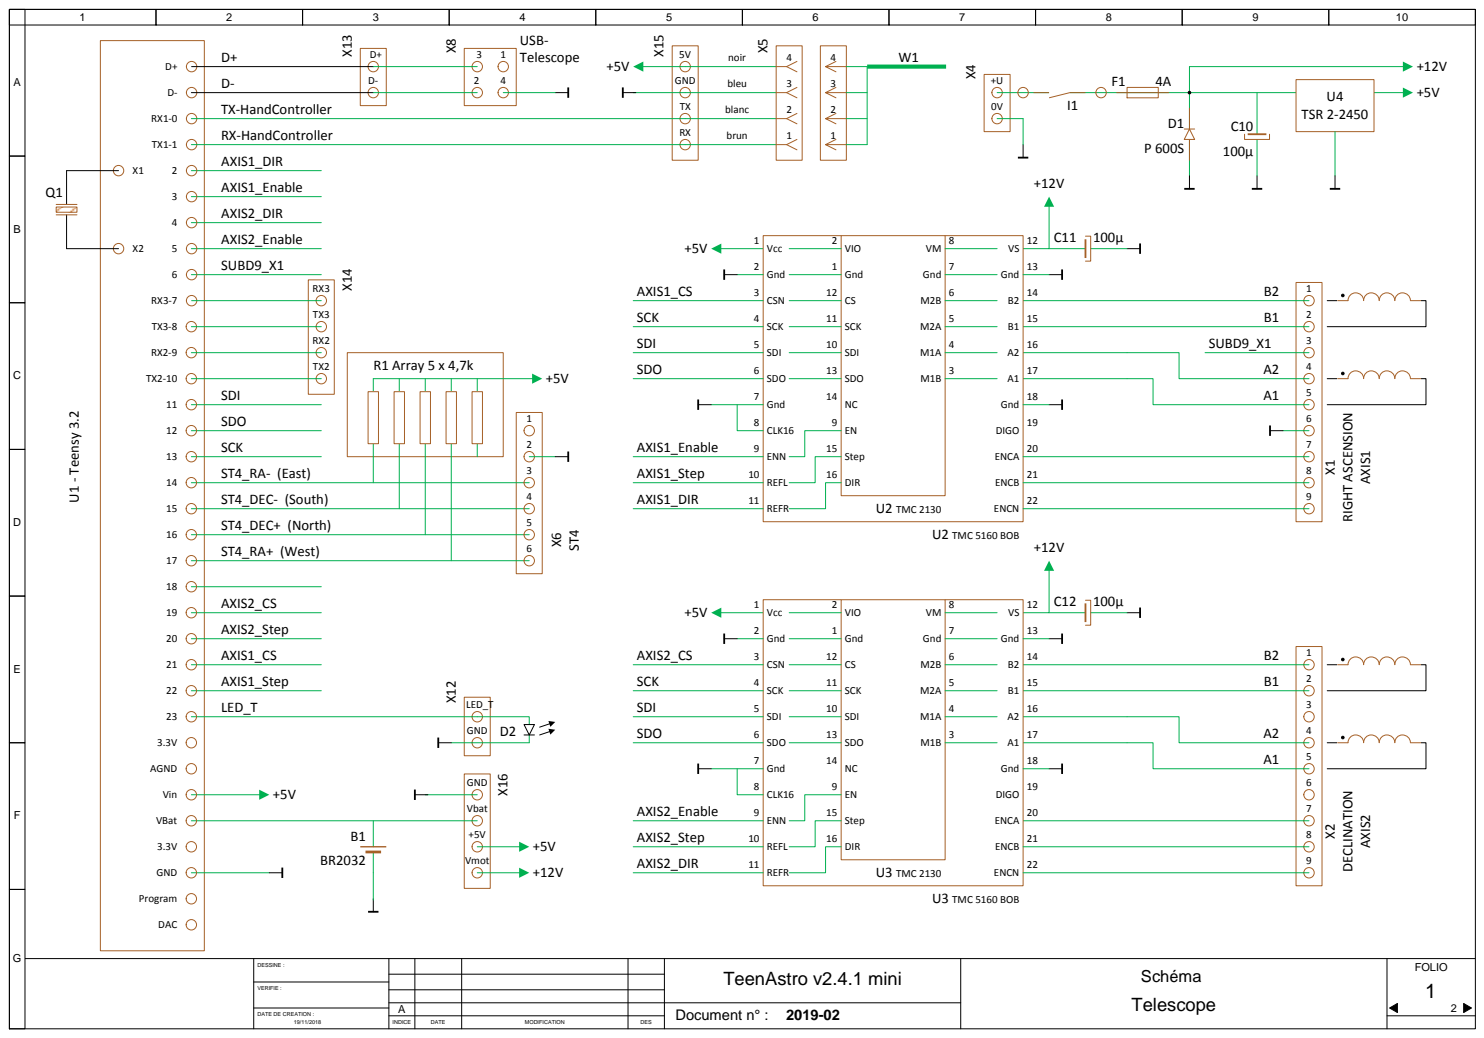
[picture p82: page 1]
ABDECFG; U1 - Teensy 3.2; DECLINATION; AXIS2; RIGHT ASCENSION; AXIS1

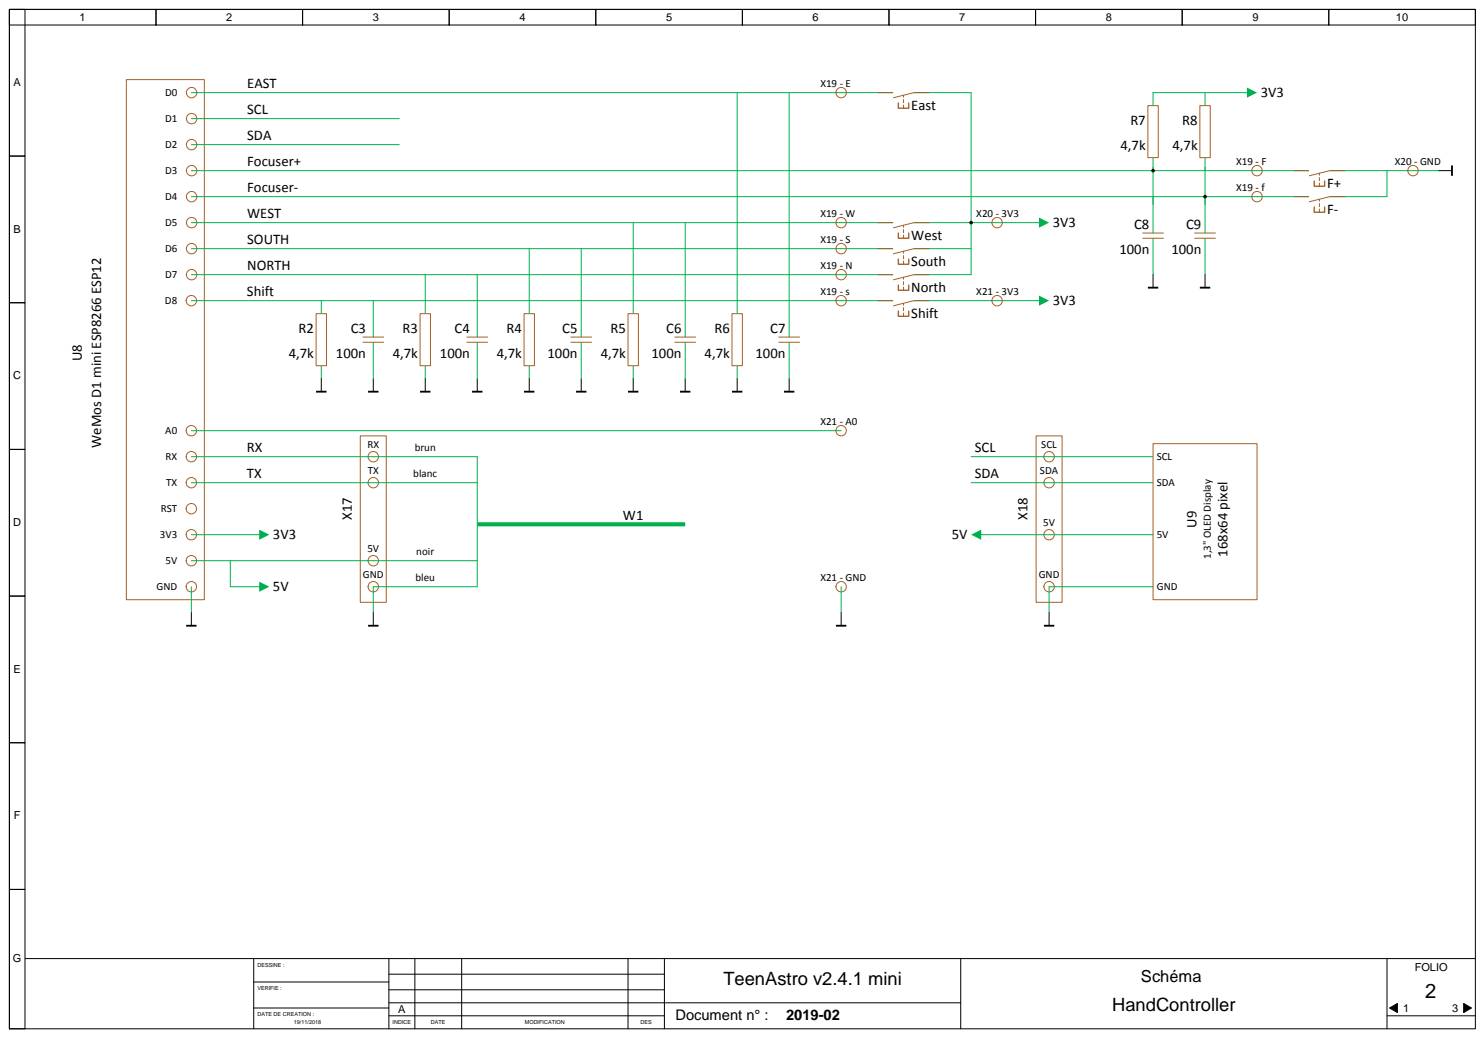
[picture p83: page 2]

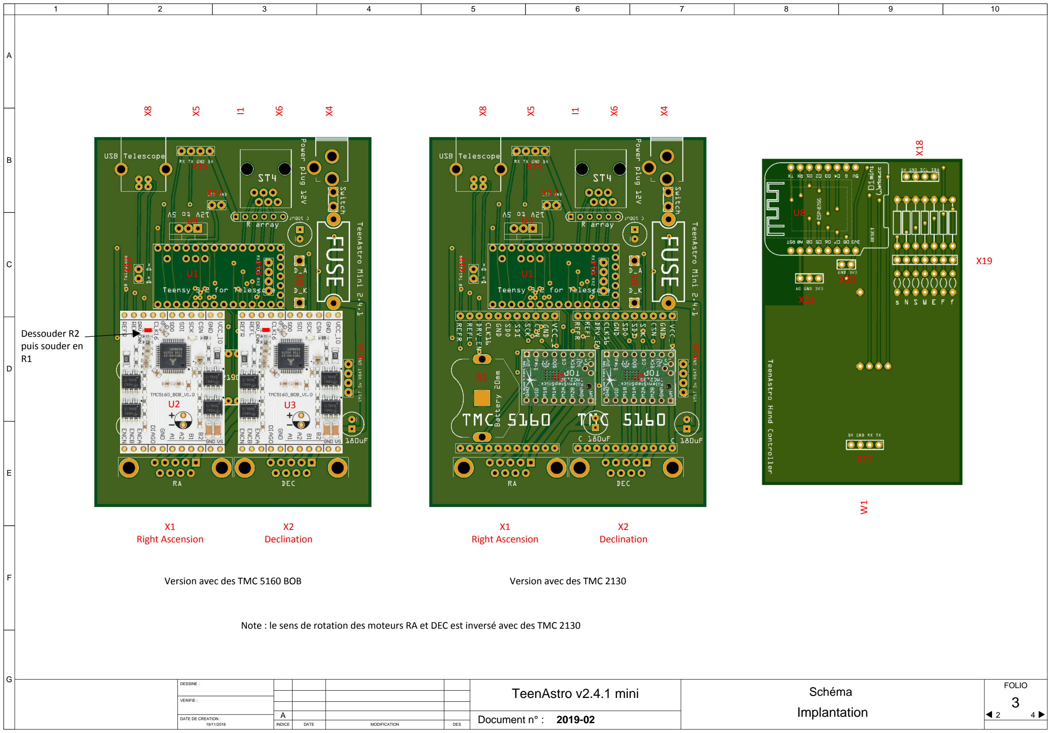
[picture p84: page 3]

FOLIO

DESSINE :

A

B

D

E

C

F

G

### Implantation

3 2 | 4

X13 X8 X15 X4

X6 X12

X1

Right Ascension | X2 Declination
B1 | X16

U1

U4 | D¹

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
Right Ascension | X2 Declination

X5
I1
Version avec des TMC 5160 BOB | Version avec des TMC 2130
U2 | U3

W1

Dessouder R2

puis souder en R1 | X14
U2 | U3

X13 X15

X12

B1 | X16

U1

U4 | D

X
1

14

Note : le sens de rotation des moteurs RA et DEC est inversé avec des TMC 2130

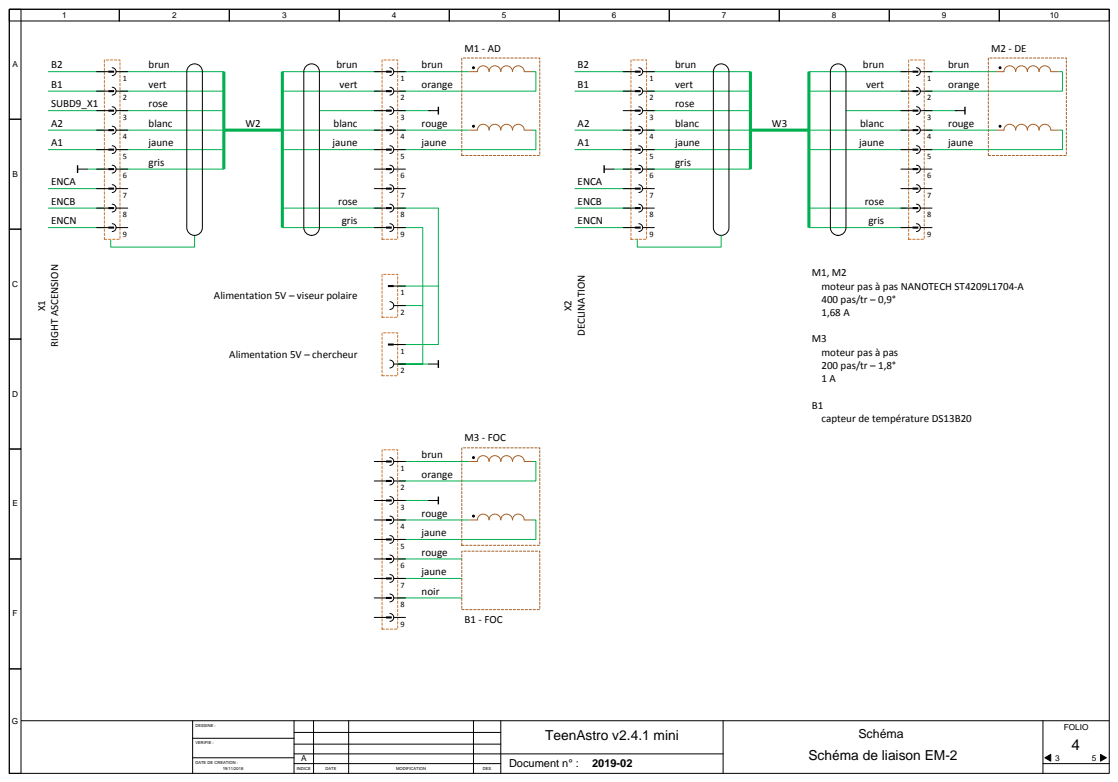
[picture p85: page 4]
FOLIO; DESSINE :; 4 Schéma de liaison EM-2; X1 RIGHT ASCENSION SUBD9_X1; brun; vert; blanc; jaune; rose; gris; orange; blanc jaune; X2 DECLINATION brun; 400 pas/tr – 0,9° 1,68 A; ENCB; ENCN; ENCA; rouge jaune; M3 - FOC; B1 - FOC; rouge; noir

rouge jaune brun
vert

M1, M2 moteur pas à pas NANOTECH ST4209L1704-A

Alimentation 5V – viseur polaire Alimentation 5V – chercheur

moteur pas à pas 200 pas/tr – 1,8° 1 A

capteur de température DS13B20
