charleslemaire0/TeenAstroHardware/(list of files, drawings)

Other design files:
MainUnit/EQ6_Kit/V25/EQ6 - V2024_01/Source/DipTrace/EQ6_250.dip
MainUnit/EQ6_Kit/V25/EQ6 - V2024_01/Source/DipTrace/EQ6_ 250.dch
MainUnit/Large/V23/Fritzing/TeenAstroV2.3.1.fzz
MainUnit/Large/V24/Fritzing/TeenAstroV2.4.1.fzz
MainUnit/Large/V25/PCB/Fritzing/TeenAstroV2.5.0.fzz
MainUnit/Mini/V24/Fritzing/TeenAstroMiniFocuserV2.4.1_db9.fzz
MainUnit/Mini/V24/Fritzing/TeenAstroMiniV2.4.1_db9.fzz
MainUnit/Mini/V24/Fritzing/TeenAstroMiniV2.4.2_db9.fzz
MainUnit/Mini/V25/Fritzing/TeenAstroMiniV2.5.0_db9.fzz
MainUnit/Mini/V25/Fritzing/TeenAstroMiniV2.5.2_db9.fzz
MainUnit/Mini/V25/Fritzing/TeenAstroMiniV2.5.3_db9.fzz
MainUnit/Mini/V25/Fritzing/TeenAstroMiniV2.5.4_db9.fzz
MainUnit/Tiny/V25/Source/DipTrace/Tiny_250.dch
MainUnit/Tiny/V25/Source/DipTrace/Tiny_250.dip
SHC/V0/PCB/Fritzing/TeenAstroHand_DevV0.0.fzz
SHC/V0/PCB/Fritzing/TeenAstroHandV0.1.fzz
SHC/V0/PCB/Fritzing/TeenAstroHandV0.fzz
SHC/V1/PCB/Fritzing/TeenAstroHandV1.0.fzz
SHC/V1/PCB/Fritzing/TeenAstroHandV1.1.fzz
SHC/V1/PCB/Fritzing/TeenAstroHandV1.2.fzz
