charleslemaire0/TeenAstroHardware/MainUnit/Mini/V25/Eagle/TeenAstro_Mini_v2-5-3_M12_a6.brd

## EAGLE design MainUnit/Mini/V25/Eagle/TeenAstro_Mini_v2-5-3_M12_a6.brd (2023-11-26)

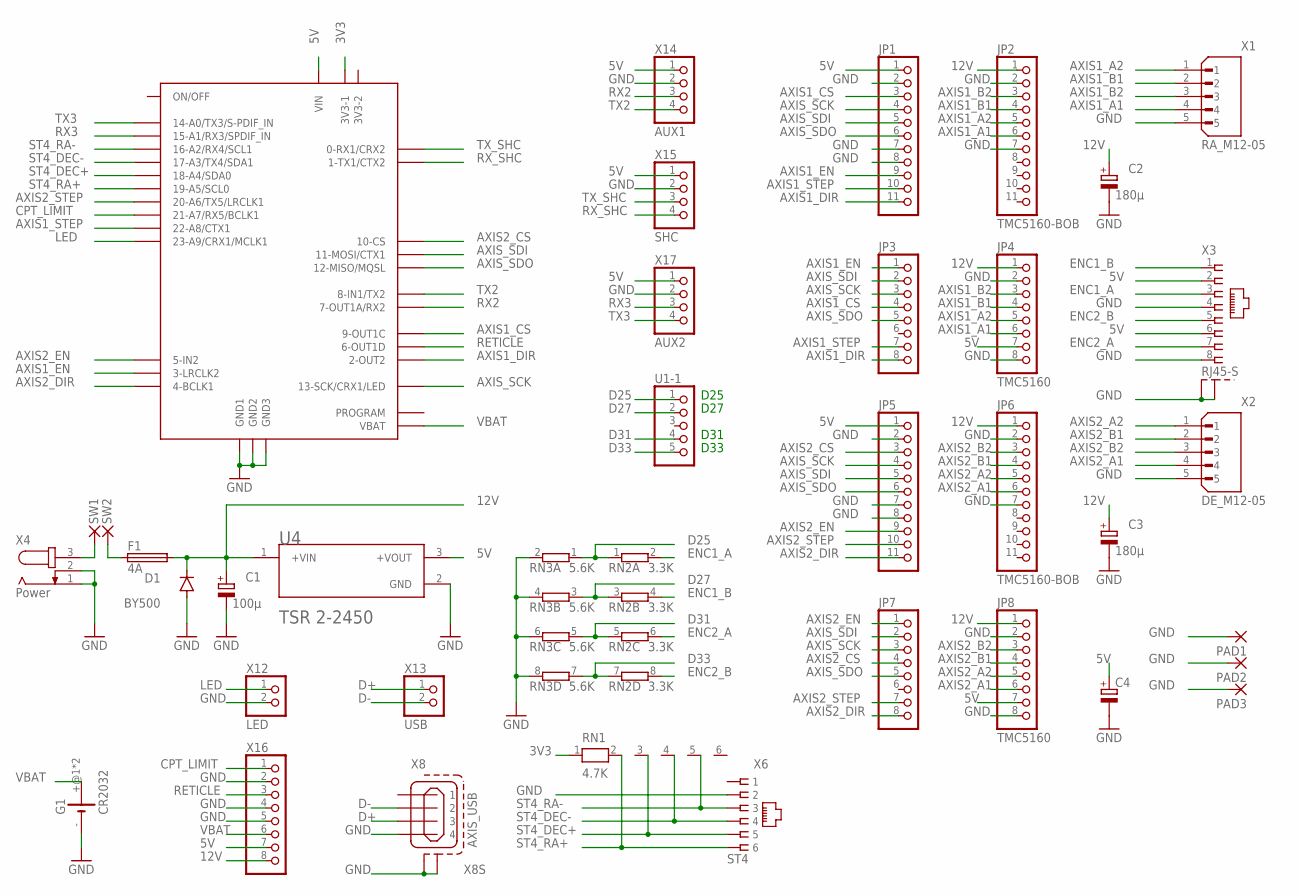
[picture p91: schematic TeenAstro_Mini_v2-5-3_M12_a6.sch]

Parts:
C1: 100µ; TAP5-80
C2, C3: 180µ; TAP5-80
C4: CPOL-EUTAP5-45; TAP5-45
D1: BY500; DO201-15
F1: 4A; SH22,5
G1: CR2032; BK-888
JP1, JP5: PINHD-1X11/LONG; 1X11
JP2, JP6: TMC5160-BOB; 1X11
JP3, JP7: PINHD-1X8/LONG; 1X08
JP4, JP8: TMC5160; 1X08
PAD1, PAD2, PAD3: 2,54/1,1
RN1: 4.7K; RN-6
RN2: 3.3K; SIL8
RN3: 5.6K; SIL8
SW1, SW2: 3,17/1,1
U1: TEENSY4.0; TEENSY40A
U1-1: PINHD-1X5/LONG; 1X05
U4: TSR_2-2450; TRACOPOWER_TSR_2-2450_0
X1: RA_M12-05; CONEC_43-01198_C
X2: DE_M12-05; CONEC_43-01198_C
X3: RJ45-S; RJ45-SHIELD
X4: Power; SPC4078
X6: ST4; RJ11-NO_SHIELD
X8: AXIS_USB; 85-32004-00X
X12: LED; 1X02
X13: USB; 1X02
X14: AUX1; 1X04
X15: SHC; 1X04
X16: PINHD-1X8/LONG; 1X08
X17: AUX2; 1X04

Connections:
3V3: RN1.1, U1.3V3-1
5V: C4.+, JP1.1, JP4.7, JP5.1, JP8.7, U1.VIN, U4.3 (+VOUT), X3.2, X3.6, X14.1, X15.1, X16.7, X17.1
12V: C1.+, C2.+, C3.+, D1.C, F1.2, JP2.1, JP4.1, JP6.1, JP8.1, U4.1 (+VIN), X16.8
AXIS1_A1: JP2.6, JP4.6, X1.4
AXIS1_A2: JP2.5, JP4.5, X1.1
AXIS1_B1: JP2.4, JP4.4, X1.2
AXIS1_B2: JP2.3, JP4.3, X1.3
AXIS1_CS: JP1.3, JP3.4, U1.9-OUT1C
AXIS1_DIR: JP1.11, JP3.8, U1.2-OUT2
AXIS1_EN: JP1.9, JP3.1, U1.3-LRCLK2
AXIS1_STEP: JP1.10, JP3.7, U1.22-A8/CTX1
AXIS2_A1: JP6.6, JP8.6, X2.4
AXIS2_A2: JP6.5, JP8.5, X2.1
AXIS2_B1: JP6.4, JP8.4, X2.2
AXIS2_B2: JP6.3, JP8.3, X2.3
AXIS2_CS: JP5.3, JP7.4, U1.10-CS/MQSR (10-CS)
AXIS2_DIR: JP5.11, JP7.8, U1.4-BCLK2 (4-BCLK1)
AXIS2_EN: JP5.9, JP7.1, U1.5-IN2
AXIS2_STEP: JP5.10, JP7.7, U1.20-A6/TX5/LRCLK1
AXIS_SCK: JP1.4, JP3.3, JP5.4, JP7.3, U1.13-SCK/CRX1/LED
AXIS_SDI: JP1.5, JP3.2, JP5.5, JP7.2, U1.11-MOSI/CTX1
AXIS_SDO: JP1.6, JP3.5, JP5.6, JP7.5, U1.12-MIO/MQSL (12-MISO/MQSL)
CPT_LIMIT: U1.21-A7/RX5/BCLK1, X16.1
D25: RN2.1, RN3.1, U1-1.1
D27: RN2.3 (1), RN3.3 (1), U1-1.2
D31: RN2.5 (1), RN3.5 (1), U1-1.4
D33: RN2.7 (1), RN3.7 (1), U1-1.5
D+: X8.3, X13.1
D-: X8.2, X13.2
ENC1_A: RN2.2, X3.3
ENC1_B: RN2.4 (2), X3.1
ENC2_A: RN2.6 (2), X3.7
ENC2_B: RN2.8 (2), X3.5
GND: C1.-, C2.-, C3.-, C4.-, D1.A, G1.-, JP1.2, JP1.7, JP1.8, JP2.2, JP2.7, JP4.2, JP4.8, JP5.2, JP5.7, JP5.8, JP6.2, JP6.7, JP8.2, JP8.8, PAD1.1, PAD2.1, PAD3.1, RN3.2, RN3.4 (2), RN3.6 (2), RN3.8 (2), U1.GND1, U1.GND2, U1.GND3, U4.2 (GND), X1.5, X2.5, X3.4, X3.8, X3.M1 (S1), X3.M2 (S2), X4.1, X4.2, X6.2, X8.4, X8.M1 (S1), X8.M2 (S2), X12.2, X14.2, X15.2, X16.2, X16.4, X16.5, X17.2
LED: U1.23-A9/CRX1/CCLK1 (23-A9/CRX1/MCLK1), X12.1
unnamed: SW1.1, X4.3
unnamed: F1.1, SW2.1
RETICLE: U1.6-OUT1D, X16.3
RX2: U1.7-RX2/OUT1A (7-OUT1A/RX2), X14.3
RX3: U1.15-A1/RX3/S-PDIF_IN (15-A1/RX3/SPDIF_IN), X17.3
RX_SHC: U1.1-TX1 (1-TX1/CTX2), X15.4
ST4_DEC+: RN1.3, U1.18-A4/SDA0, X6.5
ST4_DEC-: RN1.4, U1.17-A3/TX4/SDA1, X6.4
ST4_RA+: RN1.2, U1.19-A5/SCL0, X6.6
ST4_RA-: RN1.5, U1.16-A2/RX4/SCL1, X6.3
TX2: U1.8-TX2/IN1 (8-IN1/TX2), X14.4
TX3: U1.14-A0/TX3/S-PFI_OUT (14-A0/TX3/S-PDIF_IN), X17.4
TX_SHC: U1.0-RX1 (0-RX1/CRX2), X15.3
VBAT: G1.+@1 (+), G1.+@2 (+), U1.VBAT, X16.6

Notes on the sheet:
D25
D27
D31
D33

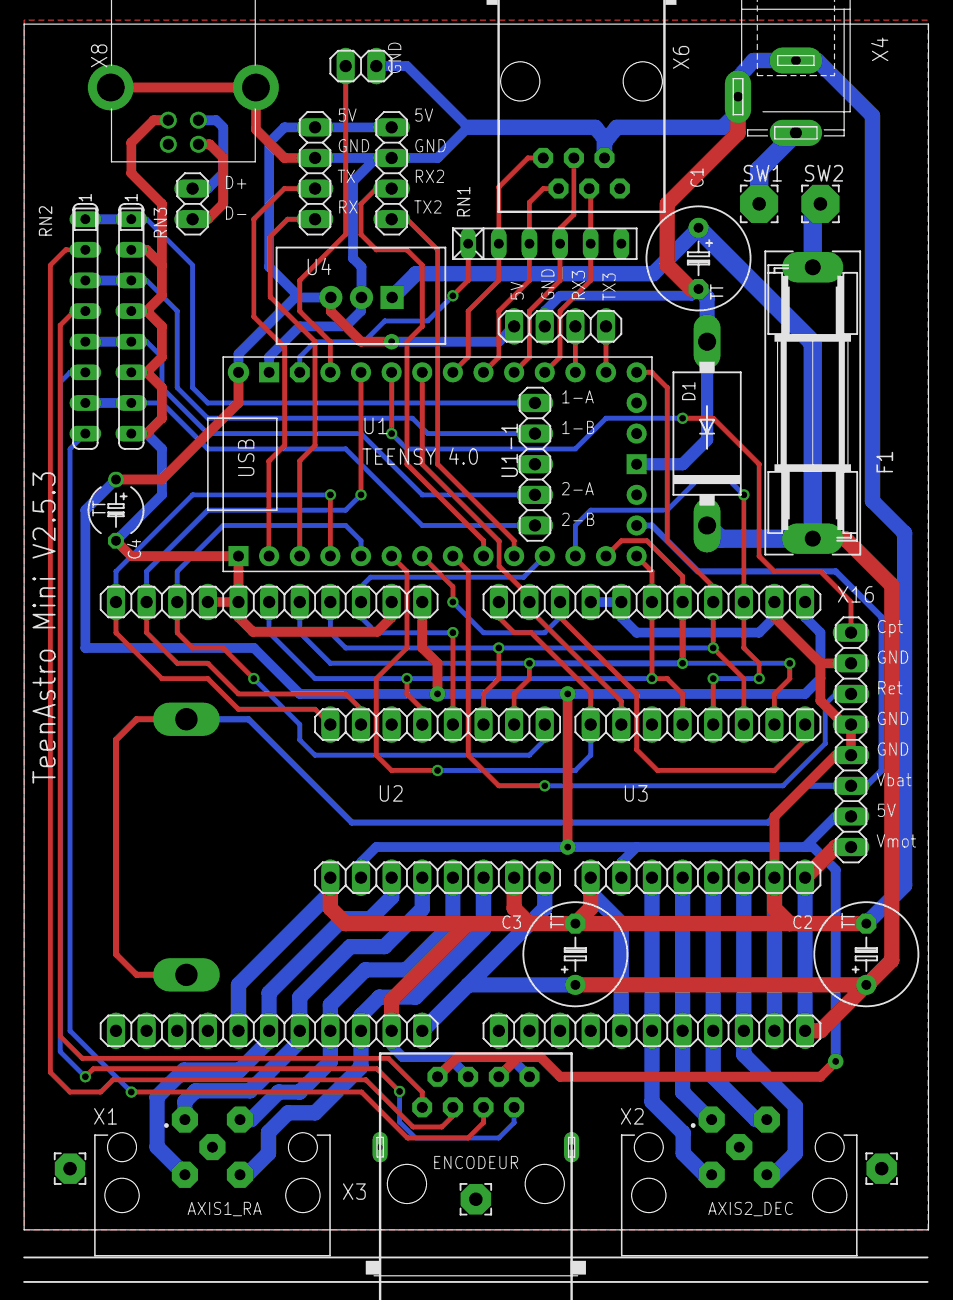
[picture p92: board TeenAstro_Mini_v2-5-3_M12_a6.brd from above]

Board: 2 copper layers, 75.0 x 103.8 mm, 38 parts (1 on the bottom side), 49 nets.
