charleslemaire0/TeenAstroHardware/(commit log)

2023-02-04 migrate Hardware definition
    [AP 400 QMD Motor Housing Lid.stl, AP 400 QMD Motor Housing.stl, BottoPlateForEq6.stl, Case.stl, Front.stl, Front_L_wo_glass_APEM_IB.stp, Front_M_wo_glass_APEM_IB.stp, Plate Motor DEC.stp]
2023-03-05 fix a bug for the version 2.5.1
    [TeenAstroMiniV2.5.1_db9.fzz, TeenAstroMiniV2.5.2_db9.fzz]
2023-04-01 Refactor storage
    [AP 400 QMD Motor Housing Lid.stl, AP 400 QMD Motor Housing.stl, BottoPlateForEq6.stl, Case.stl, Front.stl, Front_L_wo_glass_APEM_IB.stp, Front_M_wo_glass_APEM_IB.stp, Plate Motor DEC.stp]
2023-04-12 add version SHC 1.1
    [TeenAstroHandV1.1.fzz]
2023-06-18 Add version 2.5.3
    [TeenAstroMiniV2.5.3_db9.fzz]
2023-06-26 Release SHC 1.2
    [TeenAstroHandV1.2.fzz]
2023-06-26 cosmetic change
    [TeenAstroHandV1.2.fzz]
2023-07-23 Release 2.5.4 mini Main Unit
    [TeenAstroMiniV2.5.4_db9.fzz]
2023-07-23 Add Model A Nema 17 cover
    [NEMA17_Cover_A.stl]
2023-07-23 Add Nema23 from thingiverse
    [Motor_Cover_Nema23_angle.STL, Motor_Cover_Nema23_angle_large.STL, Motor_Cover_Nema23_angle_large_option2.STL, Motor_Cover_Nema23_angle_option2.STL, Motor_Cover_Nema23_straight.STL, Motor_Cover_Nema23_straight_option2.STL, Motor_Cover_Nema24_angle.STL, Motor_Cover_Nema24_angle_large.STL]
2023-08-20 add alu case drawing for teenAstro focuser
2023-08-20 Add EAF motor drawing
2023-11-26 add eagle Version of the TeenAstro Mini
    [TeenAstro_Mini_v2-5-3_M12_a6.brd, TeenAstro_Mini_v2-5-3_M12_a6.sch]
2024-01-28 update Tiny version from Jean David
    [000 boitier full.SLDASM, 111 tiny-front.DXF, 111 tiny-front.SLDPRT, 111 tiny-front.STEP, 111 tiny-front.STL, 112 tiny-back.DXF, 112 tiny-back.SLDPRT, 112 tiny-back.STEP]
2024-02-11 add EQ6 kit
    [000 mini254foc2 sur facade.SLDASM, 111b facade EQ6.DXF, 111b facade EQ6.SLDPRT, 112 entretoise_12mm.SLDPRT, 112 entretoise_12mm.STL, BOM EQ6.ods, Board_CI_EQ6.sldprt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]
